BuildEase2026/mf-icf-approval-1f4119fc49/ALW/docs/struct/ES26-020-ALW-RF-00 Alwen - Wall Plate Setting-Out for the Truss Designer.pdf

Do not scale. All dimensions in mm. Check all dimensions on site.

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
ICF PACKAGE: Nudura ICF formwork and accessories are our supply. Raft and foundations AS PER THE ARCHITECTURAL DRAWINGS; joist ledgers by the engineer. Floors, stairs, partitions, roof and joinery are drawn as DESIGN ASSUMPTIONS for coordination - check by the relevant professional.

## FOR APPROVAL - NOT FOR CONSTRUCTION

### WALL PLATE SCHEDULE

### 47 X 150 C24 TREATED, TOP +5,076

Plate | Length Runs | On the core
WP1 | 5,804 x 356 - 6,159 | y 101.6 - 251.6
WP2 | 5,804 x 6,445 - 12,248 | y 101.6 - 251.6
WP3 | 5,804 x 356 - 6,159 | y 7739.9 - 7889.9
WP4 | 5,804 x 6,445 - 12,248 | y 7739.9 - 7889.9
x from the left outer ICF face, y from the front outer ICF face.

BEARING

Item | mm
Plate centre from outer face | 176.6
Span between plate centres (front-rear) | 7,638
Outer ICF face to face | 7,992
Heel at the outer face | 183.1
Overhang beyond the outer face | 307

GABLE LADDERS

Item | mm
Gable left (x 0) + right (x 12,604): 2 No. ladders each, one per slope
Section, on edge (ladder depth 122) | 47x122 TR26
Overall width, barge outer to rail inner face | 1,005
Projection beyond the outer ICF face | 326
Back span inside the outer ICF face | 679
About the wall centre (177.8 in): out / in | 504 / 501
Barge + inner rail (per gable) | 4 No. x 5,253
Outriggers (per gable) | | 20 No. x 910 @ 578 on slope
Restraint straps <= 2 m c/c into the ICF core. Gable ICF raked to the ladder underside.
WP1 | WP2
WP3 | WP4
356 | 5804 | 286 | 5804 | 356
| | 12604
356 | 5804 | 286 | 5804 | 356

102

150

7488 150

102

7992

7,638 BEARING c/c

## WALL PLATE SETTING-OUT PLAN

Scale 1:100 | dims from the OUTER ICF face; dashed = eaves line
102 | 150 | 104

47 183.1

307

Trussed rafter
(truss designer)

47x150 C24 PLATE
on the core

M12 resin anchor
@1,200 (engineer)

152.4 CONCRETE
CORE - bearing

101.6 EPS - NOT
STRUCTURAL

## EAVES SECTION AT THE PLATE

Scale 1:10 | front / rear walls (see DT-03)

NOTES
1. FOR THE TRUSS DESIGNER: the external walls are Nudura 6in XR35 insulated concrete formwork - 101.6 EPS foam / 152.4 reinforced concrete core / 101.6 EPS foam (355.6 overall), rendered outside (Dryvit ICF 500), lined inside.
2. The EPS is formwork and insulation only - it is NOT STRUCTURAL and must carry no load. The trusses bear on the 47 x 150 C24 treated WALL PLATE, which sits on the CONCRETE CORE ONLY: 101.6 to 251.6 in from the outer ICF face.
3. Core top +5,029 above GF FFL; plate top (truss bearing) +5,076. All dimensions are from the OUTER face of the ICF (the render adds 8).
4. Plate fixing: M12 resin anchors into the core @ 1,200 max, 300 from each end and each side of every joint - DESIGN ASSUMPTION, engineer to confirm. Truss clips to the plate and restraint straps by the truss designer.
5. Heel 183.1 (plate top to rafter top at the outer ICF face); eaves overhang 307 beyond the outer ICF face (tiles 382). Pitch 35 deg.
6. GABLE ROOF: plates on the front and rear eaves walls only, stopping at the gable inner faces; the gables are raked ICF under 47 x 122 TR26 gable ladders (no plate on the gables).
7. PARTY WALL (6in Standard, 285.8): the plates stop either side of it; the party wall rises to the roof line between the two roofs - no trusses bear on it.
8. Alwen 4P2B Type A (semi). Datum 0 = GF FFL. Architect: Beech Developments -BD0165-ALW rev A (JHG 28/08/26).

REVISIONS

REV | DATE | DESCRIPTION
P01 | 29.10.26 | Approval issue

CLIENT
Beech Developments (NW) Ltd

PROJECT
Maes Y Felin, Glan Conwy - Alwen

DRAWING TITLE

## ALWEN - WALL PLATE SETTING-OUT FOR THE TRUSS DESIGNER

SCALE
AS SHOWN

SIZE
A3

DATE
29.10.26

DRAWN
TS
CHECKED | APPROVED

STATUS

### FOR APPROVAL

DRAWING No.

# ES26-020-ALW-RF-00

REV

P01
