BuildEase2026/mf-icf-approval-1f4119fc49/sequence/docs/ES26-020-3B4P B07 - Load plans.pdf

# Delivery 1 - Load 1 of 2 - Artic 13.6 m

10 pallets in 5 of 5 floor positions | 163 forms | tallest column 2586 mm of 2650 mm inside height
Column heights do not fall to the tail: unload order was kept, which the crew needs, and it conflicts with loading tallest-forward on this load.

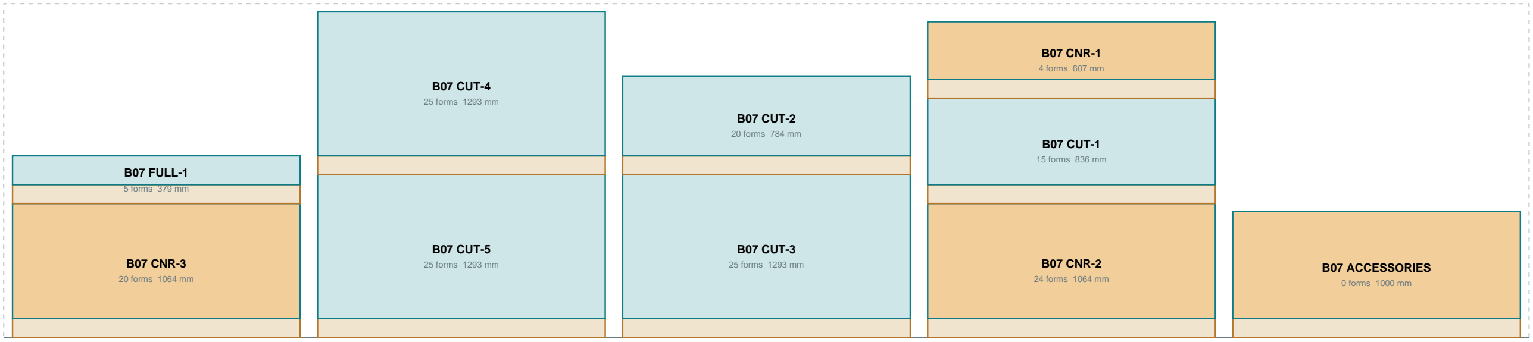
[picture p1: figure]
B07 CNR-3; 20 forms 1064 mm; B07 FULL-1; 5 forms 379 mm; B07 CUT-5; 25 forms 1293 mm; B07 CUT-4; B07 CUT-3; B07 CUT-2; 20 forms 784 mm; B07 CNR-2; 24 forms 1064 mm; B07 CUT-1; 15 forms 836 mm; B07 CNR-1; 4 forms 607 mm; B07 ACCESSORIES; 0 forms 1000 mm

HEADBOARD | TAIL

inside height 2650 mm

position 1

position 2

position 3

position 4

position 5

Unload order - 9 of 9 pallets come off out of build order, the price of stacking tallest forward
1. B07 ACCESSORIES 6in XR35 accessoriess 0 forms courses -
2. B07 CNR-1 6in XR35 corners 4 forms courses FB course 1
3. B07 CUT-1 6in XR35 straights 15 forms courses FB course 1
4. B07 CNR-2 6in XR35 corners 24 forms courses L1 courses 1-6
5. B07 CUT-2 6in Std straights 20 forms courses L1 courses 1-6
6. B07 CUT-3 6in XR35 straights 25 forms courses L1 courses 1-6
7. B07 CUT-4 6in XR35 straights 25 forms courses L1 courses 2-5
8. B07 CUT-5 6in XR35 straights 25 forms courses L1 courses 4-6
9. B07 FULL-1 6in XR35 straights 5 forms courses L1 course 6
10. B07 CNR-3 6in XR35 corners 20 forms courses L2 courses 1-5
WAGON STACKING PLAN | D1 LOAD 1

Tallest column at the headboard; last needed on the floor

PROJECT | ES26-020 Maes Y Felin - B07 plots 16, 17
VEHICLE | Artic 13.6 m
PALLETS | 10
FORMS | 163
POSITIONS | 5 of 5
TALLEST | 2586 mm

# Delivery 1 - Load 2 of 2 - 18 t rigid

5 pallets in 3 of 3 floor positions | 127 forms | tallest column 2586 mm of 2650 mm inside height
Column heights do not fall to the tail: unload order was kept, which the crew needs, and it conflicts with loading tallest-forward on this load.
HEADBOARD | TAIL

inside height 2650 mm

B07 CUT-10
21 forms 1293 mm

position 1

B07 CUT-9
25 forms 1293 mm

B07 CUT-8
25 forms 1293 mm

position 2

B07 CUT-6
31 forms 1259 mm

B07 CUT-7
25 forms 1293 mm

position 3

Unload order - 4 of 4 pallets come off out of build order, the price of stacking tallest forward
1. B07 CUT-7 6in XR35 straights 25 forms courses L2 courses 1, 2, 3, 5, 7, 9
2. B07 CUT-6 6in Std straights 31 forms courses L2 courses 1-12
3. B07 CUT-8 6in XR35 straights 25 forms courses L2 courses 3-7
4. B07 CUT-9 6in XR35 straights 25 forms courses L2 courses 5, 6, 7, 9, 10
5. B07 CUT-10 6in XR35 straights 21 forms courses L2 courses 7-11
WAGON STACKING PLAN | D1 LOAD 2

Tallest column at the headboard; last needed on the floor

PROJECT | ES26-020 Maes Y Felin - B07 plots 16, 17
VEHICLE | 18 t rigid
PALLETS | 5
FORMS | 127
POSITIONS | 3 of 3
TALLEST | 2586 mm
