BuildEase2026/mf-icf-approval-1f4119fc49/sequence/docs/ES26-020-ALW B01 - Load plans.pdf

# Delivery 1 - Load 1 of 2 - Artic 13.6 m

9 pallets in 5 of 5 floor positions | 156 forms | tallest column 2394 mm of 2650 mm inside height
Column heights do not fall to the tail: unload order was kept, which the crew needs, and it conflicts with loading tallest-forward on this load.

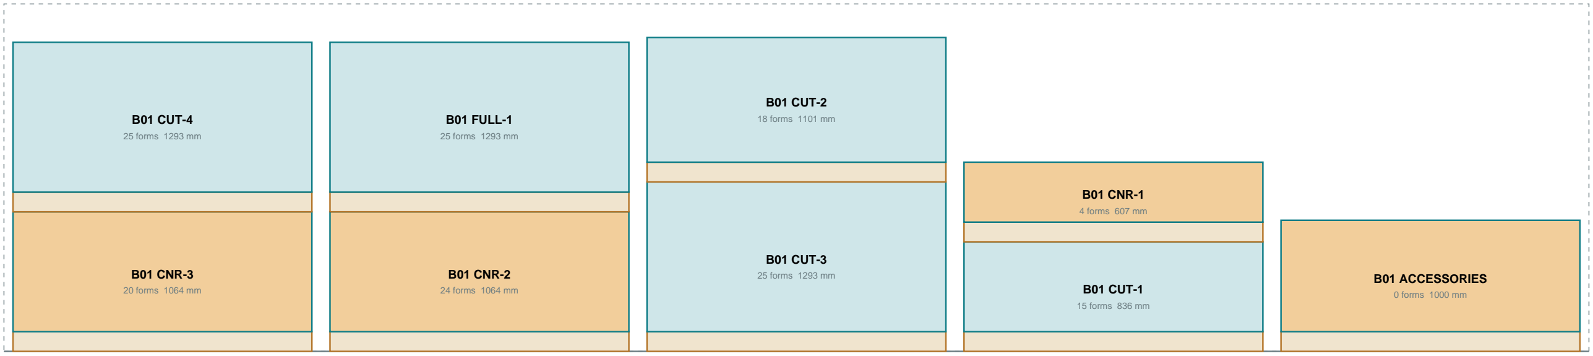
[picture p2: figure]
B01 CNR-3; 20 forms 1064 mm; B01 CUT-4; 25 forms 1293 mm; B01 CNR-2; 24 forms 1064 mm; B01 FULL-1; B01 CUT-3; B01 CUT-2; 18 forms 1101 mm; B01 CUT-1; 15 forms 836 mm; B01 CNR-1; 4 forms 607 mm; B01 ACCESSORIES; 0 forms 1000 mm

HEADBOARD | TAIL

inside height 2650 mm

position 1

position 2

position 3

position 4

position 5

Unload order - 8 of 8 pallets come off out of build order, the price of stacking tallest forward
1. B01 ACCESSORIES 6in XR35 accessoriess 0 forms courses -
2. B01 CNR-1 6in XR35 corners 4 forms courses FB course 1
3. B01 CUT-1 6in XR35 straights 15 forms courses FB course 1
4. B01 CUT-2 6in Std straights 18 forms courses L1 courses 1-6
5. B01 CUT-3 6in XR35 straights 25 forms courses L1 courses 1-6
6. B01 FULL-1 6in XR35 straights 25 forms courses L1 courses 1-5
7. B01 CNR-2 6in XR35 corners 24 forms courses L1 courses 1-6
8. B01 CUT-4 6in XR35 straights 25 forms courses L1 courses 3-6
9. B01 CNR-3 6in XR35 corners 20 forms courses L2 courses 1-5
WAGON STACKING PLAN | D1 LOAD 1

Tallest column at the headboard; last needed on the floor

PROJECT | ES26-020 Maes Y Felin - B01 plots 8, 9
VEHICLE | Artic 13.6 m
PALLETS | 9
FORMS | 156
POSITIONS | 5 of 5
TALLEST | 2394 mm

# Delivery 1 - Load 2 of 2 - 18 t rigid

5 pallets in 3 of 3 floor positions | 118 forms | tallest column 2586 mm of 2650 mm inside height
Column heights do not fall to the tail: unload order was kept, which the crew needs, and it conflicts with loading tallest-forward on this load.
HEADBOARD | TAIL

inside height 2650 mm

B01 CUT-8
16 forms 1293 mm

position 1

B01 CUT-7
24 forms 1293 mm

B01 CUT-5
28 forms 1259 mm

position 2

B01 CUT-6
25 forms 1293 mm

B01 FULL-2
25 forms 1293 mm

position 3

Unload order - 4 of 4 pallets come off out of build order, the price of stacking tallest forward
1. B01 FULL-2 6in XR35 straights 25 forms courses L2 courses 1-5
2. B01 CUT-6 6in XR35 straights 25 forms courses L2 courses 1, 2, 3, 4, 5, 6, 7, 10, 11
3. B01 CUT-5 6in Std straights 28 forms courses L2 courses 1-12
4. B01 CUT-7 6in XR35 straights 24 forms courses L2 courses 3, 4, 5, 6, 8, 10
5. B01 CUT-8 6in XR35 straights 16 forms courses L2 courses 5-10
WAGON STACKING PLAN | D1 LOAD 2

Tallest column at the headboard; last needed on the floor

PROJECT | ES26-020 Maes Y Felin - B01 plots 8, 9
VEHICLE | 18 t rigid
PALLETS | 5
FORMS | 118
POSITIONS | 3 of 3
TALLEST | 2586 mm
