BuildEase2026/mf-icf-approval-1f4119fc49/sequence/docs/ES26-020-OGW B04 - Load plans.pdf

# Delivery 1 - Load 1 of 1 - Artic 13.6 m

10 pallets in 5 of 5 floor positions | 165 forms | tallest column 2586 mm of 2650 mm inside height
Column heights do not fall to the tail: unload order was kept, which the crew needs, and it conflicts with loading tallest-forward on this load.

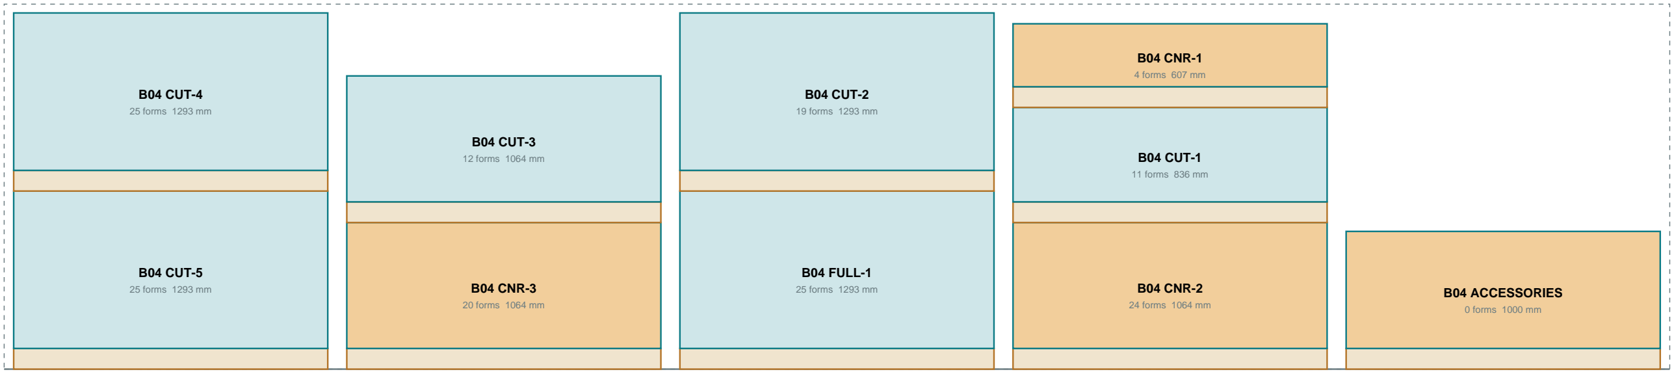
[picture p4: figure]
B04 CUT-5; 25 forms 1293 mm; B04 CUT-4; B04 CNR-3; 20 forms 1064 mm; B04 CUT-3; 12 forms 1064 mm; B04 FULL-1; B04 CUT-2; 19 forms 1293 mm; B04 CNR-2; 24 forms 1064 mm; B04 CUT-1; 11 forms 836 mm; B04 CNR-1; 4 forms 607 mm; B04 ACCESSORIES; 0 forms 1000 mm

HEADBOARD | TAIL

inside height 2650 mm

position 1

position 2

position 3

position 4

position 5

Unload order - 9 of 9 pallets come off out of build order, the price of stacking tallest forward
1. B04 ACCESSORIES 6in XR35 accessoriess 0 forms courses -
2. B04 CNR-1 6in XR35 corners 4 forms courses FB course 1
3. B04 CUT-1 6in XR35 straights 11 forms courses FB course 1
4. B04 CNR-2 6in XR35 corners 24 forms courses L1 courses 1-6
5. B04 CUT-2 6in XR35 straights 19 forms courses L1 courses 1-6
6. B04 FULL-1 6in XR35 straights 25 forms courses L1 courses 1-6
7. B04 CUT-3 6in XR35 straights 12 forms courses L1 courses 3-6
8. B04 CNR-3 6in XR35 corners 20 forms courses L2 courses 1-5
9. B04 CUT-4 6in XR35 straights 25 forms courses L2 courses 1-5
10. B04 CUT-5 6in XR35 straights 25 forms courses L2 courses 4-5
WAGON STACKING PLAN | D1 LOAD 1

Tallest column at the headboard; last needed on the floor

PROJECT | ES26-020 Maes Y Felin - B04 plots 13
VEHICLE | Artic 13.6 m
PALLETS | 10
FORMS | 165
POSITIONS | 5 of 5
TALLEST | 2586 mm
