BuildEase2026/mf-icf-approval-1f4119fc49/3B4P/docs/details/ES26-020-3B4P-DT-02 Raft Edge Detail.pdf

Do not scale. All dimensions in millimetres, levels in metres from GF FFL. Check all dimensions on site.

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
ICF PACKAGE: Nudura ICF formwork and accessories are our supply. Raft and foundations AS PER THE ARCHITECTURAL DRAWINGS; joist ledgers by the engineer. Floors, stairs, partitions, roof and joinery are drawn as DESIGN ASSUMPTIONS for coordination - check by the relevant professional.

## FOR APPROVAL - NOT FOR CONSTRUCTION

NOTES
1. AS PER THE ARCHITECTURAL DRAWINGS - Beech section A-A governs the raft.
2. Flat insulated raft: 257.2 RC slab on 200 PIR (2 x 100 staggered) inside a one-course
(457.2) edge of UNASSEMBLED 6in XR35 panel - the external face only, pre-cut. No vertical joint clips on the single-sided edge.
3. The L1 6in XR35 wall over bears its core and inner panel on the slab; starters core to slab by the engineer.
4. Slab, reinforcement and bearings by the engineer. Quantities: myf_raft.py, this house type.
5. 3B4P (semi pair), plots 16-17, building B07. Datum 0 = GF FFL. Architect: Beech Developments - BD0154-3B4P rev A (JHG 26/10/26).

REVISIONS

REV | DATE | DESCRIPTION
P01 | 03.11.26 | Approval issue

CLIENT
Beech Developments (NW) Ltd

PROJECT
Maes Y Felin, Glan Conwy - 3B4P

DRAWING TITLE

## 3B4P - RAFT EDGE DETAIL

SCALE
1:10 @ A2

SIZE
A2

DATE
03.11.26

DRAWN
TS
CHECKED | APPROVED

STATUS

### FOR APPROVAL

DRAWING No.

# ES26-020-3B4P-DT-02

REV

P01

FFL 0 (DPC)

FGL ~50 below FFL (as drawn)

457.2

1 course

257.2 200 150

800

101.6

UNASSEMBLED 6in XR35 PANEL - external face only, 1 course on the MOT, PRE-CUT, optimised on its own (2 faces per unassembled form)

RC35 slab 257.2 (FN01 note: 200) - A393 T&B, 40 cover

200 PIR = 2 layers of 100, joints staggered, under the WHOLE slab (FN01 note: 150) Type 3 MOT 150 to 800 beyond Nudura, perimeter land drain

gravel strip

starters core -> slab (engineer)

L1 6in XR35 wall over (355.6), core + inner panel bear on the slab

SECTION DETAIL - RAFT EDGE (single-sided unassembled 6in XR35 panel)

1:10 - as drawn on Beech section A-A

QUANTITIES - one 3B4P

Slab outline (inside panel) | 12.049 x 8.449 m
Concrete @ 257.2 | 26.18 m3 (order 27.5 m3 +5%)
PIR 2 x 100, joints staggered | 2 x 101.8 m2 (38 boards / layer)
Type 3 MOT 150 | 21.3 m3 / 44.7 t
Edge panel face, 1 course | 41.81 lm
