BuildEase2026/mf-icf-approval-1f4119fc49/3B4P/docs/icf/ES26-020-3B4P-EL-01 North and South Elevations.pdf

Do not scale. All dimensions in millimetres, levels in metres from GF FFL. Check all dimensions on site.

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
ICF PACKAGE: Nudura ICF formwork and accessories are our supply. Raft and foundations AS PER THE ARCHITECTURAL DRAWINGS; joist ledgers by the engineer. Floors, stairs, partitions, roof and joinery are drawn as DESIGN ASSUMPTIONS for coordination - check by the relevant professional.

-457 U/S raft-edge ICF

FFL 0 GF FFL

+2134

+2600 FF FFL

+2743 L1 / L2 form joint

+4725

+5029 Eaves (top of ICF)

+5076

621 | 1435 | 377 | 1200 34 | 1532 | 1856 | 1532 | 34 1200 | 377 | 1435 | 620
| | | | | 12253
U1-L1-W3 | U1-L1-W2

U1-L1-D2

U2-L1-W2 | U2-L1-W3

U2-L1-D2

U2-L2-W7 | U2-L2-W8 | U1-L2-W8 | U1-L2-W7

## REAR ELEVATION

Scale 1:125 @ A3 | Levels above GF FFL; sills and heads in the schedule

-457 U/S raft-edge ICF

FFL 0 GF FFL

+2134

+2600 FF FFL

+2743 L1 / L2 form joint

+4725

+5029 Eaves (top of ICF)

+5076

1078 | 1320 | 1272 | 1875 | 1162 | 1875 | 1272 | 1320 | 1079
| | | | 12253

U1-L1-D1

U1-L1-W1
U2-L1-D1

U2-L1-W1

U1-L2-W5 | U1-L2-W4 | U2-L2-W4 | U2-L2-W5

## FRONT ELEVATION

Scale 1:125 @ A3 | Levels above GF FFL; sills and heads in the schedule
0 | 1 | 2 | 3 | 4 | 5m

ICF external EPS face
Block course joint
Stack joint
Roof build-up (slab / earth / sedum)

## FOR APPROVAL - NOT FOR CONSTRUCTION

## ELEVATION SCHEDULES

### REAR ELEVATION: OPENINGS

Ref | Width | Height | Sill | Head | Lintel
U1-L1-W2 | 550 | 1092 | +1042 | +2134 | -
U1-L1-W3 | 1200 | 1092 | +1042 | +2134 | -
U1-L1-D2 | 1070 | 2134 | 0 | +2134 | -
U1-L2-W7 | 970 | 1092 | +3633 | +4724 | -
U1-L2-W8 | 1320 | 1244 | +3480 | +4724 | -
U2-L1-W2 | 550 | 1092 | +1042 | +2134 | -
U2-L1-W3 | 1200 | 1092 | +1042 | +2134 | -
U2-L1-D2 | 1070 | 2134 | 0 | +2134 | -
U2-L2-W7 | 970 | 1092 | +3633 | +4724 | -
U2-L2-W8 | 1320 | 1244 | +3480 | +4724 | -
Structural openings in the ICF; sill and head above GF FFL.

### FRONT ELEVATION: OPENINGS

Ref | Width | Height | Sill | Head | Lintel
U1-L1-D1 | 1070 | 2134 | 0 | +2134 | -
U1-L1-W1 | 1875 | 1397 | +737 | +2134 | -
U1-L2-W5 | 1320 | 1244 | +3480 | +4724 | -
U1-L2-W4 | 1320 | 1244 | +3480 | +4724 | -
U2-L1-D1 | 1070 | 2134 | 0 | +2134 | -
U2-L1-W1 | 1875 | 1397 | +737 | +2134 | -
U2-L2-W5 | 1320 | 1244 | +3480 | +4724 | -
U2-L2-W4 | 1320 | 1244 | +3480 | +4724 | -
Structural openings in the ICF; sill and head above GF FFL.

### LEVELS ON THESE ELEVATIONS

Level | | | | | FFL
U/S raft-edge ICF | | | | | -457
GF FFL | | | | | 0
top of ICF | | | | | +2134
FF FFL | | | | | +2600
L1 / L2 form joint | | | | | +2743
top of ICF | | | | | +4725
Eaves (top of ICF) | | | | | +5029
top of roof build-up | | | | | +5076

## NOTES

1. ICF: Nudura 6" XR35, 101.6 EPS + 152.4 core + 101.6 EPS = 355.6; 6" Std, 66.7 EPS + 152.4 core + 66.7 EPS = 285.8. External EPS face shown with the block course joints, vertical block joints and stack joints as populated.
2. Levels above GF FFL. Openings are structural openings in the ICF; glazing, doors, render and finishes by others, not shown.
3. Roof build-up shown as modelled.
4. See ES26-020-3B4P-GA-01 for plan setting out, lintels and steel.
5. 3B4P (semi pair), plots 16-17, building B07. Datum 0 = GF FFL. Architect: Beech Developments - BD0154-3B4P rev A (JHG 26/10/26).

## REVISIONS

REV | DATE | DESCRIPTION
P01 | 03.11.26 | Approval issue

CLIENT

### Beech Developments (NW) Ltd

PROJECT

### Maes Y Felin, Glan Conwy - 3B4P

DRAWING TITLE

## NORTH AND SOUTH ELEVATIONS

ICF elevations with openings, levels and roof build-up

SCALE
1:125

SIZE
A3

DATE
03.11.26

DRAWN
TS
CHECKED | APPROVED

STATUS

## FOR APPROVAL

DRAWING No.

# ES26-020-3B4P-EL-01

REV

P01
