BuildEase2026/mf-icf-approval-1f4119fc49/3B4P/docs/struct/ES26-020-3B4P-RF-01 3B4P - Roof Truss Layout.pdf

Do not scale. All dimensions in mm. Check all dimensions on site.

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
ICF PACKAGE: Nudura ICF formwork and accessories are our supply. Raft and foundations AS PER THE ARCHITECTURAL DRAWINGS; joist ledgers by the engineer. Floors, stairs, partitions, roof and joinery are drawn as DESIGN ASSUMPTIONS for coordination - check by the relevant professional.

## FOR APPROVAL - NOT FOR CONSTRUCTION

## ROOF STRUCTURE SCHEDULES

## TRUSS SCHEDULE

Type | Description | Bottom chord | Top chord | Qty
T1 | Fink (W) 35 deg, duo-pitch | 8,449 | 35x97 TR26 | 20
| Total trusses | | | 20
Profiles, spans, rise and member sizes on ES26-020-3B4P-RF-02.

### LOOSE ROOF TIMBER

Item | Section | Length | Qty
Barge (gable ladder outer rail) | 47x122 TR26 | 5,656 | 4
Binder / diagonal brace | 22x97 C16 | 6,295 | 4
Binder / diagonal brace | 22x97 C16 | 5,284 | 6
Gable ladder inner rail | 47x122 TR26 | 5,656 | 4
Ladder outrigger | 47x122 TR26 | 910 | 44
Wall plate on the ICF core | 47x150 C24 | 5,628 | 4

### ROOF METALWORK

Item | | | | Qty
Gable restraint strap 30 x 5 (HES) | 12
Truss clip to plate (TCP38) | 40

GABLE LADDERS

Item | | | | mm
Gable left (x 0) + right (x 12,252): 2 No. ladders each, one per slope
Section, on edge (ladder depth 122) | 47x122 TR26
Overall width, barge outer to rail inner face | 1,005
Projection beyond the outer ICF face | 326
Back span inside the outer ICF face | 679
About the wall centre (177.8 in): out / in | 504 / 501
Barge + inner rail (per gable) | 4 No. x 5,656
Outriggers (per gable) | 22 No. x 910 @ 561 on slope
Restraint straps <= 2 m c/c into the ICF core. Gable ICF raked to the ladder underside.

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
697 | 600 | 600 | 600 | 600 | 600 | 600 | 600 | 600 | 449 | 360 | 450 | 600 | 600 | 600 | 600 | 600 | 600 | 600 | 600 | 696
6126 | 6126

12252

12,904 OVERALL ROOF

307 4326 4326 307

RIDGE

GABLE LADDER 47x122 TR26: barge + inner rail, outriggers <= 600 c/c

Binders 22x97 C16: apex,
ceiling, diagonal braces

WALL PLATE 47x150 C24 on the ICF core, top +5,076

FRONT

## ROOF STRUCTURE PLAN

Scale 1:75 @ A3 | Plan on the roof structure, tiles / battens / membrane / PV omitted | 0 | 1 | 2 | 3 | 4 | 5m
Trussed rafter (type T) | Gable ladder | Binder / diagonal brace
Wall plate on the ICF core | ICF walls (outline)

## NOTES

1. Roof trusses, gable ladders, binders and metalwork as modelled (TLS roof framer) - a DESIGN ASSUMPTION for coordination. The truss manufacturer designs the trusses and the bracing to BS EN 1995-1-1 / BS 5268-3 and confirms the spacing, member sizes and metalwork.
2. 2 roof bays (one per dwelling, set out from each gable, party edge on the party wall core faces): 20 No. Fink trusses at 600 c/c (closing bay 449), 35 deg, on 47 x 150 C24 wall plates bedded on the ICF core of the eaves walls, plate top +5,076 above GF FFL (eaves walls flat at +5,029.2).
3. Gable ends: gable ladders 47x122 TR26 (Beech standard: barge + inner rail + outriggers <= 600 c/c), restraint straps <= 2 m c/c. Party wall carried up to the underside of the tiles (fire stop by others).
4. Truss clips TCP38 at every bearing. All levels above GF FFL. Dimensions in mm.
5. 3B4P (semi pair), plots 16-17, building B07. Datum 0 = GF FFL. Architect: Beech Developments - BD0154-3B4P rev A (JHG 26/10/26).

## REVISIONS

REV | DATE | DESCRIPTION
P01 | 03.11.26 | Approval issue

CLIENT

### Beech Developments (NW) Ltd

PROJECT

### Maes Y Felin, Glan Conwy - 3B4P

DRAWING TITLE

## 3B4P - ROOF TRUSS LAYOUT

Fink trusses, gable ladders, binders, wall plates

SCALE

### AS SHOWN

SIZE
A3

DATE
03.11.26

DRAWN
TS
CHECKED | APPROVED

STATUS

## FOR APPROVAL

DRAWING No.

# ES26-020-3B4P-RF-01

REV

P01
