BuildEase2026/mf-icf-approval-1f4119fc49/3B4P/docs/struct/ES26-020-3B4P-RF-02 3B4P - Truss Profiles.pdf

Do not scale. All dimensions in mm. Check all dimensions on site.

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
ICF PACKAGE: Nudura ICF formwork and accessories are our supply. Raft and foundations AS PER THE ARCHITECTURAL DRAWINGS; joist ledgers by the engineer. Floors, stairs, partitions, roof and joinery are drawn as DESIGN ASSUMPTIONS for coordination - check by the relevant professional.

## FOR APPROVAL - NOT FOR CONSTRUCTION

### TRUSS TYPES

a
c

b

d

e | f

g

409 | 2817 | 1408 | 1408 | 2817 | 409

SPAN 8,449 (plate to plate, core outer faces)

OVERALL 9,266

183 2,958

RISE 3,141

35°

T1 FINK (W) TRUSS - 20 No. (1:50)

T1 FINK - 20 NO.

| Member | Section | Length
a | top chord | 35x97 TR26 | 5,656
b | bottom chord | 35x97 TR26 | 8,449
c | top chord | 35x97 TR26 | 5,656
d | web | 35x72 TR26 | 1,706
e | web | 35x72 TR26 | 3,344
f | web | 35x72 TR26 | 3,344
g | web | 35x72 TR26 | 1,706
Span 8,449, overall 9,266, pitch 35 deg, rise 3,141, heel 183 (plate top to top of top chord over the core outer face), overhang 409 past the core face. Plate +5,076, apex +8,217.

NOTES
1. DESIGN ASSUMPTION for coordination: the trussed rafter manufacturer designs the final trusses (members, joints, nail plates, bracing) to BS EN 1995-1-1 for the stated loads and confirms all sizes before manufacture.
2. Profiles drawn to scale from the approval model member geometry: TR26 strength class, 35 wide members, nail-plated joints. Member marks a, b, c ... refer to the member tables.
3. Design brief (ASSUMED, truss supplier / engineer to confirm): concrete interlocking tiles on battens and breathable membrane + solar PV (0.73 kN/m2 over the whole roof), plasterboard ceiling, loft not habitable; Glan Conwy LL28, altitude ~25 m, snow zone 2, vb 24 m/s, exposed (estuary).
4. Trusses bear on 47 x 150 C24 wall plates on the ICF core of the eaves walls (plate top +5,076).
5. Gable ladders, binders, bracing and clips are listed on ES26-020-3B4P-RF-01.
6. 3B4P (semi pair), plots 16-17, building B07. Datum 0 = GF FFL. Architect: Beech Developments - BD0154-3B4P rev A (JHG 26/10/26).

REVISIONS

REV | DATE | DESCRIPTION
P01 | 03.11.26 | Approval issue

CLIENT
Beech Developments (NW) Ltd

PROJECT
Maes Y Felin, Glan Conwy - 3B4P

DRAWING TITLE

## 3B4P - TRUSS PROFILES

Trussed rafter profiles (design assumption)

SCALE
AS SHOWN

SIZE
A3

DATE
03.11.26

DRAWN
TS
CHECKED | APPROVED

STATUS

### FOR APPROVAL

DRAWING No.

# ES26-020-3B4P-RF-02

REV

P01
