BuildEase2026/mf-icf-approval-1f4119fc49/OGW/docs/struct/ES26-020-OGW-FL-01 Ogwen - First Floor Layout.pdf

Do not scale. All dimensions in mm. Check all dimensions on site.

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
ICF PACKAGE: Nudura ICF formwork and accessories are our supply. Raft and foundations AS PER THE ARCHITECTURAL DRAWINGS; joist ledgers by the engineer. Floors, stairs, partitions, roof and joinery are drawn as DESIGN ASSUMPTIONS for coordination - check by the relevant professional.

## FOR APPROVAL - NOT FOR CONSTRUCTION

### FIRST FLOOR SCHEDULES

JOIST SCHEDULE (253 DEEP, @600)

Type | O/A | Bottom | U1 | Total
J1 | 5,044 | 4,997 | 5 | 5
J2 | 4,987 | 4,940 | 1 | 1
J3 | 4,376 | 4,329 | 1 | 1
J4 | 4,006 | 3,959 | 7 | 7
J5 | 3,122 | 3,075 | 7 | 7
J6 | 2,084 | 2,037 | 3 | 3
J7 | 1,640 | 1,640 | 1 | 1
J8 | 1,028 | 1,028 | 1 | 1
J9 | 971 | 971 | 2 | 2
| Total | | 28 | 28
O/A = top flange overall length; Bottom = bottom flange length. Includes 0 No. in doubled trimming pairs. Profiles on ES26-020-OGW-FL-02.

LEDGERS, STRONGBACKS, TRIMMERS (C24)

Item | Length | Qty
2 No. 47x225 trimmer, bolted (stair well) | 2,528 | 1
47x150 deck-edge ledger | 7,044 | 2
47x150 strongback | 7,249 | 1
47x178 ledger cut-down ledger | 7,363 | 1
47x178 ledger cut-down ledger | 3,446 | 1
47x178 ledger cut-down ledger | 1,383 | 1

METALWORK AND DECK

Item | | | | Qty
22 Egger Protect P5 T&G board | 48
Face-fix joist hanger | | | | 4
Face-fix trimmer hanger | | | | 2
Strong-Tie ICFVL-CW + ICFLC connector | 27
Top-chord restraint clip (galv) | 24

STAIR
WELL
J1 | J6

J1 J6

J1 | J6
J1 | J9
J1 | J9
J2 | J8
J3 | J7
J4 | J5
J4 | J5
J4 | J5
J4 | J4 J5 J5
| J4 J5
| J4 J5

93 600 653 547 600 600 600 259 341 600 600 600 600 576 93

8074

7849

5049 | 2089

GF loadbearing spine (89 stud, head binder +2,325): joists bear on it

47x150 C24 strongback
through the webs

47x178 C24 cut-down
ledger on the ICF,
joists top-hung

47x150 C24 deck-edge ledger (walls parallel to the joists)

FRONT

## FIRST FLOOR JOIST LAYOUT

Scale 1:75 @ A3 | Plan on the FF joists, deck omitted

STAIR
WELL

2 No. 47x225 C24 trimmer, bolted (stair well edge) on Simpson face-fix trimmer hangers

Trimming joists each side of the well (single where short to the spine, else bolted pair)

J8 trimmed joists face-fix hung off the trimmer

547 600 600 600 259 341

WELL 2,528

WELL 1,019

## STAIR WELL FRAMING U1 - ENLARGED

Scale 1:50

Metal-web joist 253 (type J)

C24 ledger

GF loadbearing spine (below)

Strongback

Connector / hanger / clip

ICF walls (FF outline)

0 | 1 | 2 | 3 | 4 | 5m

NOTES
1. First floor (DESIGN ASSUMPTION for coordination): 253 deep metal-web joists (72 x 47 C24 flanges, Posi-Joist / Easi-Joist equivalent) at 600 c/c spanning x, from the ICF walls onto the GF loadbearing spine (GF spine G8-G12-G2-G7: 89 timber stud, head binder at +2,325).
2. TOP-HUNG at the ICF: the top flange runs over a 47 x 178 C24 ledger (47 x 225 ripped down) and stops 3 short of the ICF face; the bottom flange stops 3 short of the ledger. Galv restraint clip at every ledger bearing. At the spine the joists bear on the head binder, butted over its centre and fixed to it.
3. Ledgers fixed to the ICF with cast-in Simpson Strong-Tie ICFVL-CW + ICFLC connectors -ledgers and their fixings by the engineer. Top of ledger +2,531, top of joists +2,578, FF FFL +2,600 above GF FFL.
4. Deck: 22 Egger Protect P5 T&G, glued and screwed to every joist. 47 x 150 C24 deck-edge ledgers on the walls parallel to the joists. 47 x 150 C24 strongback through the webs where shown.
5. Stair well: trimming joists each side - SINGLE where the piece carrying the trimmer spans <= 3,200 to the GF spine, otherwise doubled (bolted pair); 2 No. 47 x 225 C24 trimmer bolted on face-fix trimmer hangers, each hanger at a joist WEB NODE / web stiffener (point load - joist designer to confirm); trimmed joists face-fix hung. Joist supplier / engineer to design and confirm joist depth, spacing, bracing and bearings (clear spans are long for 253 joists - design assumption, joist supplier to confirm).
6. Ogwen 5P4B (detached). Datum 0 = GF FFL. Architect: Beech Developments -BD0154-OGW rev A (JHG 28/10/26).

REVISIONS

REV | DATE | DESCRIPTION
P01 | 29.10.26 | Approval issue

CLIENT
Beech Developments (NW) Ltd

PROJECT
Maes Y Felin, Glan Conwy - Ogwen

DRAWING TITLE

## OGWEN - FIRST FLOOR LAYOUT

Metal-web joists, ledgers, GF spine bearing, stair well trimming

SCALE
AS SHOWN

SIZE
A3

DATE
29.10.26

DRAWN
TS
CHECKED | APPROVED

STATUS

### FOR APPROVAL

DRAWING No.

# ES26-020-OGW-FL-01

REV

P01
