BuildEase2026/mf-icf-approval-1f4119fc49/OGW/docs/struct/ES26-020-OGW-FL-02 Ogwen - Floor Joist Profiles.pdf

Do not scale. All dimensions in mm. Check all dimensions on site.

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
ICF PACKAGE: Nudura ICF formwork and accessories are our supply. Raft and foundations AS PER THE ARCHITECTURAL DRAWINGS; joist ledgers by the engineer. Floors, stairs, partitions, roof and joinery are drawn as DESIGN ASSUMPTIONS for coordination - check by the relevant professional.

## FOR APPROVAL - NOT FOR CONSTRUCTION

### JOIST TYPES

JOIST SCHEDULE

Type | O/A | Bottom | Depth | Flanges | Qty
J1 | 5,044 | 4,997 | 253 | 72x47 | 5
J2 | 4,987 | 4,940 | 253 | 72x47 | 1
J3 | 4,376 | 4,329 | 253 | 72x47 | 1
J4 | 4,006 | 3,959 | 253 | 72x47 | 7
J5 | 3,122 | 3,075 | 253 | 72x47 | 7
J6 | 2,084 | 2,037 | 253 | 72x47 | 3
J7 | 1,640 | 1,640 | 253 | 72x47 | 1
J8 | 1,028 | 1,028 | 253 | 72x47 | 1
J9 | 971 | 971 | 253 | 72x47 | 2
| | | | Total | 28
Qty = all units of the type. Metal-web joist equivalent, supplier to design.

WHERE USED (ENDS ALONG +X)

Type | Location
J1 | ICF ledger to GF spine; U1
J2 | ICF ledger to GF spine; U1
J3 | ICF ledger to GF spine; U1
J4 | ICF ledger to GF spine; U1
J5 | GF spine to ICF ledger; U1
J6 | GF spine to ICF ledger; U1
J7 | GF spine to stair trimmer; U1
J8 | GF spine to stair trimmer; U1
J9 | GF spine to stair trimmer; U1

TOP FLANGE O/A 5,044

BOTTOM 4,997

J1 5,044 O/A x 253 - 5 No.

ICF ledger -> GF spine (same ends: J2 4,987, J3 4,376, J4 4,006)

TOP FLANGE O/A 3,122

BOTTOM 3,075

J5 3,122 O/A x 253 - 7 No.

GF spine -> ICF ledger (same ends: J6 2,084)

TOP FLANGE O/A 1,640

BOTTOM 1,640

J7 1,640 O/A x 253 - 1 No.

GF spine -> stair trimmer (same ends: J8 1,028, J9 971)

Elevations 1:25 (ICF ledger / GF spine head / stair trimmer at each end shown for context)

3

3

28 178 47 22

ICF wall: 101.6 EPS + 152.4 core + 101.6 EPS

47x178 C24 ledger (47x225 ripped), top +2,531, cast-in Strong-Tie ICFVL-CW + ICFLC (engineer)

Top flange 72x47 over the ledger, 3 short of the ICF; galv clip

Bottom flange stops 3 short of the ledger face

22 P5 T&G deck, FF FFL +2,600

## TOP-HUNG BEARING ON CUT-DOWN LEDGER

Scale 1:10 | typical at the ICF walls

47 253 22

119

Spine head binder
top +2,325

89 timber stud
(GF loadbearing)

Joists butted over
the binder, skew-nailed
+ galv clip each side

## BEARING ON THE GF LOADBEARING SPINE

Scale 1:10 | GF spine G8-G12-G2-G7 (engineer to confirm)

NOTES
1. DESIGN ASSUMPTION for coordination: 253 deep metal-web joists, e.g. Posi-Joist / Easi-Joist equivalent, 72 x 47 C24 (or stress-graded) flanges with galvanised V-web plates. The joist supplier designs the joists for the stated loads and confirms depth, web layout and spacing.
2. Loads (to be confirmed by the supplier): domestic floor, imposed 1.5 kN/m2 + lightweight stud partitions over, 22 Egger Protect P5 deck, plasterboard ceiling under. 600 c/c, spans onto the GF loadbearing spine.
3. Ends: TOP-HUNG at the ICF - top flange over the 47 x 178 C24 ledger to 3 short of the ICF face, bottom flange 3 short of the ledger, galv clip to the ledger; at the GF spine bearing on the head binder, butted over its centre; trimmed joists face-fix hung off the stair trimmer.
4. Web pattern shown is indicative (from the approval model); webs at the supplier's standard pitch.
5. Ogwen 5P4B (detached). Datum 0 = GF FFL. Architect: Beech Developments -BD0154-OGW rev A (JHG 28/10/26).

REVISIONS

REV | DATE | DESCRIPTION
P01 | 29.10.26 | Approval issue

CLIENT
Beech Developments (NW) Ltd

PROJECT
Maes Y Felin, Glan Conwy - Ogwen

DRAWING TITLE

## OGWEN - FLOOR JOIST PROFILES

Metal-web joist profiles (design assumption)

SCALE
1:25 / 1:10

SIZE
A3

DATE
29.10.26

DRAWN
TS
CHECKED | APPROVED

STATUS

### FOR APPROVAL

DRAWING No.

# ES26-020-OGW-FL-02

REV

P01
