BuildEase2026/mf-icf-approval-1f4119fc49/OGW/docs/struct/ES26-020-OGW-RF-02 Ogwen - Truss Profiles.pdf

Do not scale. All dimensions in mm. Check all dimensions on site.

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
ICF PACKAGE: Nudura ICF formwork and accessories are our supply. Raft and foundations AS PER THE ARCHITECTURAL DRAWINGS; joist ledgers by the engineer. Floors, stairs, partitions, roof and joinery are drawn as DESIGN ASSUMPTIONS for coordination - check by the relevant professional.

## FOR APPROVAL - NOT FOR CONSTRUCTION

### TRUSS TYPES

a | c

b

d

e | f

g

409 | 2624 | 1311 | 1311 | 2624 | 409

SPAN 7,871 (plate to plate, core outer faces)

OVERALL 8,688

183 2,756

RISE 2,939

35°

T1 FINK (W) TRUSS - 1 No. (1:75)

T1 FINK - 1 NO.

| Member | Section | Length
a | top chord | 35x97 TR26 | 5,303
b | bottom chord | 35x72 TR26 | 7,871
c | top chord | 35x97 TR26 | 5,303
d | web | 35x72 TR26 | 1,606
e | web | 35x72 TR26 | 3,131
f | web | 35x72 TR26 | 3,131
g | web | 35x72 TR26 | 1,606
Span 7,871, overall 8,688, pitch 35 deg, rise 2,939, heel 183 (plate top to top of top chord over the core outer face), overhang 409 past the core face. Plate +5,076, apex +8,015.
a | c

b

d

e | f

g

409 | 2624 | 1311 | 1311 | 2624 | 409

SPAN 7,871 (plate to plate, core outer faces)

OVERALL 8,688

183 2,756

RISE 2,939

35°

G1 2-PLY GIRDER (FINK) - 2 No. (1:75)

G1 GIRDER - 2 NO.

Member | Section | Length
a | top chord | 2/35x97 TR26 | 5,303
b | bottom chord | 2/35x72 TR26 | 7,871
c | top chord | 2/35x97 TR26 | 5,303
d | web | 2/35x72 TR26 | 1,606
e | web | 2/35x72 TR26 | 3,131
f | web | 2/35x72 TR26 | 3,131
g | web | 2/35x72 TR26 | 1,606
Span 7,871, overall 8,688, pitch 35 deg, rise 2,939, heel 183 (plate top to top of top chord over the core outer face), overhang 409 past the core face. Plate +5,076, apex +8,015.

HIP-END FRAMING (AS MODELLED)

Item | Section | Length | Qty | Run m
Hip (one per corner) | 75x295 C24 | 6,424 | 4 | 25.7
Crown rafter (one per hip end) | 63x220 C24 | 4,798 | 2 | 9.6
Jack rafter (hip ends + front / rear slopes) | 63x220 C24 | 877-4,425 | 44 | 113.7
Ceiling joist (hip ends) | 75x245 C24 | 7,871 | 10 | 78.7
Hip ends from each end wall to the girders at x 3,369 / 4,480 (3,369 / 3,369 deep). Manufacturer to design as girder + mono jack trusses in shoes.

NOTES
1. DESIGN ASSUMPTION for coordination: the trussed rafter manufacturer designs the final trusses (members, joints, nail plates, bracing) to BS EN 1995-1-1 for the stated loads and confirms all sizes before manufacture.
2. Profiles drawn to scale from the approval model member geometry: TR26 strength class, 35 wide members, nail-plated joints. Member marks a, b, c ... refer to the member tables.
3. Design brief (ASSUMED, truss supplier / engineer to confirm): concrete interlocking tiles on battens and breathable membrane + solar PV (0.73 kN/m2 over the whole roof), plasterboard ceiling, loft not habitable; Glan Conwy LL28, altitude ~25 m, snow zone 2, vb 24 m/s, exposed (estuary).
4. G = 2-ply girder truss at each end of the hip set, carrying the hip-end framing. The model frames the hip ends loose (hips, crowns, jacks); the manufacturer replaces them with mono jack trusses in girder shoes - the table gives the hip-end extent and lengths.
5. Trusses bear on 47 x 150 C24 wall plates on the ICF core of the eaves walls (plate top +5,076).
6. Binders, bracing, clips and hangers are listed on ES26-020-OGW-RF-01.
7. Ogwen 5P4B (detached). Datum 0 = GF FFL. Architect: Beech Developments -BD0154-OGW rev A (JHG 28/10/26).

REVISIONS

REV | DATE | DESCRIPTION
P01 | 29.10.26 | Approval issue

CLIENT
Beech Developments (NW) Ltd

PROJECT
Maes Y Felin, Glan Conwy - Ogwen

DRAWING TITLE

## OGWEN - TRUSS PROFILES

Trussed rafter profiles (design assumption)

SCALE
AS SHOWN

SIZE
A3

DATE
29.10.26

DRAWN
TS
CHECKED | APPROVED

STATUS

### FOR APPROVAL

DRAWING No.

# ES26-020-OGW-RF-02

REV

P01
