BuildEase2026/mf-icf-approval-1f4119fc49/POW/docs/struct/ES26-020-POW-RF-02 Powys - Truss Profiles.pdf

Do not scale. All dimensions in mm. Check all dimensions on site.

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
ICF PACKAGE: Nudura ICF formwork and accessories are our supply. Raft and foundations AS PER THE ARCHITECTURAL DRAWINGS; joist ledgers by the engineer. Floors, stairs, partitions, roof and joinery are drawn as DESIGN ASSUMPTIONS for coordination - check by the relevant professional.

## FOR APPROVAL - NOT FOR CONSTRUCTION

### TRUSS TYPES

a | c

b

d

e | f

g

409 | 3229 | 1614 | 1614 | 3229 | 409

SPAN 9,687 (plate to plate, core outer faces)

OVERALL 10,504

183 3,391

RISE 3,574

35°

T1 FINK (W) TRUSS - 10 No. (1:50)

T1 FINK - 10 NO.

| Member | Section | Length
a | top chord | 35x120 TR26 | 6,412
b | bottom chord | 35x97 TR26 | 9,687
c | top chord | 35x120 TR26 | 6,412
d | web | 35x72 TR26 | 1,934
e | web | 35x72 TR26 | 3,812
f | web | 35x72 TR26 | 3,812
g | web | 35x72 TR26 | 1,934
Span 9,687, overall 10,504, pitch 35 deg, rise 3,574, heel 183 (plate top to top of top chord over the core outer face), overhang 409 past the core face. Plate +5,076, apex +8,650.

NOTES
1. DESIGN ASSUMPTION for coordination: the trussed rafter manufacturer designs the final trusses (members, joints, nail plates, bracing) to BS EN 1995-1-1 for the stated loads and confirms all sizes before manufacture.
2. Profiles drawn to scale from the approval model member geometry: TR26 strength class, 35 wide members, nail-plated joints. Member marks a, b, c ... refer to the member tables.
3. Design brief (ASSUMED, truss supplier / engineer to confirm): concrete interlocking tiles on battens and breathable membrane + solar PV (0.73 kN/m2 over the whole roof), plasterboard ceiling, loft not habitable; Glan Conwy LL28, altitude ~25 m, snow zone 2, vb 24 m/s, exposed (estuary).
4. Trusses bear on 47 x 150 C24 wall plates on the ICF core of the eaves walls (plate top +5,076).
5. Gable ladders, binders, bracing and clips are listed on ES26-020-POW-RF-01.
6. Powys (detached), plot 14, building B05. Datum 0 = GF FFL. Architect: Beech Developments - BD0154-POW rev A (JHG 26/10/26).

REVISIONS

REV | DATE | DESCRIPTION
P01 | 29.10.26 | Approval issue

CLIENT
Beech Developments (NW) Ltd

PROJECT
Maes Y Felin, Glan Conwy - Powys

DRAWING TITLE

## POWYS - TRUSS PROFILES

Trussed rafter profiles (design assumption)

SCALE
AS SHOWN

SIZE
A3

DATE
29.10.26

DRAWN
TS
CHECKED | APPROVED

STATUS

### FOR APPROVAL

DRAWING No.

# ES26-020-POW-RF-02

REV

P01
