BuildEase2026/mf-icf-approval-1f4119fc49/3B4P/docs/icf/ES26-020-3B4P-GA-01 3B4P - Raft Edge ICF.pdf

Do not scale. All dimensions in millimetres, levels in metres from GF FFL. Check all dimensions on site.

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
ICF PACKAGE: Nudura ICF formwork and accessories are our supply. Raft and foundations AS PER THE ARCHITECTURAL DRAWINGS; joist ledgers by the engineer. Floors, stairs, partitions, roof and joinery are drawn as DESIGN ASSUMPTIONS for coordination - check by the relevant professional.

### RAFT EDGE COURSE ICF SCHEDULES

OPENING SCHEDULE

Ref | Width | Height | Sill | Head | Lintel
none
Structural openings in the ICF; sill and head above GF FFL.

8652

12252

8652

12252

12252

12252

8652

8652

A
SE-01

A
SE-01

B
SE-02

B
SE-02

DIAG 15002
DIAG 15001

## RAFT EDGE COURSE ICF PLAN

Scale 1:75 @ A3 | Plan cut at -228

N

0 | 1 | 2 | 3 | 4m

EPS insulation (Nudura form) Concrete core
End cap at opening
Engineer's pier bars (n-H12 vertical bars in ICF pier) / WS wall starters Setting-out check diagonal (external ICF corners)
Section line (see SE sheet)

## FOR APPROVAL - NOT FOR CONSTRUCTION

NOTES
1. ICF: Nudura 6" XR35, 101.6 EPS + 152.4 core + 101.6 EPS = 355.6. Dimensions to the ICF faces.
2. Levels above GF FFL. Sill / head = structural opening in the ICF.
3. Nudura 6in XR35 external walls, 6in Standard party wall; no lintels or end caps - heads and jambs closed with 47 x 150 timber closers, the core spans the head (rebar by the engineer).
4. Lintel (L-n) and steel (B-n, C-1) marks from rev -, which takes precedence.
5. Masonry walls shown for context.
6. 3B4P (semi pair), plots 16-17, building B07. Datum 0 = GF FFL. Architect: Beech Developments - BD0154-3B4P rev A (JHG 26/10/26).

REVISIONS

REV | DATE | DESCRIPTION
P01 | 03.11.26 | Approval issue

CLIENT
Beech Developments (NW) Ltd

PROJECT
Maes Y Felin, Glan Conwy - 3B4P

DRAWING TITLE

## 3B4P - RAFT EDGE ICF

ICF walls, openings, lintels, steel over and engineer's notes

SCALE
1:75

SIZE
A3

DATE
03.11.26

DRAWN
TS
CHECKED | APPROVED

STATUS

### FOR APPROVAL

DRAWING No.

# ES26-020-3B4P-GA-01

REV

P01
