BuildEase2026/mf-icf-approval-1f4119fc49/3B4P/thumbs/ES26-020-3B4P-DT-03.png

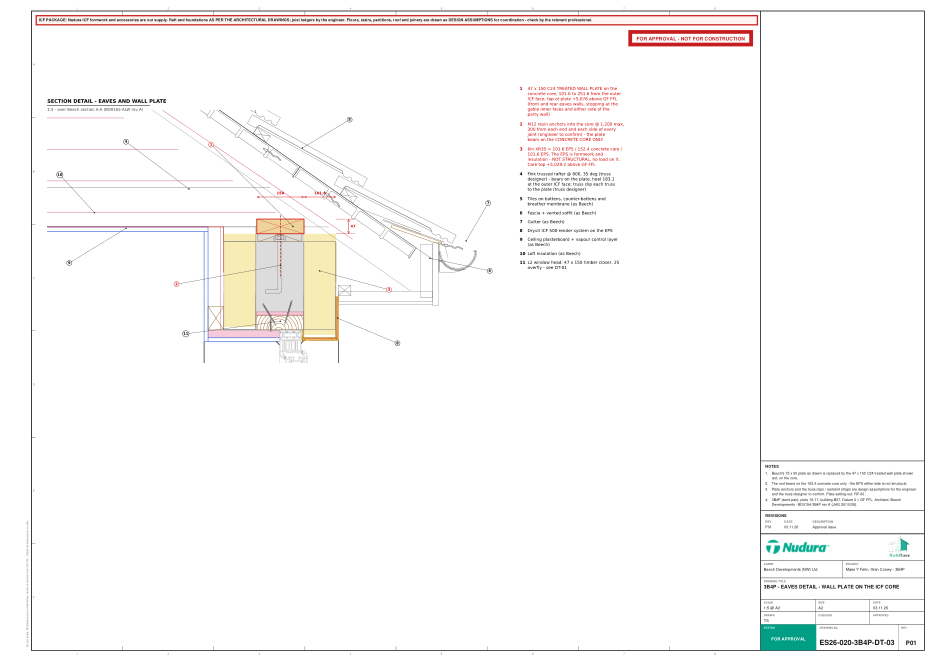
3B4P/thumbs/ES26-020-3B4P-DT-03.png
