BuildEase2026/mf-icf-approval-1f4119fc49/ALW/thumbs/ES26-020-ALW-EL-02.png

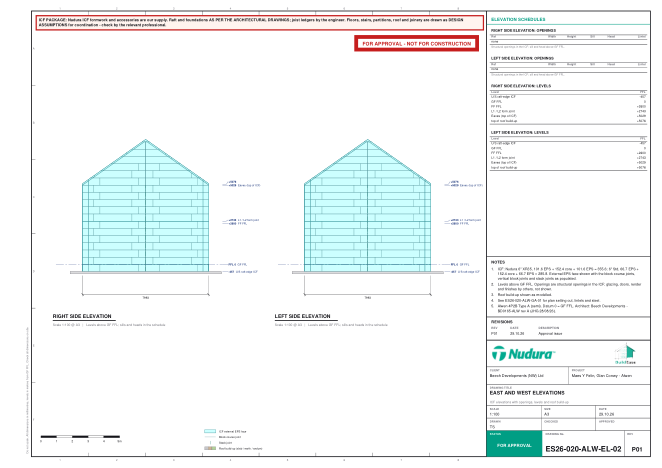
ALW/thumbs/ES26-020-ALW-EL-02.png
