BuildEase2026/mf-icf-approval-1f4119fc49/ALW/thumbs/ES26-020-ALW-FL-01.png

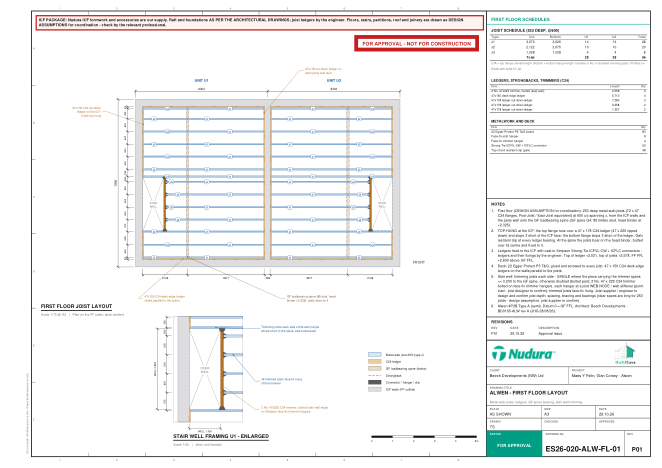
ALW/thumbs/ES26-020-ALW-FL-01.png
