BuildEase2026/mf-icf-approval-1f4119fc49/OGW/thumbs/ES26-020-OGW-RF-00.png

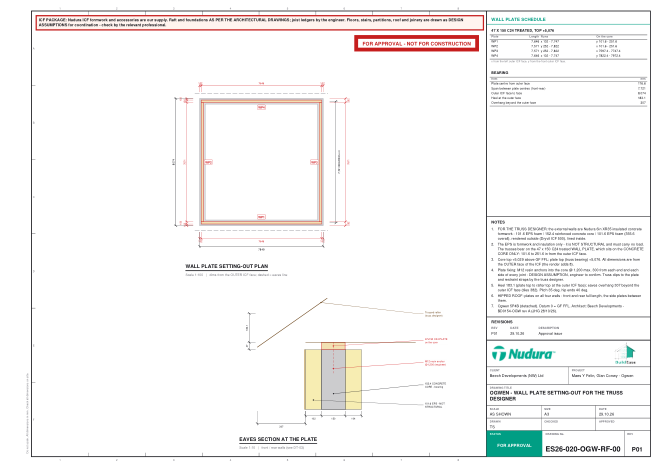
OGW/thumbs/ES26-020-OGW-RF-00.png
