BuildEase2026/mf-icf-approval-1f4119fc49/POW/thumbs/ES26-020-POW-SE-02.png

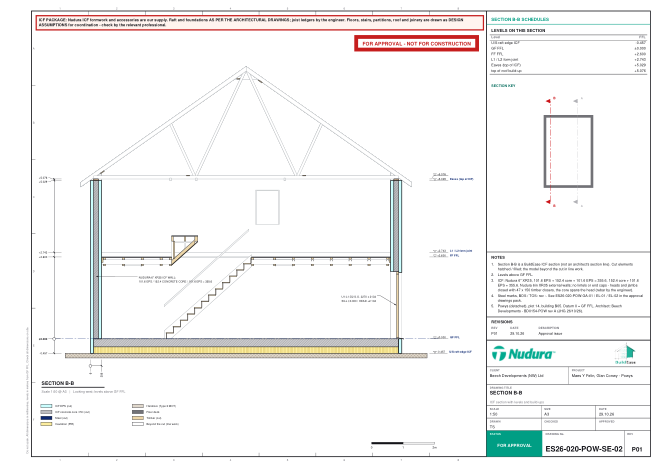
POW/thumbs/ES26-020-POW-SE-02.png
