BuildEase2026/mf-icf-approval-1f4119fc49/(list of files, cad)

Other CAD files:
3B4P/downloads/ES26-020-3B4P 3B4P - SketchUp model P01.skp
ALW/downloads/ES26-020-ALW Alwen - SketchUp model P01.skp
OGW/downloads/ES26-020-OGW Ogwen - SketchUp model P01.skp
POW/downloads/ES26-020-POW Powys - SketchUp model P01.skp
