BuildEase2026/mf-icf-approval-1f4119fc49/sequence/docs/ES26-020-ALW B01 - Pallet stack sheets.pdf

# Stack B01 CNR-1 - 6in XR35 corners

4 blanks, 4 pieces | 1 layers | FB course 1 | stack height 607 mm of 1300 mm cap FB⁻CR⁰¹⁻C¹ | FB⁻CR⁰²⁻C¹

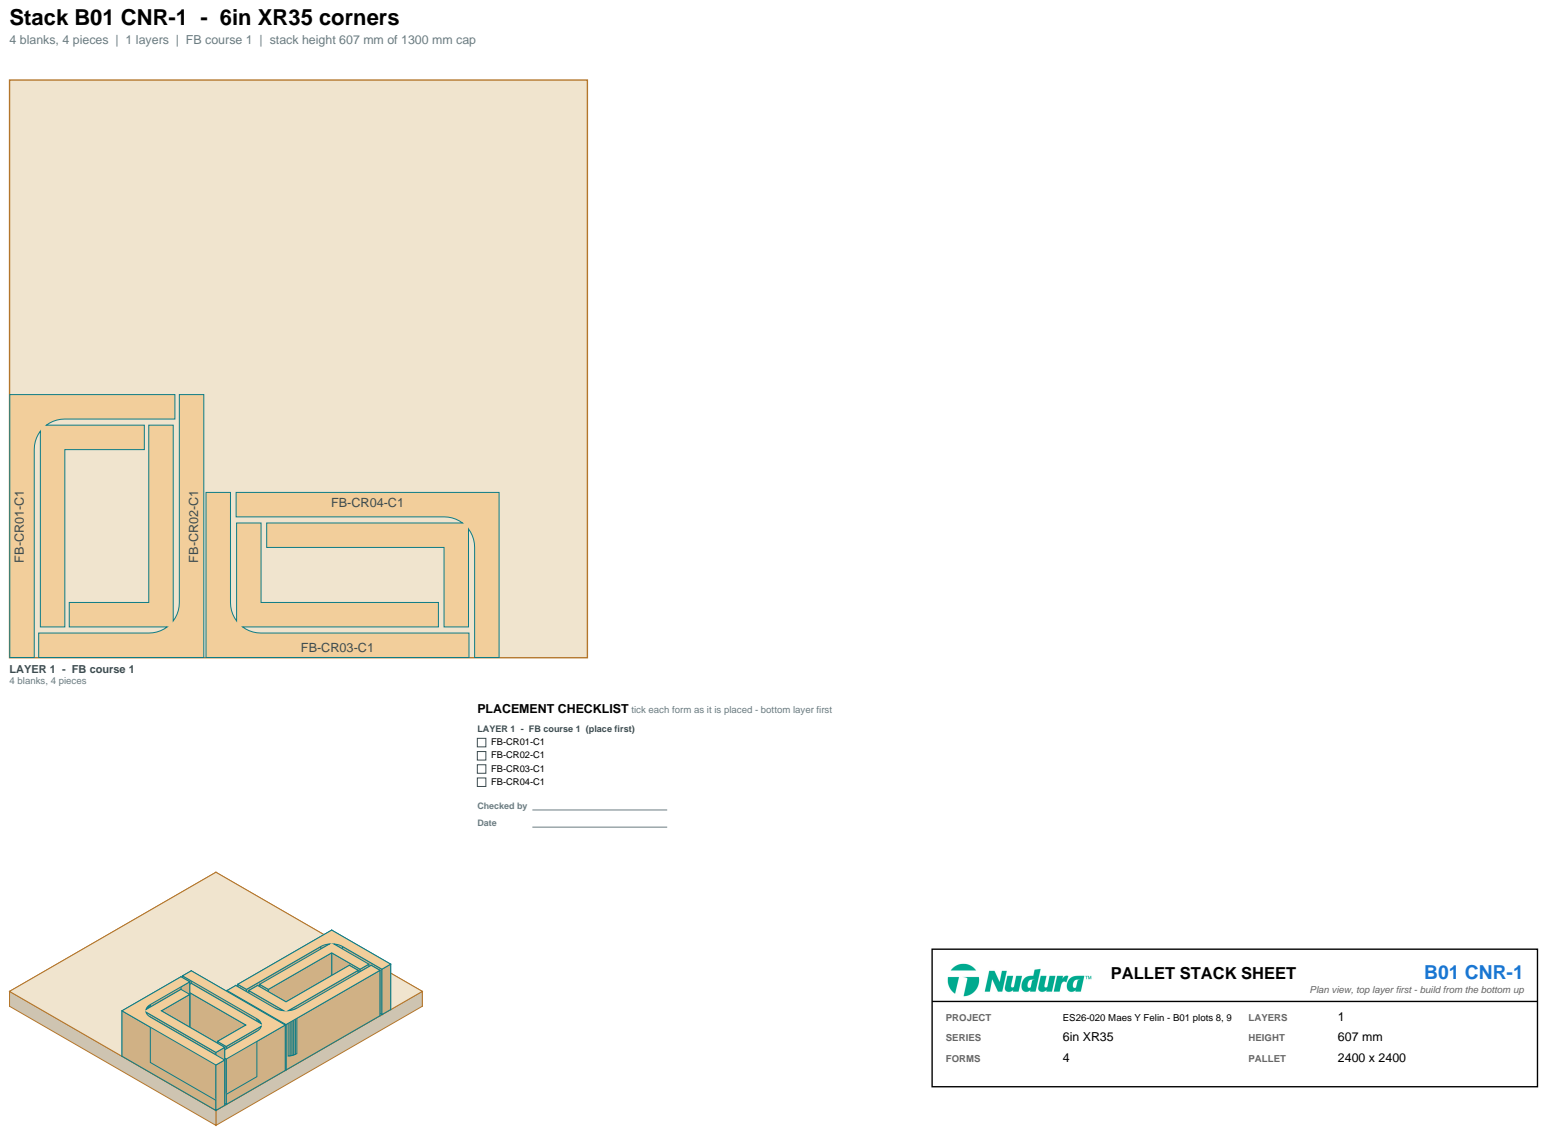
[picture p43: page 1]
Checked by; Date; PALLET STACK SHEET; B01 CNR-1; PROJECT; ES26-020 Maes Y Felin - B01 plots 8, 9; SERIES; FORMS; LAYERS; HEIGHT; PALLET

LAYER 1 - FB course 1
4 blanks, 4 pieces

PLACEMENT CHECKLIST tick each form as it is placed - bottom layer first

LAYER 1 - FB course 1 (place first)

Plan view, top layer first - build from the bottom up

# Stack B01 CUT-1 - 6in XR35 straights

## 15 blanks, 18 pieces | 3 layers | FB course 1 | stack height 836 mm of 1300 mm cap

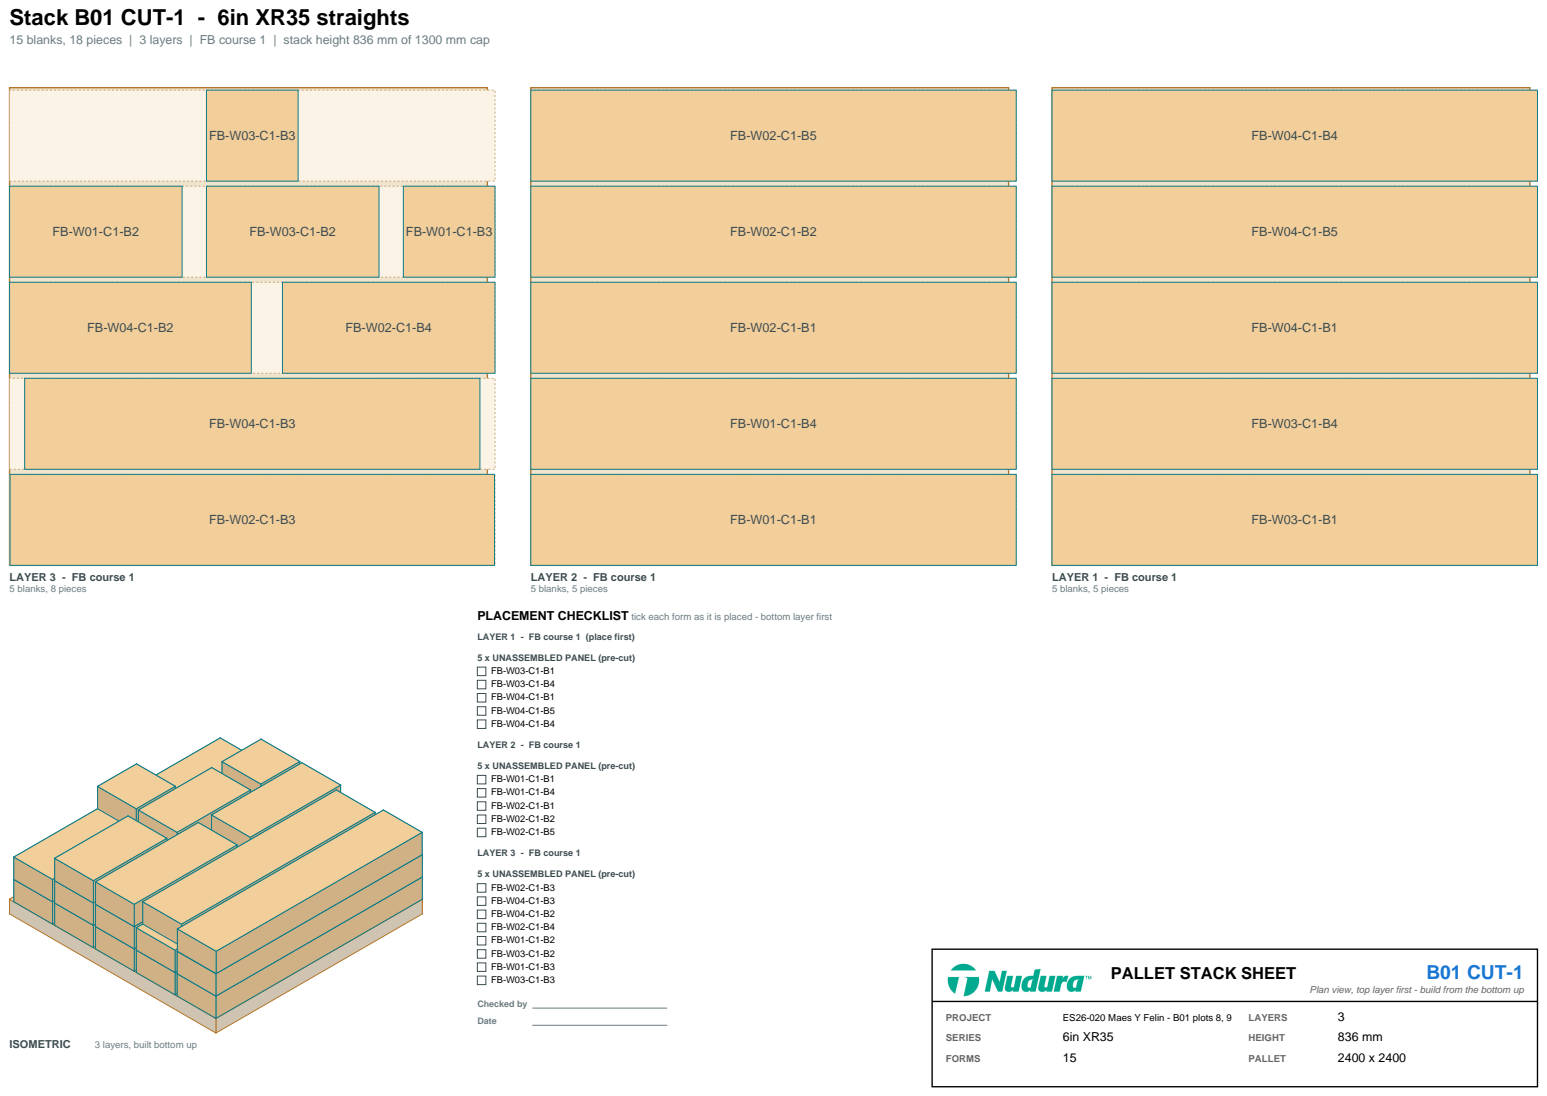
[picture p44: page 2]
ISOMETRIC; 3 layers, built bottom up; 5 x UNASSEMBLED PANEL (pre-cut) FB-W02-C1-B3 FB-W04-C1-B3 FB-W04-C1-B2 FB-W02-C1-B4 FB-W01-C1-B2 FB-W03-C1-B2 FB-W01-C1-B3 FB-W03-C1-B3; Checked by; Date; PALLET STACK SHEET; B01 CUT-1; PROJECT; ES26-020 Maes Y Felin - B01 plots 8, 9; FORMS; LAYERS; HEIGHT

LAYER 3 - FB course 1
5 blanks, 8 pieces

LAYER 2 - FB course 1
5 blanks, 5 pieces

LAYER 1 - FB course 1

PLACEMENT CHECKLIST tick each form as it is placed - bottom layer first

LAYER 1 - FB course 1 (place first)

5 x UNASSEMBLED PANEL (pre-cut)

Plan view, top layer first - build from the bottom up

# Stack B01 FULL-1 - 6in XR35 straights

## 25 blanks, 25 pieces | 5 layers | L1 courses 1-5 | stack height 1293 mm of 1300 mm cap

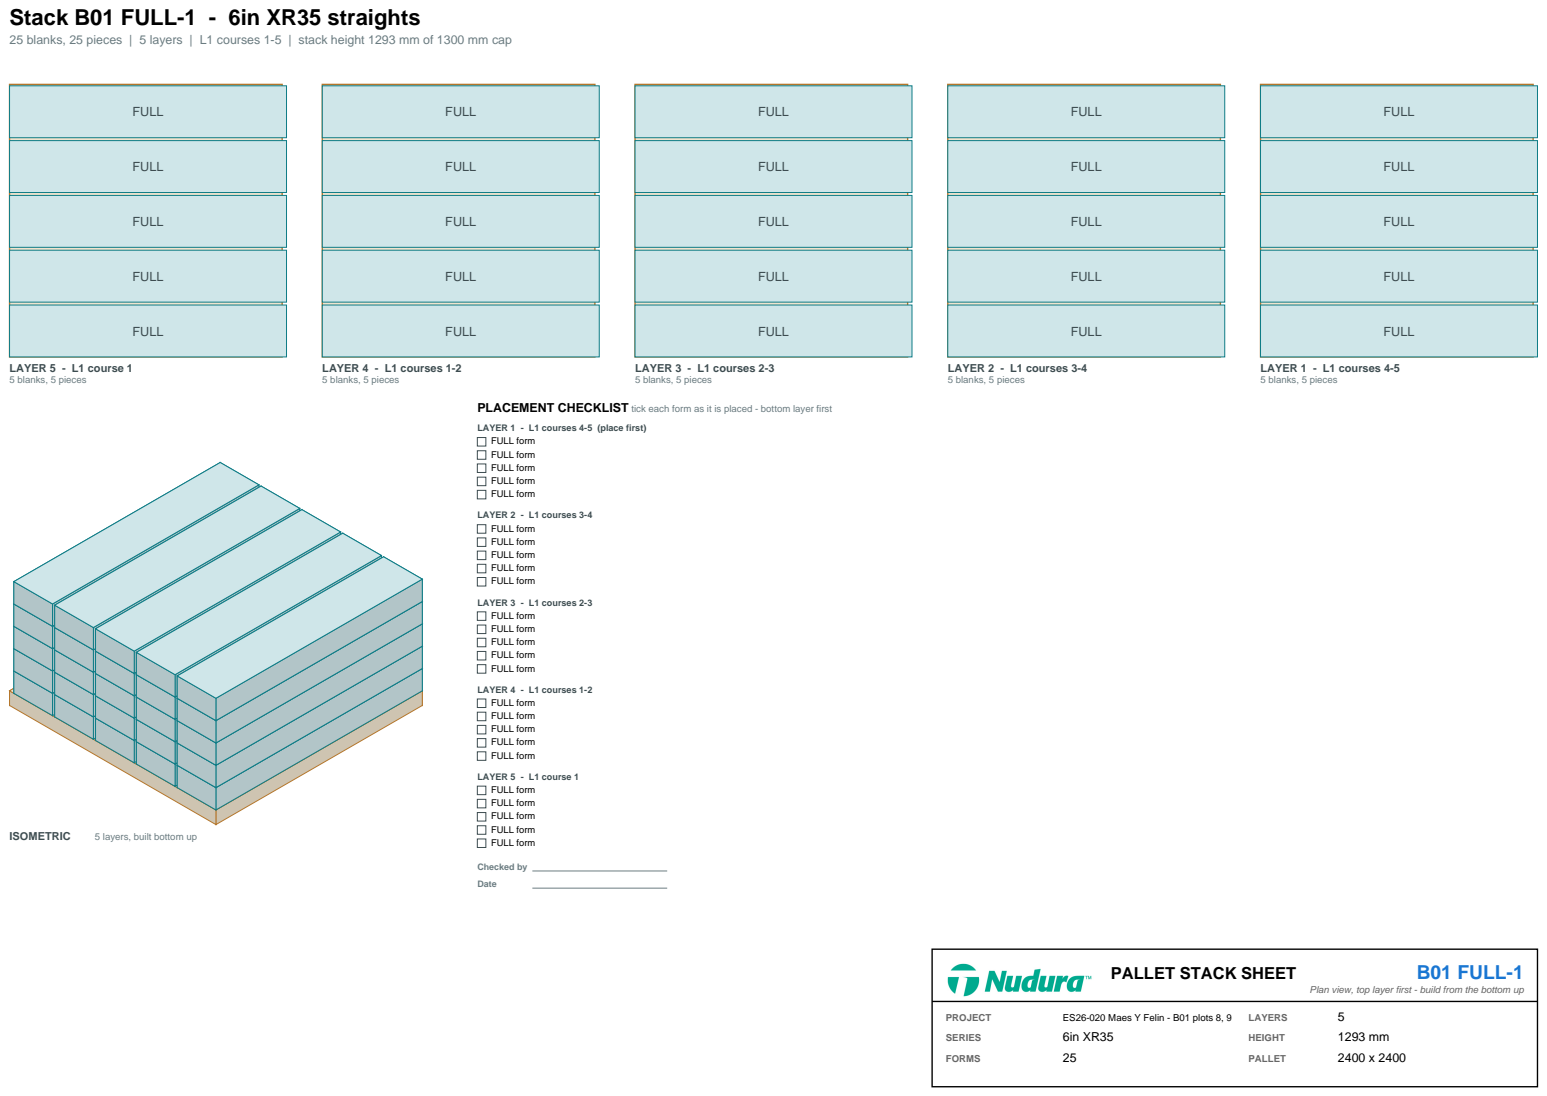
[picture p45: page 3]
FULL; LAYER 5 - L1 course 1 5 blanks, 5 pieces; LAYER 4 - L1 courses 1-2 5 blanks, 5 pieces; LAYER 3 - L1 courses 2-3 5 blanks, 5 pieces; LAYER 2 - L1 courses 3-4 5 blanks, 5 pieces; LAYER 1 - L1 courses 4-5 5 blanks, 5 pieces; ISOMETRIC; 5 layers, built bottom up; LAYER 2 - L1 courses 3-4 FULL form FULL form FULL form FULL form FULL form; LAYER 3 - L1 courses 2-3 FULL form FULL form FULL form FULL form FULL form; LAYER 4 - L1 courses 1-2 FULL form FULL form FULL form FULL form FULL form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

PLACEMENT CHECKLIST tick each form as it is placed - bottom layer first

LAYER 1 - L1 courses 4-5 (place first)
FULL form

Plan view, top layer first - build from the bottom up

# Stack B01 CNR-2 - 6in XR35 corners

24 blanks, 24 pieces | 2 layers | L1 courses 1-6 | stack height 1064 mm of 1300 mm cap FULL | FULL

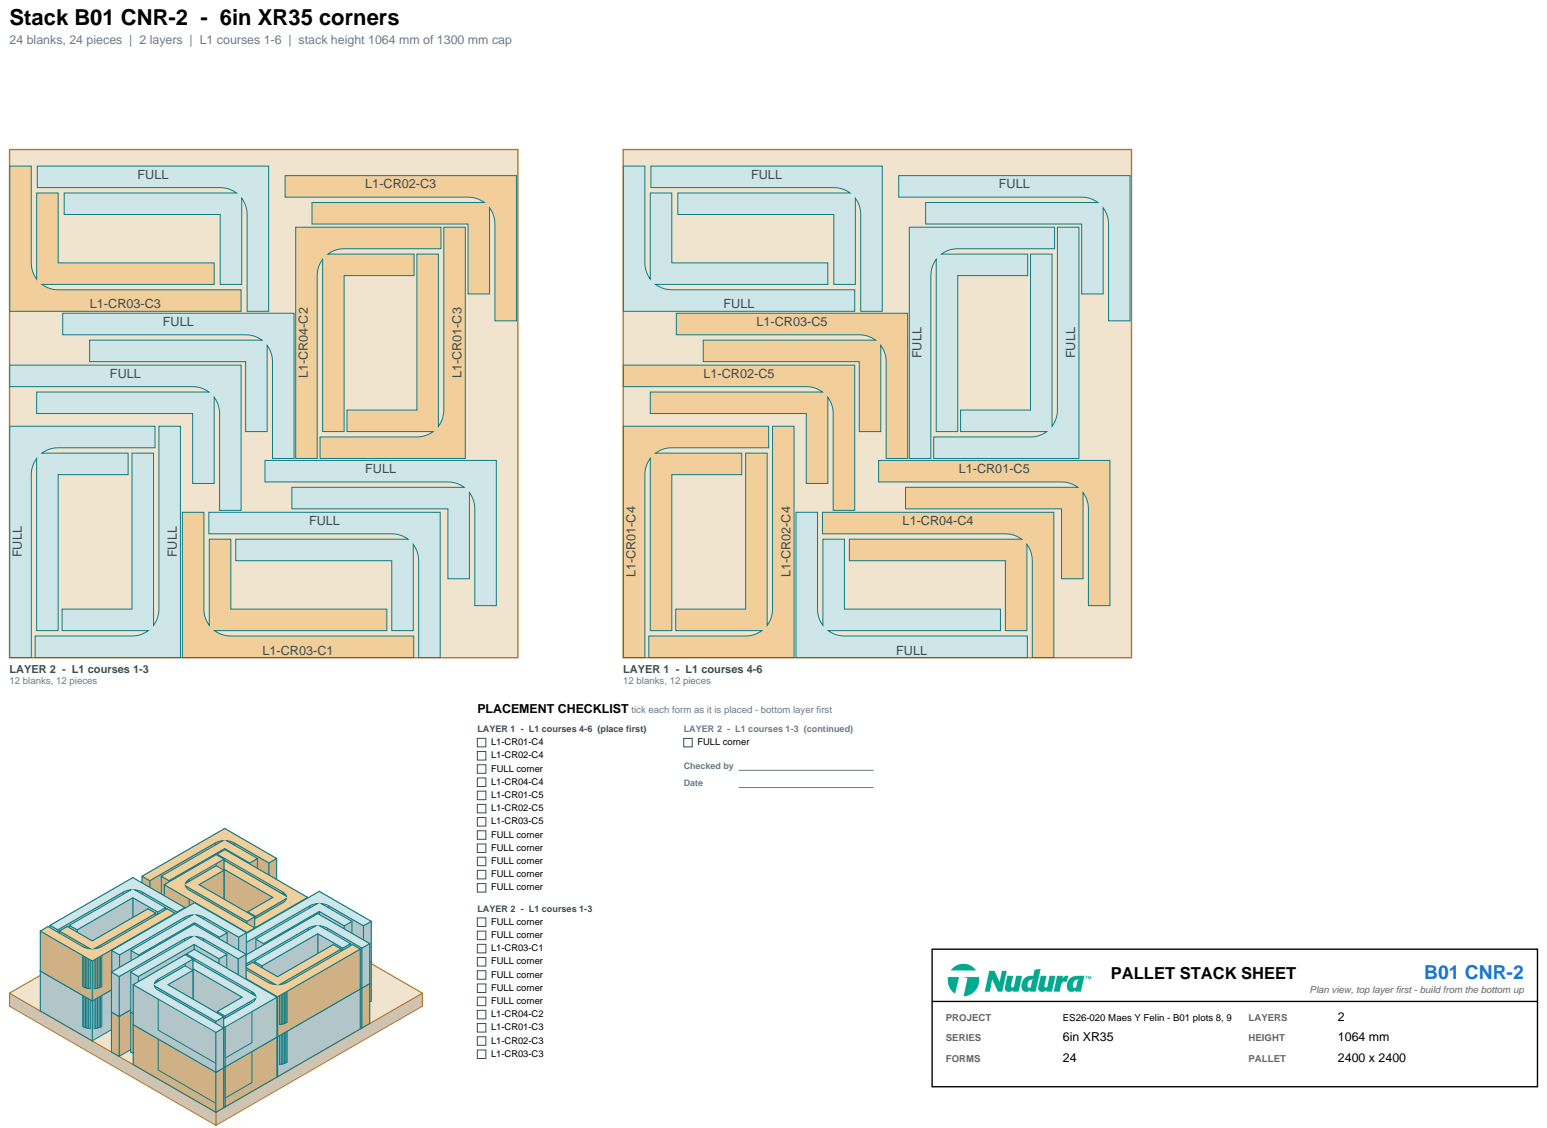
[picture p46: page 4]
FULL; LAYER 2 - L1 courses 1-3 12 blanks, 12 pieces; LAYER 1 - L1 courses 4-6 12 blanks, 12 pieces; LAYER 1 - L1 courses 4-6 (place first) L1-CR01-C4 L1-CR02-C4 FULL corner L1-CR04-C4 L1-CR01-C5 L1-CR02-C5 L1-CR03-C5 FULL corner FULL corner FULL corner FULL corner FULL corner; LAYER 2 - L1 courses 1-3 FULL corner FULL corner L1-CR03-C1 FULL corner FULL corner FULL corner FULL corner L1-CR04-C2 L1-CR01-C3 L1-CR02-C3 L1-CR03-C3; Checked by; Date; PALLET STACK SHEET; B01 CNR-2; PROJECT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

PLACEMENT CHECKLIST tick each form as it is placed - bottom layer first

LAYER 2 - L1 courses 1-3 (continued)
FULL corner

Plan view, top layer first - build from the bottom up

# Stack B01 CUT-2 - 6in Std straights

## 18 blanks, 21 pieces | 6 layers | L1 courses 1-6 | stack height 1101 mm of 1300 mm cap

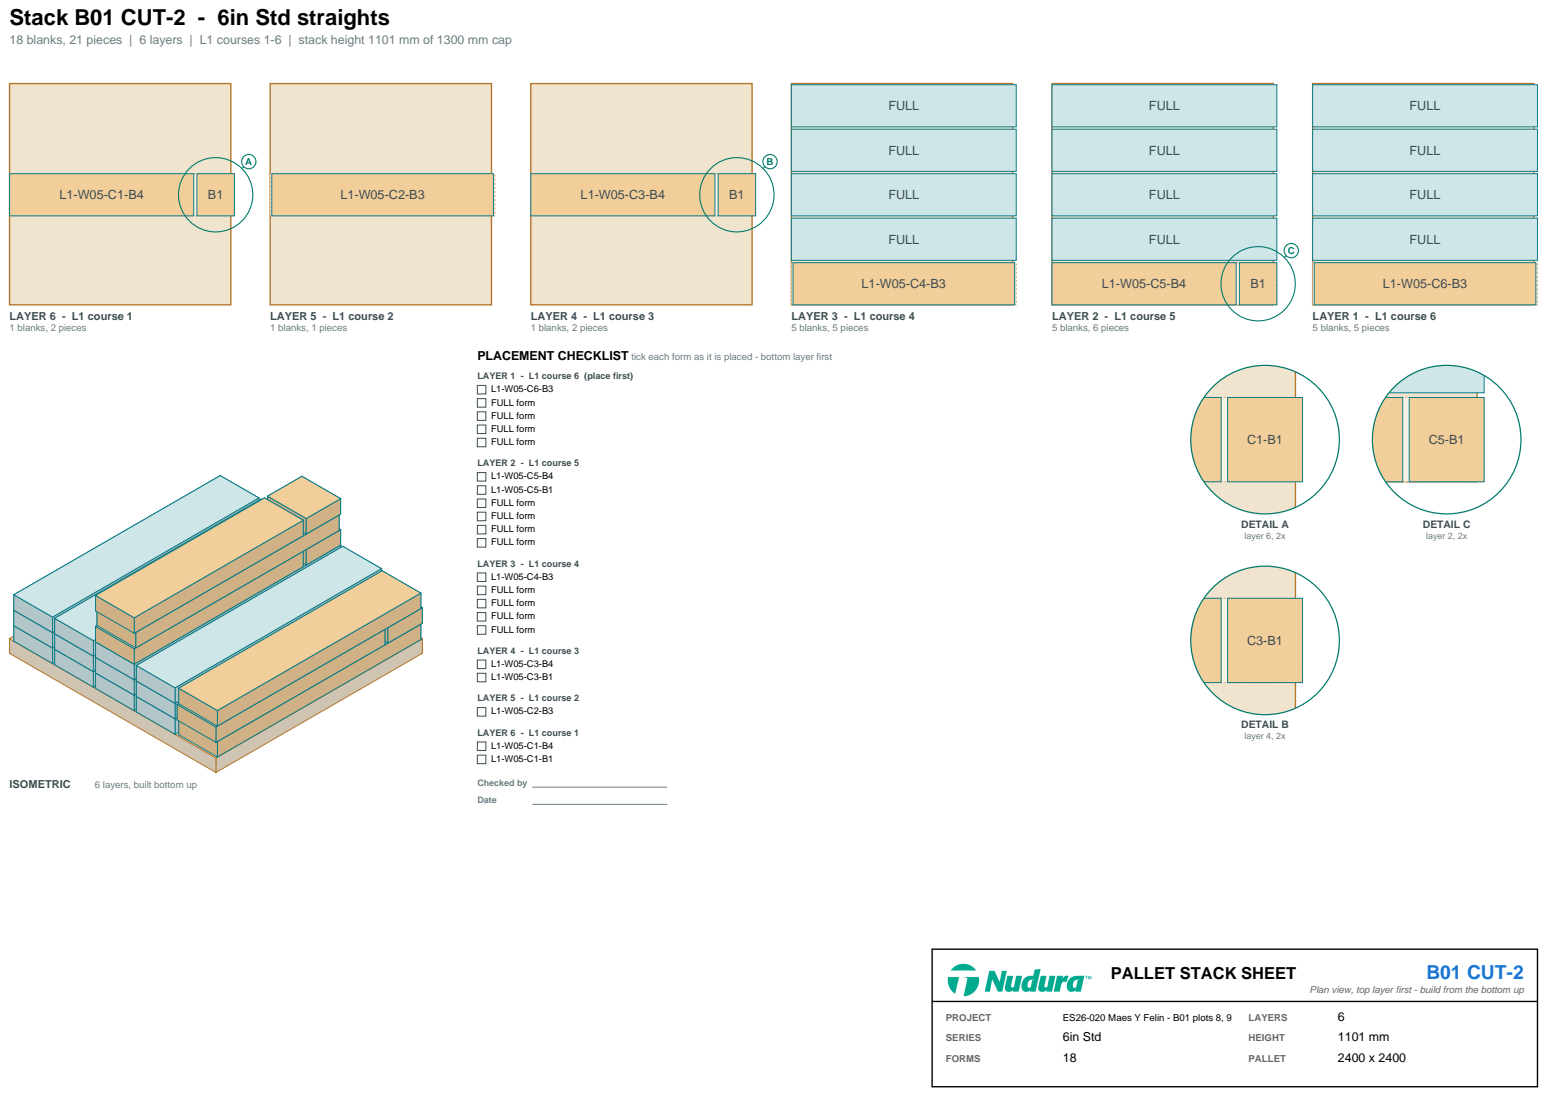
[picture p47: page 5]
LAYER 6 - L1 course 1 1 blanks, 2 pieces; LAYER 5 - L1 course 2 1 blanks, 1 pieces; LAYER 4 - L1 course 3 1 blanks, 2 pieces; FULL; LAYER 3 -; L1 course 4; 5 blanks, 5 pieces; LAYER 2 - L1 course 5 5 blanks, 6 pieces; LAYER 1 - L1 course 6 5 blanks, 5 pieces; ISOMETRIC; 6 layers, built bottom up; DETAIL A layer 6, 2x; DETAIL B layer 4, 2x; DETAIL C layer 2, 2x; LAYER 2 - L1 course 5 L1-W05-C5-B4 L1-W05-C5-B1 FULL form FULL form FULL form FULL form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

PLACEMENT CHECKLIST tick each form as it is placed - bottom layer first

LAYER 1 - L1 course 6 (place first)
FULL form

Plan view, top layer first - build from the bottom up

# Stack B01 CUT-3 - 6in XR35 straights

## 25 blanks, 48 pieces | 5 layers | L1 courses 1-6 | stack height 1293 mm of 1300 mm cap

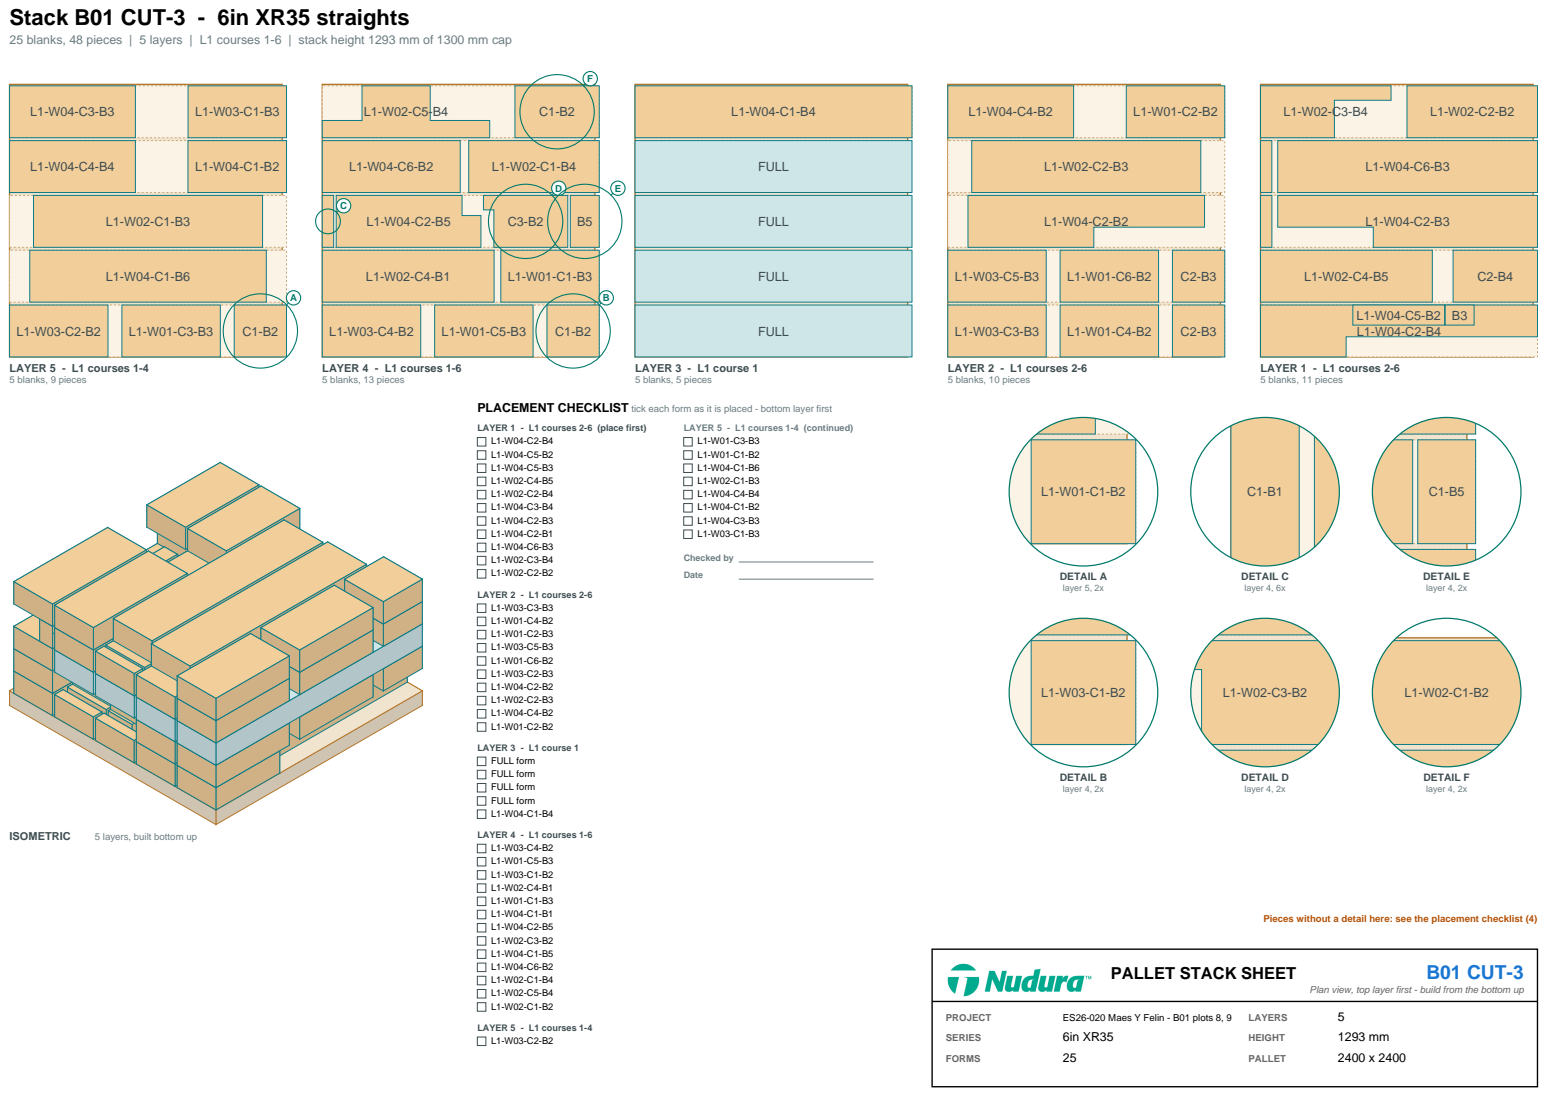
[picture p48: page 6]
LAYER 5 - L1 courses 1-4 5 blanks, 9 pieces; LAYER 4 - L1 courses 1-6 5 blanks, 13 pieces; FULL; LAYER 3 - L1 course 1 5 blanks, 5 pieces; LAYER 2 - L1 courses 2-6 5 blanks, 10 pieces; LAYER 1; - L1 courses 2-6; 5 blanks, 11 pieces; ISOMETRIC; 5 layers, built bottom up; DETAIL A layer 5, 2x; DETAIL B layer 4, 2x; DETAIL C layer 4, 6x; DETAIL D layer 4, 2x; DETAIL E layer 4, 2x; DETAIL F layer 4, 2x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

PLACEMENT CHECKLIST tick each form as it is placed - bottom layer first

Pieces without a detail here: see the placement checklist (4)

Plan view, top layer first - build from the bottom up

# Stack B01 CUT-4 - 6in XR35 straights

## 25 blanks, 35 pieces | 5 layers | L1 courses 3-6 | stack height 1293 mm of 1300 mm cap

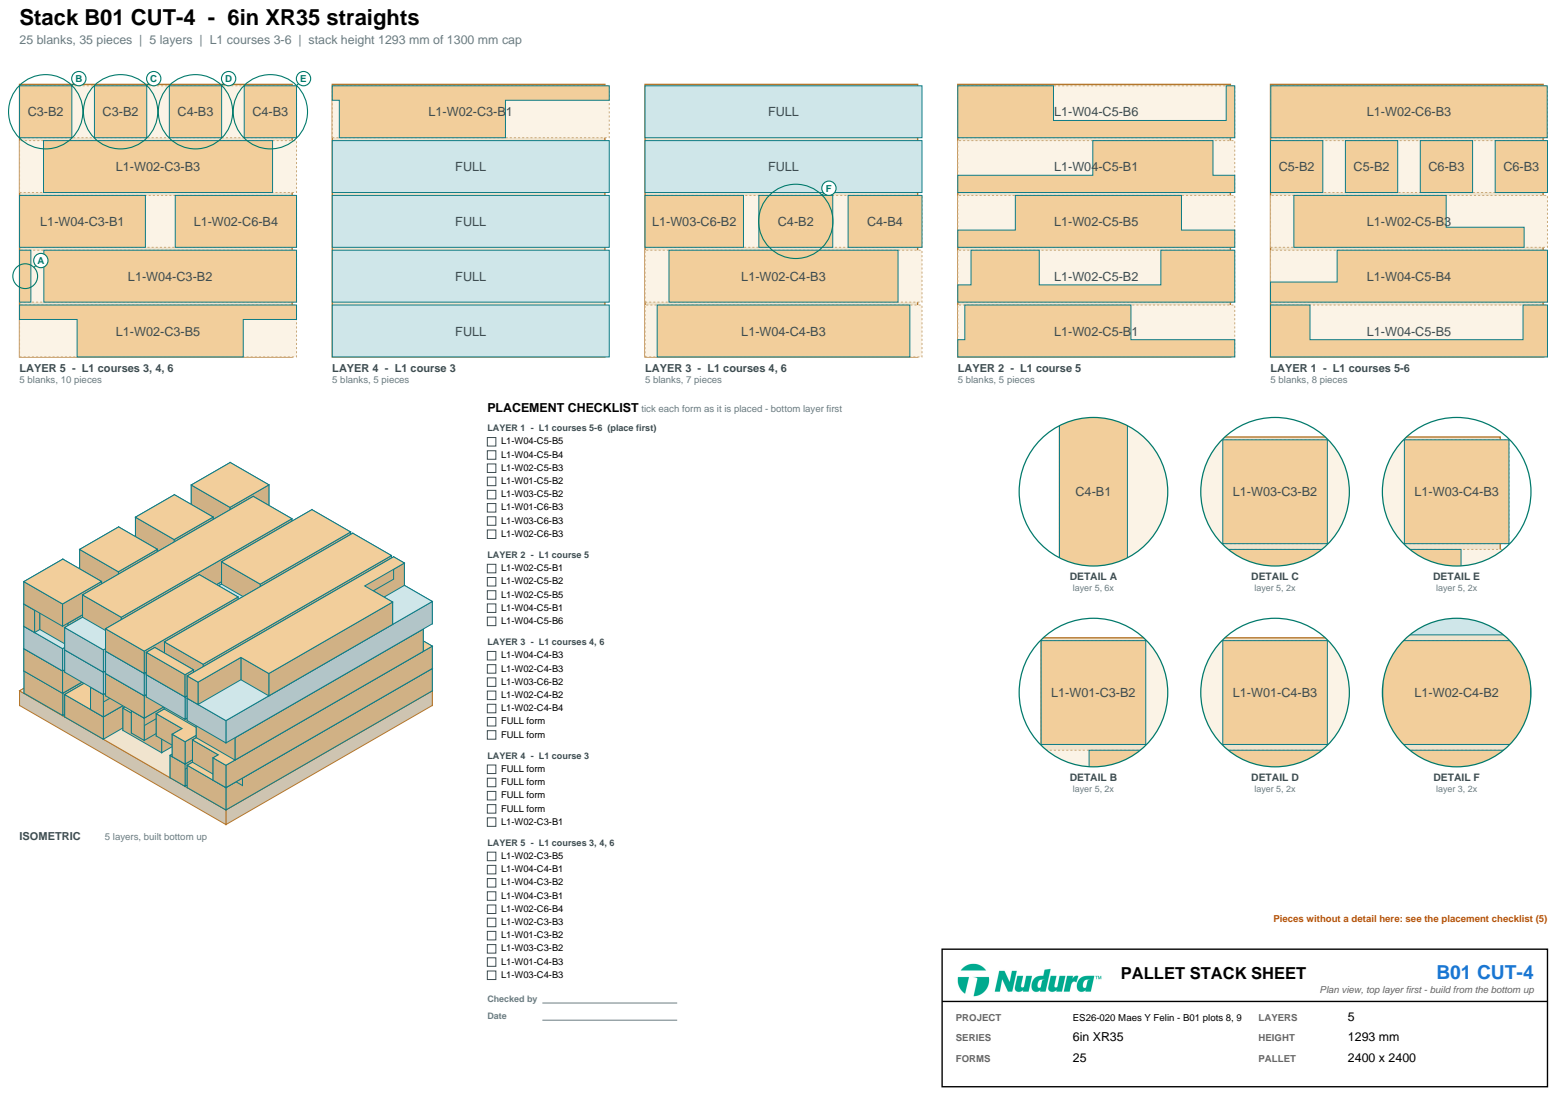
[picture p49: page 7]
LAYER 5 - L1 courses 3, 4, 6 5 blanks, 10 pieces; FULL; LAYER 4 - L1 course 3 5 blanks, 5 pieces; LAYER 3 - L1 courses 4, 6 5 blanks, 7 pieces; LAYER 2 - L1 course 5 5 blanks, 5 pieces; LAYER 1 - L1 courses 5-6 5 blanks, 8 pieces; ISOMETRIC; 5 layers, built bottom up; DETAIL A layer 5, 6x; DETAIL B layer 5, 2x; DETAIL C layer 5, 2x; DETAIL D layer 5, 2x; DETAIL E layer 5, 2x; DETAIL F layer 3, 2x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

PLACEMENT CHECKLIST tick each form as it is placed - bottom layer first

Pieces without a detail here: see the placement checklist (5)

Plan view, top layer first - build from the bottom up

# Stack B01 CNR-3 - 6in XR35 corners

20 blanks, 20 pieces | 2 layers | L2 courses 1-5 | stack height 1064 mm of 1300 mm cap FULL | FULL

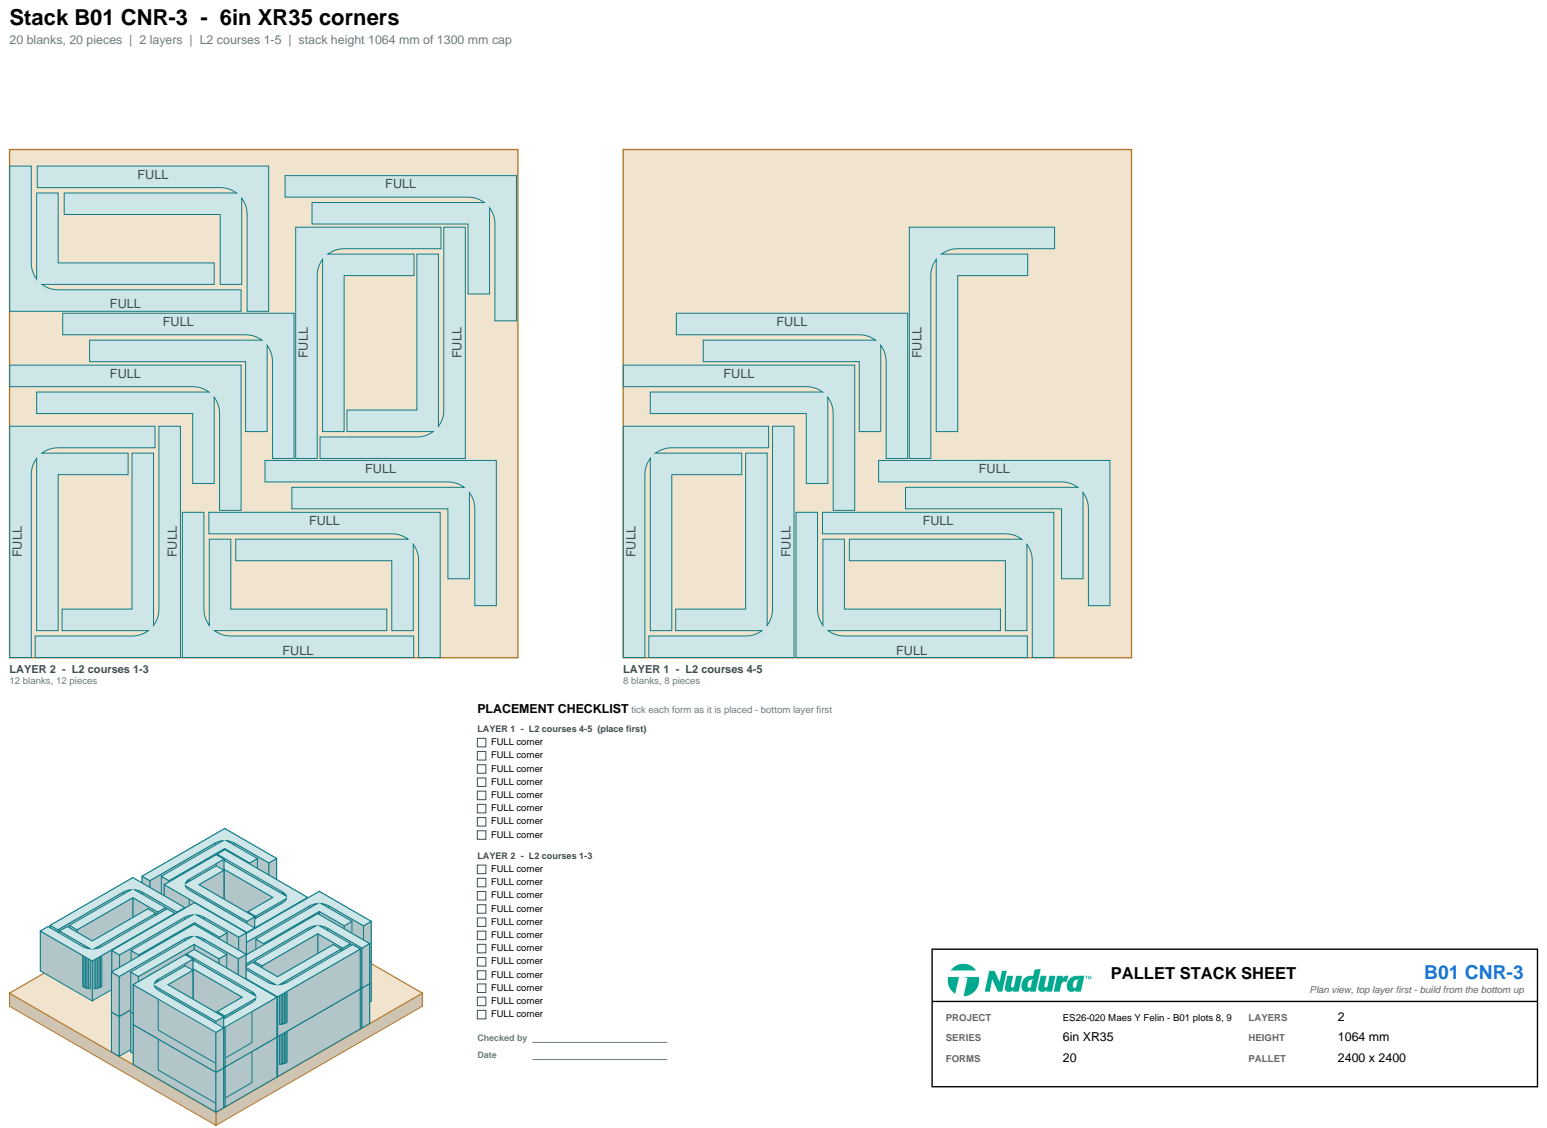
[picture p50: page 8]
FULL; LAYER 2 - L2 courses 1-3 12 blanks, 12 pieces; LAYER 1 - L2 courses 4-5 8 blanks, 8 pieces; LAYER 2 - L2 courses 1-3 FULL corner FULL corner FULL corner FULL corner FULL corner FULL corner FULL corner FULL corner FULL corner FULL corner FULL corner FULL corner; Checked by; Date; PALLET STACK SHEET; B01 CNR-3; PROJECT; ES26-020 Maes Y Felin - B01 plots 8, 9; FORMS; LAYERS; HEIGHT

PLACEMENT CHECKLIST tick each form as it is placed - bottom layer first

LAYER 1 - L2 courses 4-5 (place first)
FULL corner

Plan view, top layer first - build from the bottom up

# Stack B01 FULL-2 - 6in XR35 straights

## 25 blanks, 25 pieces | 5 layers | L2 courses 1-5 | stack height 1293 mm of 1300 mm cap

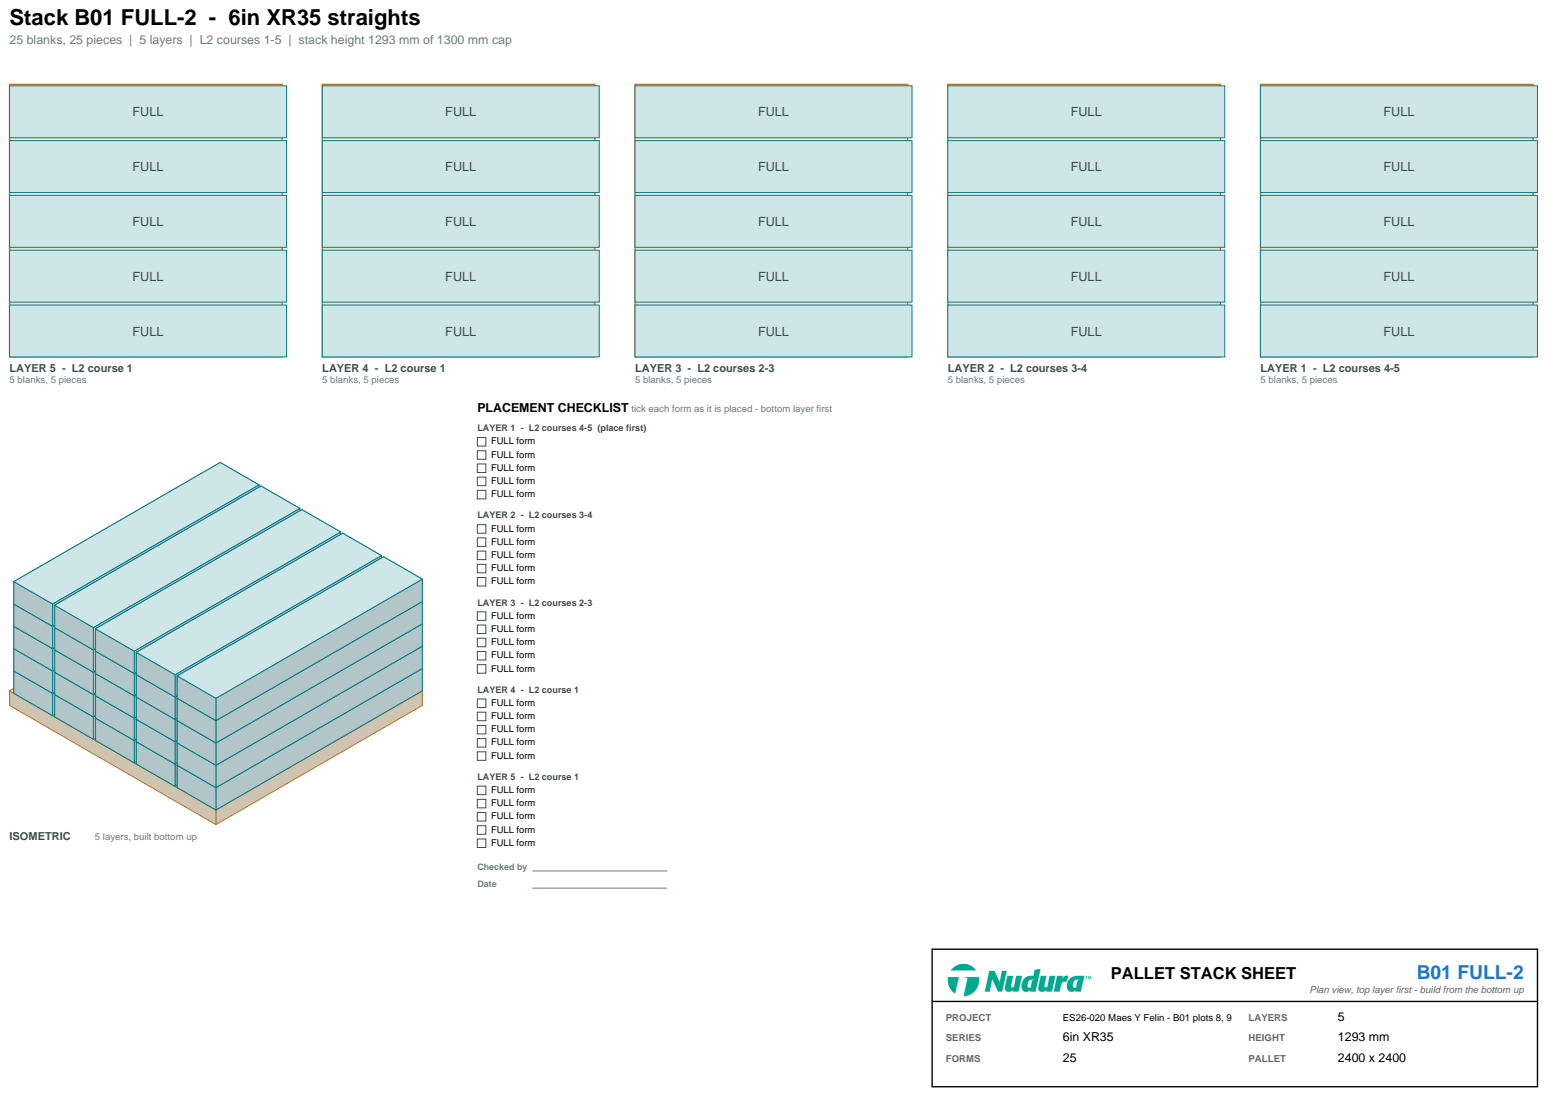
[picture p51: page 9]
FULL; LAYER 5 - L2 course 1 5 blanks, 5 pieces; LAYER 4 - L2 course 1 5 blanks, 5 pieces; LAYER 3 - L2 courses 2-3 5 blanks, 5 pieces; LAYER 2 - L2 courses 3-4 5 blanks, 5 pieces; LAYER 1 - L2 courses 4-5 5 blanks, 5 pieces; ISOMETRIC; 5 layers, built bottom up; LAYER 2 - L2 courses 3-4 FULL form FULL form FULL form FULL form FULL form; LAYER 3 - L2 courses 2-3 FULL form FULL form FULL form FULL form FULL form; LAYER 4 - L2 course 1 FULL form FULL form FULL form FULL form FULL form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

PLACEMENT CHECKLIST tick each form as it is placed - bottom layer first

LAYER 1 - L2 courses 4-5 (place first)
FULL form

Plan view, top layer first - build from the bottom up

# Stack B01 CUT-6 - 6in XR35 straights

25 blanks, 44 pieces | 5 layers | L2 courses 1, 2, 3, 4, 5, 6, 7, 10, 11 | stack height 1293 mm of 1300 mm cap

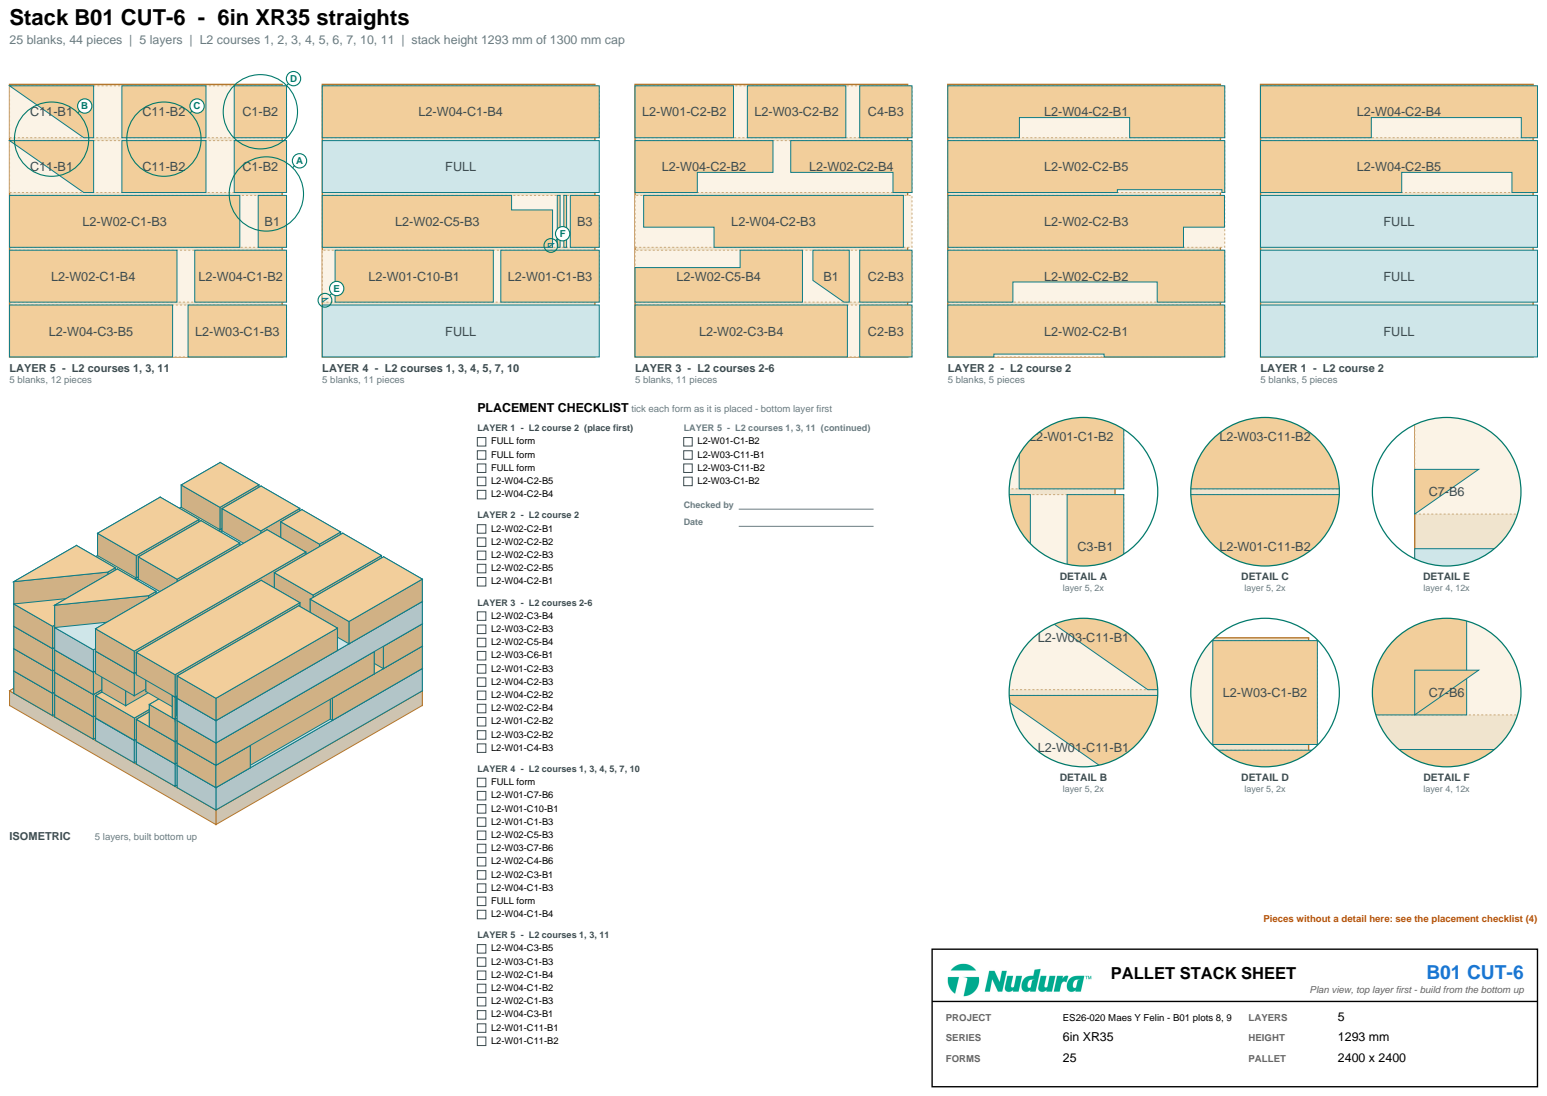
[picture p52: page 10]
LAYER 5 - L2 courses 1, 3, 11 5 blanks, 12 pieces; FULL; LAYER 4 - L2 courses 1, 3, 4, 5, 7, 10 5 blanks, 11 pieces; LAYER 3 - L2 courses 2-6 5 blanks, 11 pieces; LAYER 2 - L2 course 2 5 blanks, 5 pieces; LAYER 1 - L2 course 2 5 blanks, 5 pieces; ISOMETRIC; 5 layers, built bottom up; DETAIL A layer 5, 2x; DETAIL B layer 5, 2x; DETAIL C layer 5, 2x; DETAIL D layer 5, 2x; DETAIL E layer 4, 12x; DETAIL F layer 4, 12x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

PLACEMENT CHECKLIST tick each form as it is placed - bottom layer first

LAYER 1 - L2 course 2 (place first)
FULL form

Pieces without a detail here: see the placement checklist (4)

Plan view, top layer first - build from the bottom up

# Stack B01 CUT-5 - 6in Std straights

## 28 blanks, 38 pieces | 7 layers | L2 courses 1-12 | stack height 1259 mm of 1300 mm cap

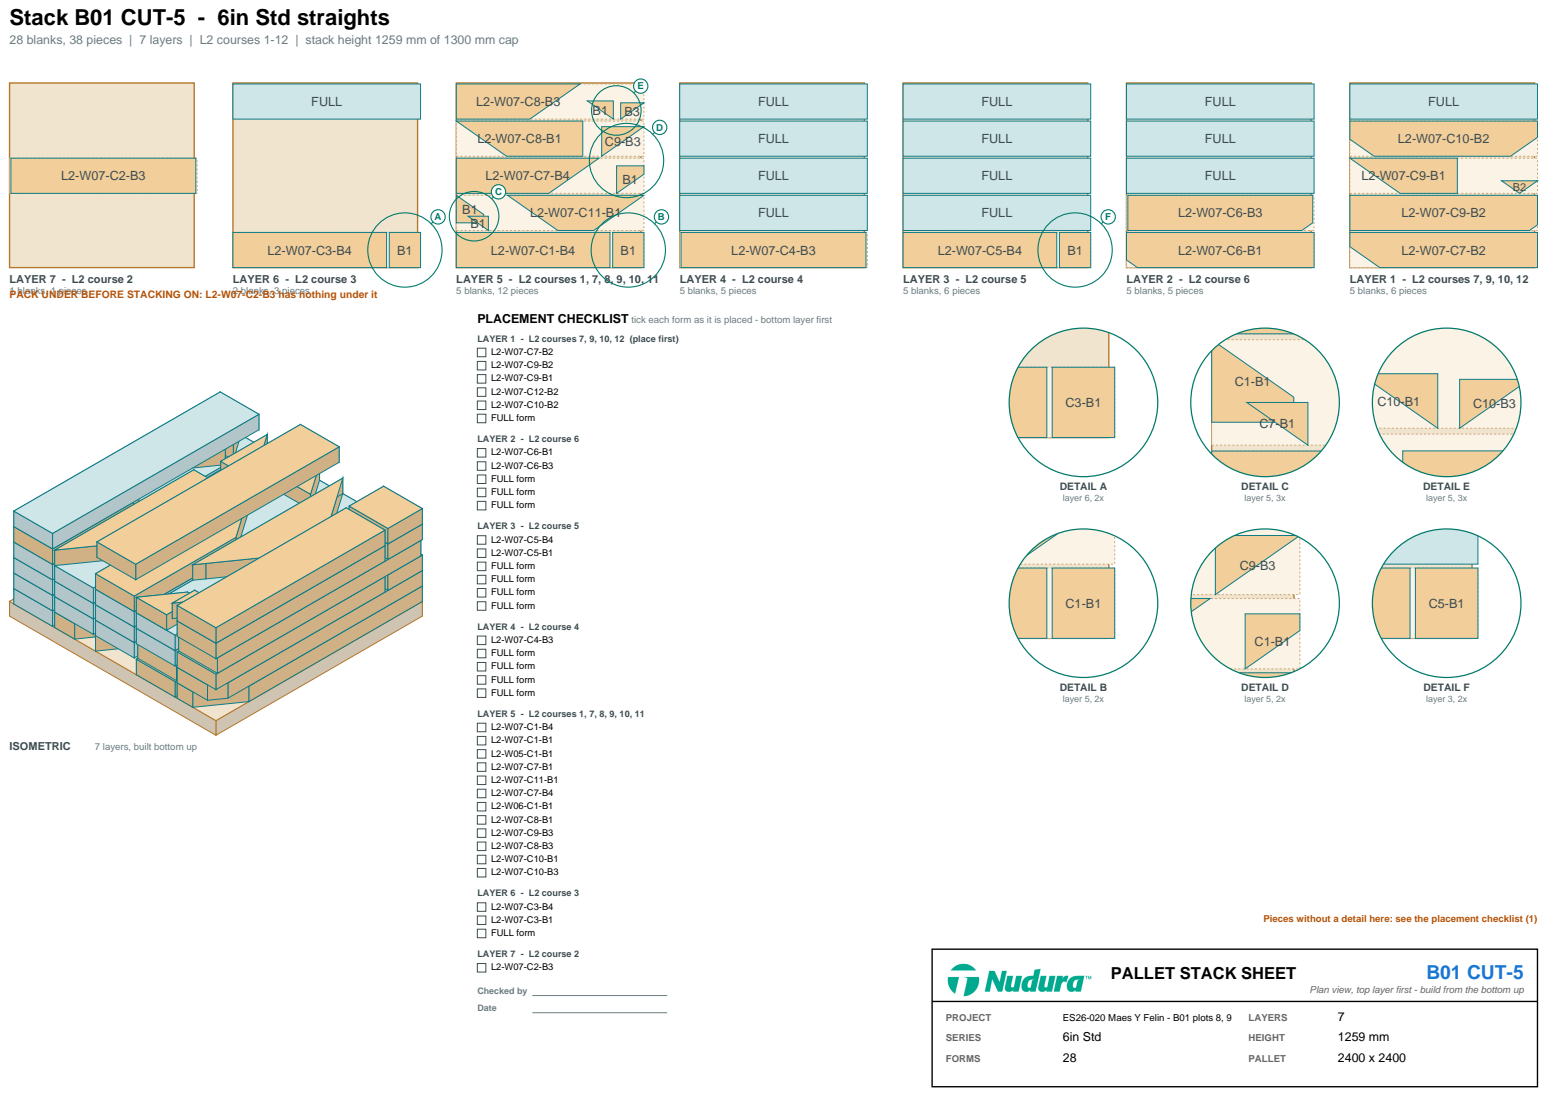
[picture p53: page 11]
FULL; LAYER 6 - L2 course 3 2 blanks, 3 pieces; LAYER 5 - L2 courses 1, 7, 8, 9, 10, 11 5 blanks, 12 pieces; LAYER 4 -; L2 course 4; 5 blanks, 5 pieces; ISOMETRIC; 7 layers, built bottom up; DETAIL B layer 5, 2x; DETAIL D layer 5, 2x; layer 5, 3x; DETAIL F layer 3, 2x; LAYER 1 - L2 courses 7, 9, 10, 12 (place first) L2-W07-C7-B2 L2-W07-C9-B2 L2-W07-C9-B1 L2-W07-C12-B2 L2-W07-C10-B2 FULL form; LAYER 2 - L2 course 6 L2-W07-C6-B1 L2-W07-C6-B3 FULL form FULL form FULL form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

LAYER 7 - L2 course 2
1 blanks, 1 pieces
PACK UNDER BEFORE STACKING ON: L2-W07-C2-B3 has nothing under it

LAYER 3 - L2 course 5 5 blanks, 6 pieces | LAYER 2 - L2 course 6 5 blanks, 5 pieces | LAYER 1 - L2 courses 7, 9, 10, 12 5 blanks, 6 pieces

PLACEMENT CHECKLIST tick each form as it is placed - bottom layer first

DETAIL A | | DETAIL C | DETAIL E
layer 6, 2x | | layer 5, 3x

Pieces without a detail here: see the placement checklist (1)

Plan view, top layer first - build from the bottom up

# Stack B01 CUT-7 - 6in XR35 straights

24 blanks, 44 pieces | 5 layers | L2 courses 3, 4, 5, 6, 8, 10 | stack height 1293 mm of 1300 mm cap

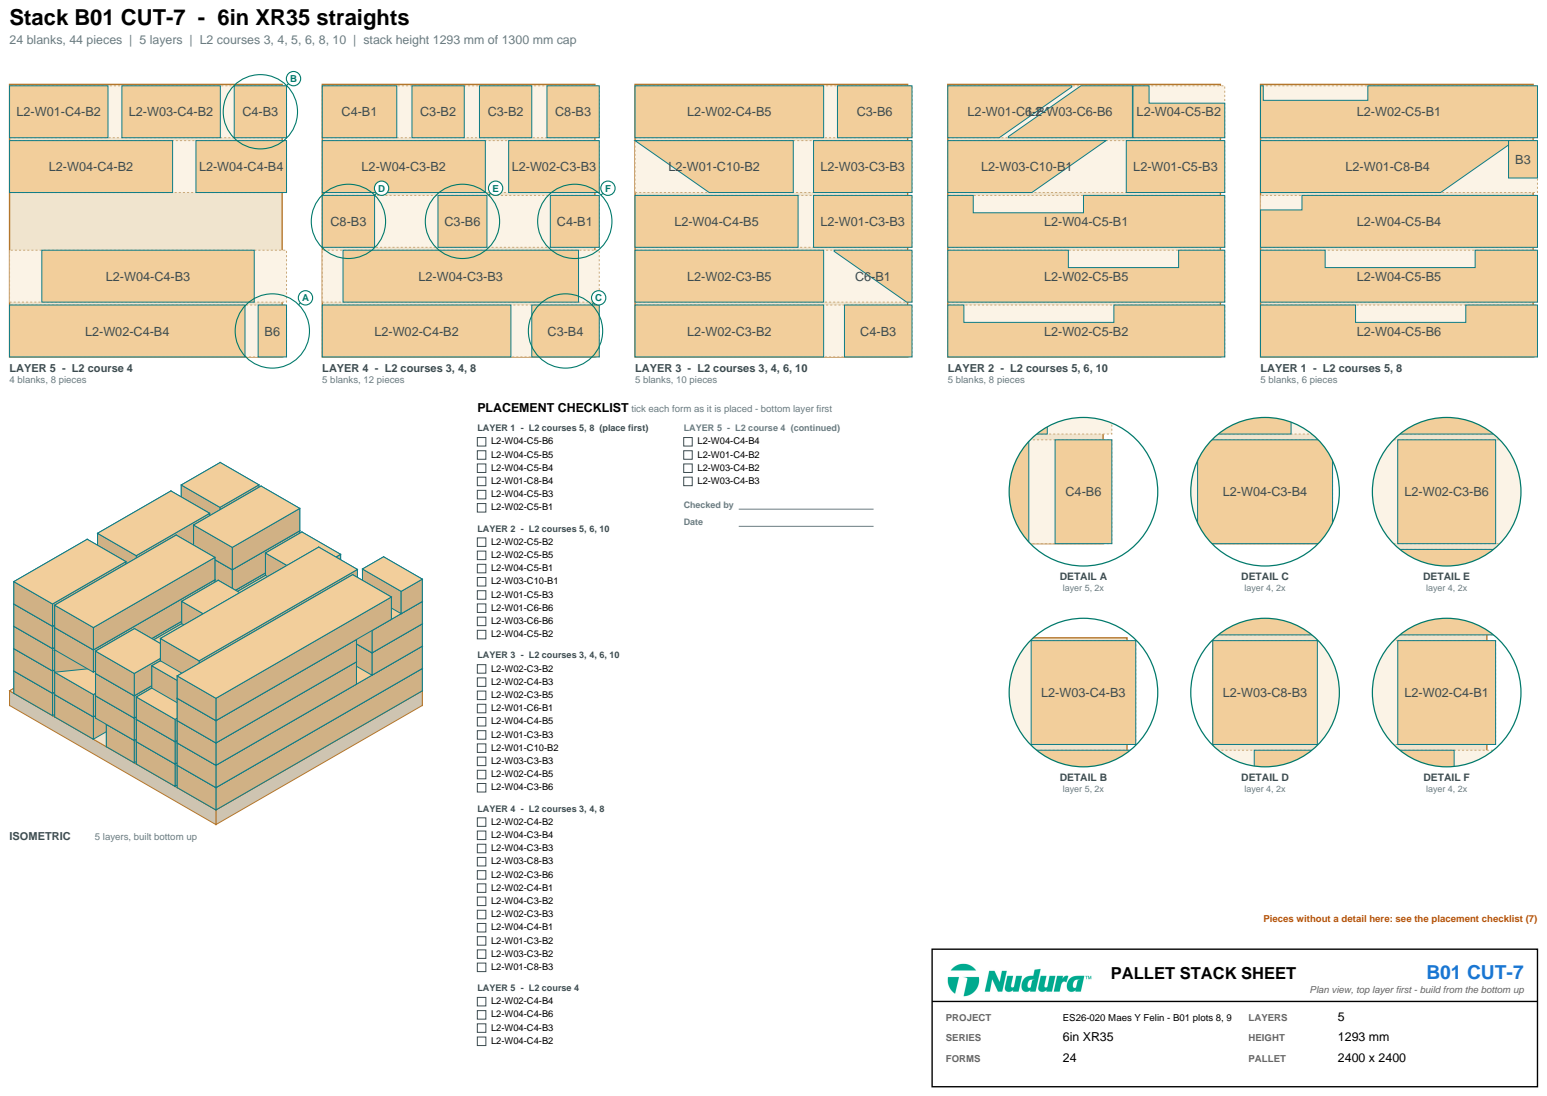
[picture p54: page 12]
LAYER 5 - L2 course 4 4 blanks, 8 pieces; LAYER 4 - L2 courses 3, 4, 8 5 blanks, 12 pieces; LAYER 3 - L2 courses 3, 4, 6, 10 5 blanks, 10 pieces; LAYER 2 - L2 courses 5, 6, 10 5 blanks, 8 pieces; LAYER 1 - L2 courses 5, 8 5 blanks, 6 pieces; ISOMETRIC; 5 layers, built bottom up; DETAIL A layer 5, 2x; DETAIL B layer 5, 2x; DETAIL C layer 4, 2x; DETAIL D layer 4, 2x; DETAIL E layer 4, 2x; DETAIL F layer 4, 2x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

PLACEMENT CHECKLIST tick each form as it is placed - bottom layer first

Pieces without a detail here: see the placement checklist (7)

Plan view, top layer first - build from the bottom up

# Stack B01 CUT-8 - 6in XR35 straights

## 16 blanks, 27 pieces | 5 layers | L2 courses 5-10 | stack height 1293 mm of 1300 mm cap

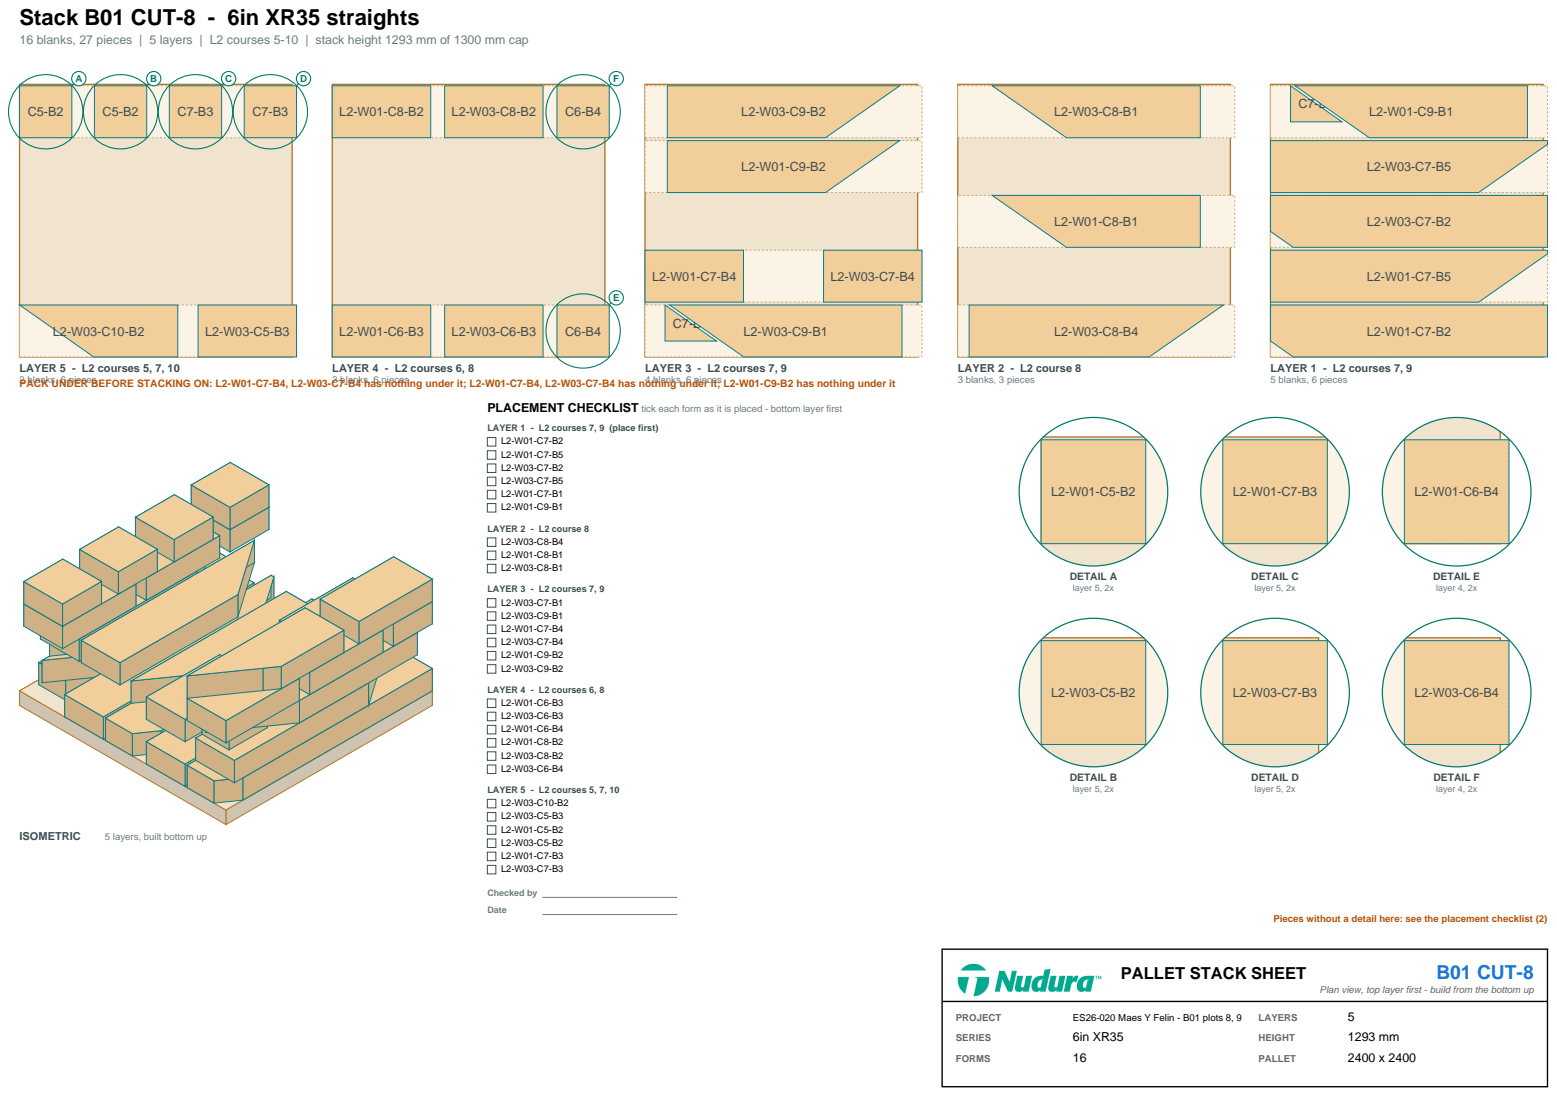
[picture p55: page 13]
LAYER 4 - L2 courses 6, 8 2 blanks, 6 pieces; LAYER 3 - L2 courses 7, 9 4 blanks, 6 pieces; LAYER 2 - L2 course 8 3 blanks, 3 pieces; LAYER 1 - L2 courses 7, 9 5 blanks, 6 pieces; ISOMETRIC; 5 layers, built bottom up; LAYER 1 - L2 courses 7, 9 (place first) L2-W01-C7-B2 L2-W01-C7-B5 L2-W03-C7-B2 L2-W03-C7-B5 L2-W01-C7-B1 L2-W01-C9-B1; LAYER 2 - L2 course 8 L2-W03-C8-B4 L2-W01-C8-B1 L2-W03-C8-B1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

LAYER 5 - L2 courses 5, 7, 10
2 blanks, 6 pieces
PACK UNDER BEFORE STACKING ON: L2-W01-C7-B4, L2-W03-C7-B4 has nothing under it; L2-W01-C7-B4, L2-W03-C7-B4 has nothing under it; L2-W01-C9-B2 has nothing under it

PLACEMENT CHECKLIST tick each form as it is placed - bottom layer first

DETAIL A DETAIL C DETAIL E layer 5, 2x layer 5, 2x layer 4, 2x

DETAIL B DETAIL D layer 5, 2x layer 5, 2x | | | | DETAIL F | | layer 4, 2x

Pieces without a detail here: see the placement checklist (2)

PALLET STACK SHEET | | | B01 CUT-8

Plan view, top layer first - build from the bottom up

PROJECT ES26-020 Maes Y Felin - B01 plots 8, 9 LAYERS FORMS 16 | | | 5

# Stack B01 ACCESSORIES - accessory spot

B01 plots 8, 9 | ONE floor spot reserved on the wagon for the whole block's accessories | 1 artic + 1 rigid

# ACCESSORIES

## B01 - plots 8, 9

### 2400 x 2400 floor spot

### Load at the TAIL of vehicle 1 - first off

## Contents (from the take-off, all levels of the block)

Item | SKU | Qty | Bundles | Levels
Form-Lock (6in XR35) | NUS-ABLOK-06 | 54 | 7 | FB, L1, L2
Spray Foam Cans | NUS-SF-BOX | 21 | 3 | FB, L1, L2
Form-Lock (6in Standard) | NUS-ABLOK-06 | 8 | 2 | L1, L2
T-Form Support Straps | NUS-ATSTP-00 | 38 | 2 | L1, L2
Vertical Joint Clips | NUS-A0VJC-00 | 886 | 5 | L1, L2

Accessories cannot be sized accurately yet, so the block's accessories take one floor spot.
Openings close with 47 x 150 timber closers (Beech) - supply TBC, not in this spot (RFI-23).
PALLET STACK SHEET | B01 ACC

Accessory spot - one per block

PROJECT | ES26-020 Maes Y Felin - B01 plots 8, 9
BLOCK | B01 plots 8, 9
ITEMS | 5
SPOT | 1 floor spot
VEHICLE | 1 artic + 1 rigid
