BuildEase2026/mf-icf-approval-1f4119fc49/sequence/docs/ES26-020-OGW B03 - Pallet stack sheets.pdf

# Stack B03 CNR-1 - 6in XR35 corners

4 blanks, 4 pieces | 1 layers | FB course 1 | stack height 607 mm of 1300 mm cap FB⁻CR⁰¹⁻C¹ | FB⁻CR⁰²⁻C¹

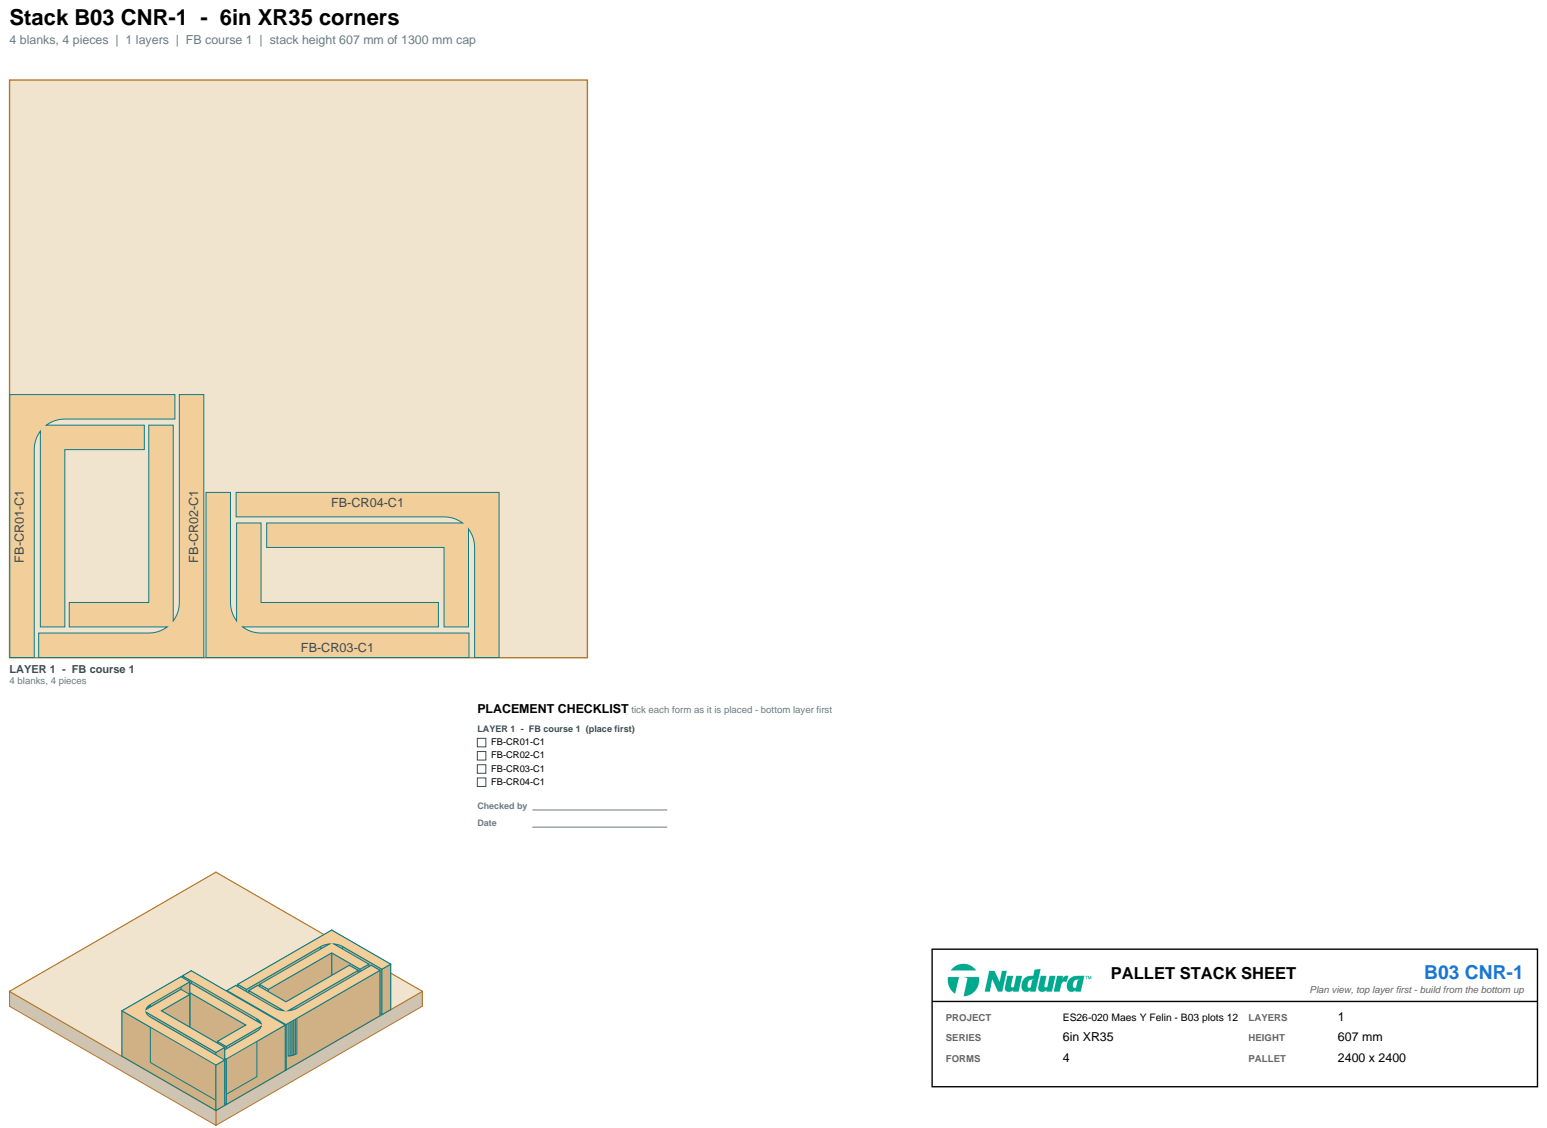
[picture p69: page 1]
Checked by; Date; PALLET STACK SHEET; B03 CNR-1; PROJECT; ES26-020 Maes Y Felin - B03 plots 12; SERIES; FORMS; LAYERS; HEIGHT; PALLET

LAYER 1 - FB course 1
4 blanks, 4 pieces

PLACEMENT CHECKLIST tick each form as it is placed - bottom layer first

LAYER 1 - FB course 1 (place first)

Plan view, top layer first - build from the bottom up

# Stack B03 CUT-1 - 6in XR35 straights

## 11 blanks, 13 pieces | 3 layers | FB course 1 | stack height 836 mm of 1300 mm cap

## FB-W04-C1-B3

### LAYER 3 - FB course 1

1 blanks, 1 pieces

## FB-W02-C1-B2

## FB-W03-C1-B1

## FB-W04-C1-B2

FB-W01-C1-B3 | FB-W02-C1-B3
FB-W03-C1-B3 | C1-B4

### LAYER 2 - FB course 1

5 blanks, 7 pieces

## FB-W03-C1-B2

## FB-W04-C1-B1

## FB-W01-C1-B1

## FB-W01-C1-B2

## FB-W02-C1-B1

### LAYER 1 - FB course 1

5 blanks, 5 pieces

A

## FB-W02-C1-B4

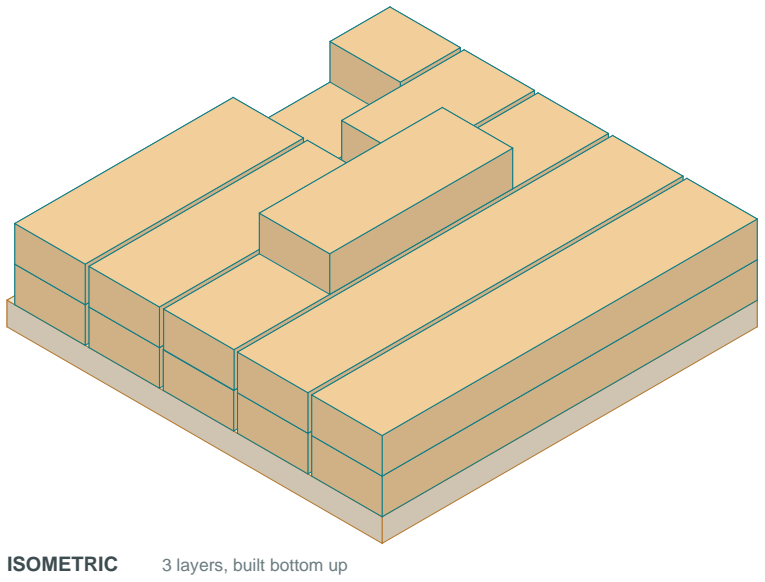
[picture p70: figure]
ISOMETRIC; 3 layers, built bottom up

DETAIL A
layer 2, 2x

PLACEMENT CHECKLIST tick each form as it is placed - bottom layer first

LAYER 1 - FB course 1 (place first)

### 5 x UNASSEMBLED PANEL (pre-cut)

FB-W03-C1-B2
FB-W04-C1-B1
FB-W01-C1-B1
FB-W01-C1-B2
FB-W02-C1-B1

LAYER 2 - FB course 1

### 5 x UNASSEMBLED PANEL (pre-cut)

FB-W02-C1-B2
FB-W03-C1-B1
FB-W04-C1-B2
FB-W01-C1-B3
FB-W02-C1-B3
FB-W03-C1-B3
FB-W02-C1-B4

LAYER 3 - FB course 1

### 1 x UNASSEMBLED PANEL (pre-cut)

FB-W04-C1-B3

Checked by
Date
PALLET STACK SHEET | | B03 CUT-1
| Plan view, top layer first - build from the bottom up
PROJECT | ES26-020 Maes Y Felin - B03 plots 12
FORMS | 11
LAYERS | 3
HEIGHT | 836 mm

# Stack B03 CNR-2 - 6in XR35 corners

24 blanks, 24 pieces | 2 layers | L1 courses 1-6 | stack height 1064 mm of 1300 mm cap FULL | FULL

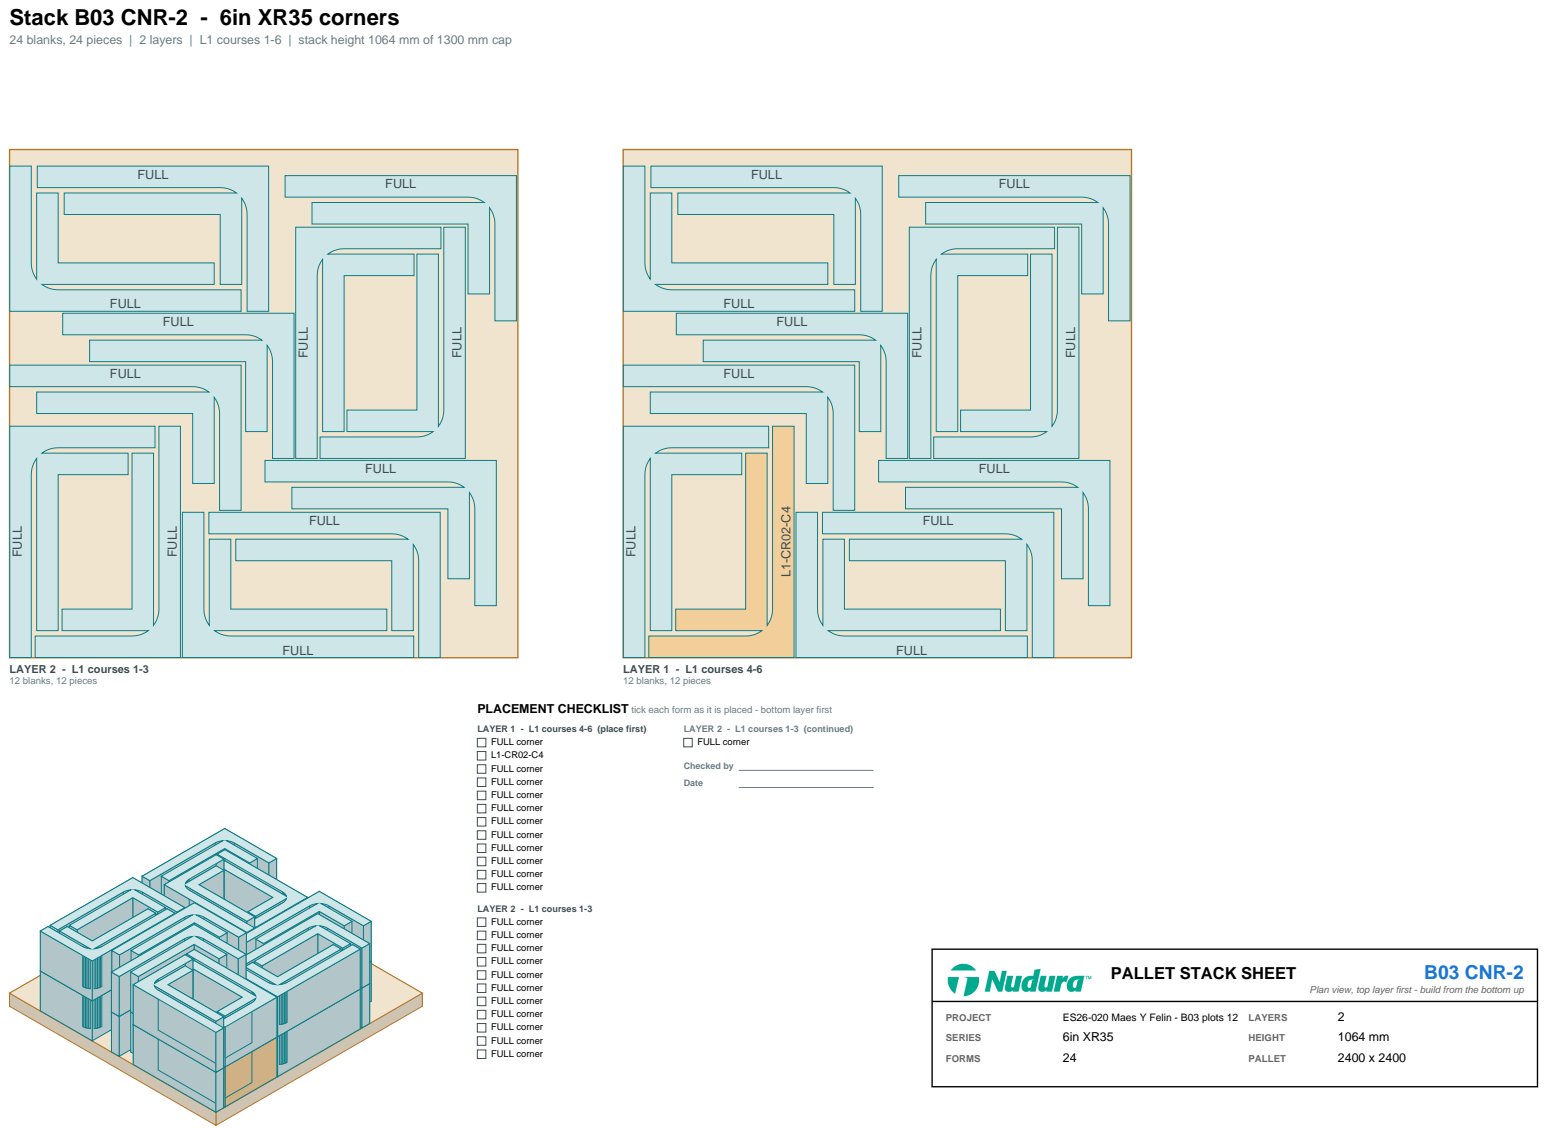
[picture p71: page 3]
FULL; LAYER 2 - L1 courses 1-3 12 blanks, 12 pieces; LAYER 1 - L1 courses 4-6 12 blanks, 12 pieces; LAYER 2 - L1 courses 1-3 FULL corner FULL corner FULL corner FULL corner FULL corner FULL corner FULL corner FULL corner FULL corner FULL corner FULL corner; Checked by; Date; PALLET STACK SHEET; B03 CNR-2; PROJECT; ES26-020 Maes Y Felin - B03 plots 12; FORMS; LAYERS; HEIGHT

PLACEMENT CHECKLIST tick each form as it is placed - bottom layer first

LAYER 1 - L1 courses 4-6 (place first)
FULL corner

LAYER 2 - L1 courses 1-3 (continued)

Plan view, top layer first - build from the bottom up

# Stack B03 CUT-2 - 6in XR35 straights

## 19 blanks, 37 pieces | 5 layers | L1 courses 1-6 | stack height 1293 mm of 1300 mm cap

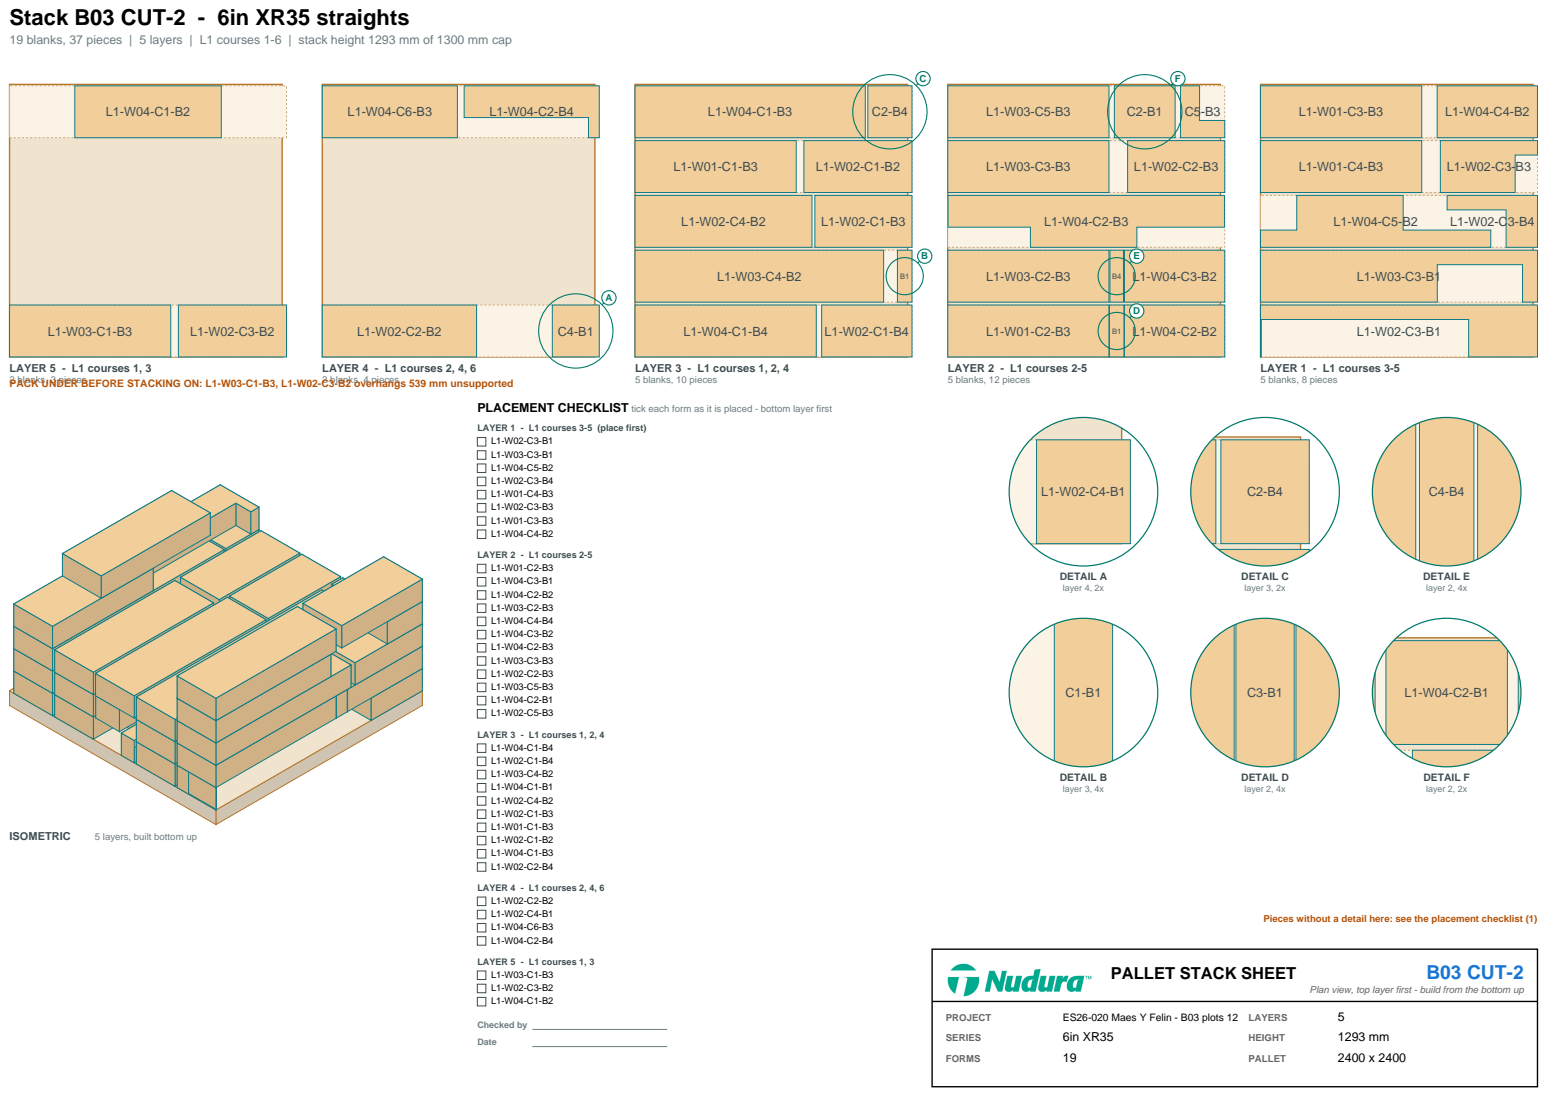
[picture p72: page 4]
LAYER 4 - L1 courses 2, 4, 6 2 blanks, 4 pieces; LAYER 3 - L1 courses 1, 2, 4 5 blanks, 10 pieces; LAYER 2 - L1 courses 2-5 5 blanks, 12 pieces; LAYER 1 - L1 courses 3-5 5 blanks, 8 pieces; ISOMETRIC; 5 layers, built bottom up; DETAIL A layer 4, 2x; DETAIL B layer 3, 4x; DETAIL C layer 3, 2x; DETAIL D layer 2, 4x; DETAIL E layer 2, 4x; DETAIL F layer 2, 2x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

LAYER 5 - L1 courses 1, 3
2 blanks, 3 pieces
PACK UNDER BEFORE STACKING ON: L1-W03-C1-B3, L1-W02-C3-B2 overhangs 539 mm unsupported

PLACEMENT CHECKLIST tick each form as it is placed - bottom layer first

Pieces without a detail here: see the placement checklist (1)

Plan view, top layer first - build from the bottom up

# Stack B03 FULL-1 - 6in XR35 straights

## 25 blanks, 25 pieces | 5 layers | L1 courses 1-6 | stack height 1293 mm of 1300 mm cap

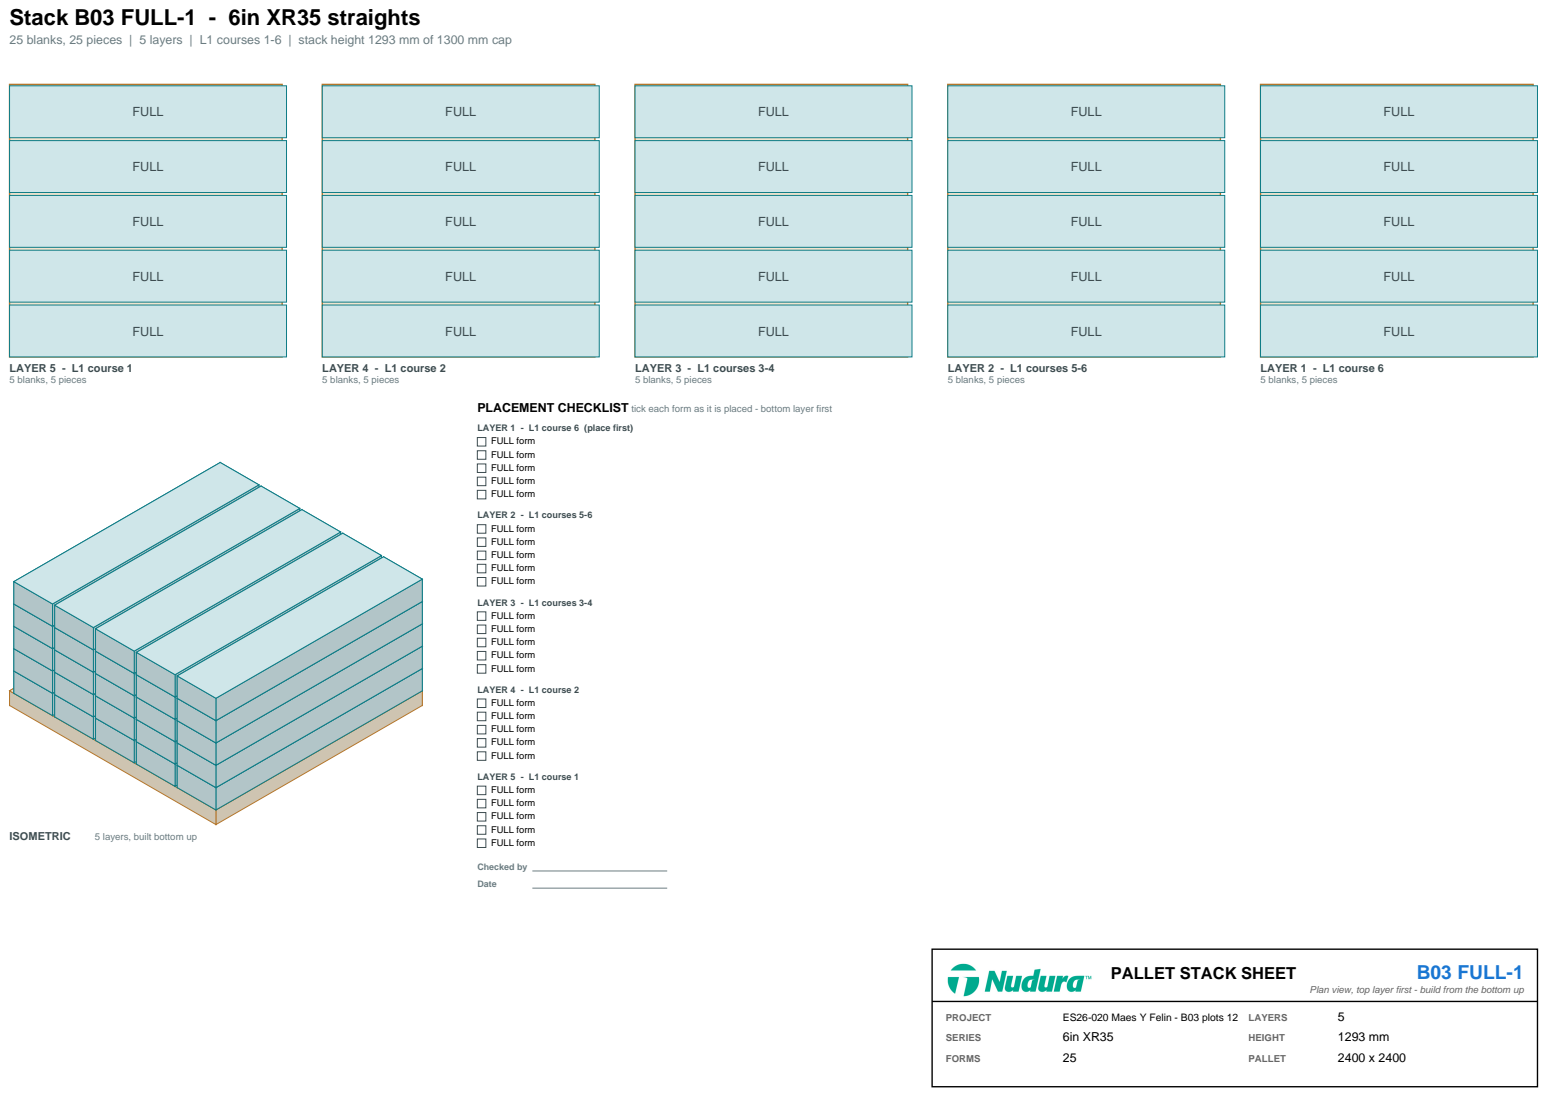
[picture p73: page 5]
FULL; LAYER 5 - L1 course 1 5 blanks, 5 pieces; LAYER 4 - L1 course 2 5 blanks, 5 pieces; LAYER 3 - L1 courses 3-4 5 blanks, 5 pieces; LAYER 2 - L1 courses 5-6 5 blanks, 5 pieces; LAYER 1 - L1 course 6 5 blanks, 5 pieces; ISOMETRIC; 5 layers, built bottom up; LAYER 2 - L1 courses 5-6 FULL form FULL form FULL form FULL form FULL form; LAYER 3 - L1 courses 3-4 FULL form FULL form FULL form FULL form FULL form; LAYER 4 - L1 course 2 FULL form FULL form FULL form FULL form FULL form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

PLACEMENT CHECKLIST tick each form as it is placed - bottom layer first

LAYER 1 - L1 course 6 (place first)
FULL form

Plan view, top layer first - build from the bottom up

# Stack B03 CUT-3 - 6in XR35 straights

## 12 blanks, 19 pieces | 4 layers | L1 courses 3-6 | stack height 1064 mm of 1300 mm cap

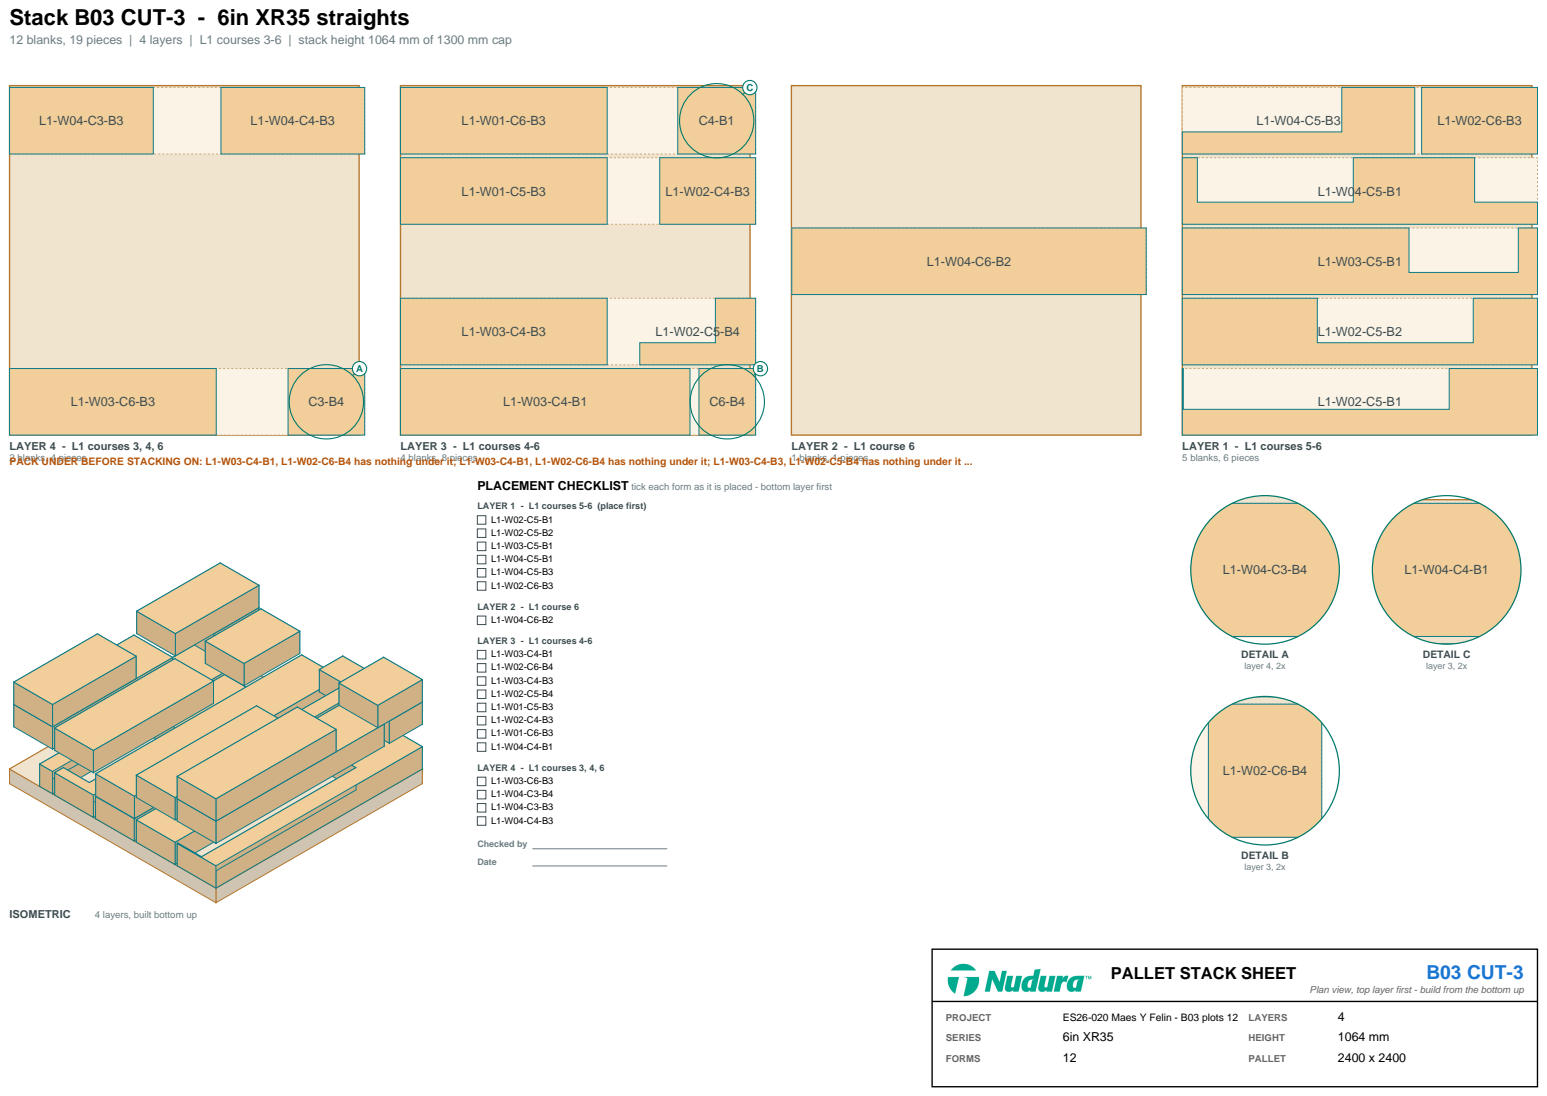
[picture p74: page 6]
LAYER 3 - L1 courses 4-6 4 blanks, 8 pieces; LAYER 2 - L1 course 6 1 blanks, 1 pieces; LAYER 1 - L1 courses 5-6 5 blanks, 6 pieces; ISOMETRIC; 4 layers, built bottom up; DETAIL A layer 4, 2x; DETAIL B layer 3, 2x; DETAIL C layer 3, 2x; LAYER 1 - L1 courses 5-6 (place first) L1-W02-C5-B1 L1-W02-C5-B2 L1-W03-C5-B1 L1-W04-C5-B1 L1-W04-C5-B3 L1-W02-C6-B3; LAYER 2 - L1 course 6 L1-W04-C6-B2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

LAYER 4 - L1 courses 3, 4, 6
2 blanks, 4 pieces
PACK UNDER BEFORE STACKING ON: L1-W03-C4-B1, L1-W02-C6-B4 has nothing under it; L1-W03-C4-B1, L1-W02-C6-B4 has nothing under it; L1-W03-C4-B3, L1-W02-C5-B4 has nothing under it ...

PLACEMENT CHECKLIST tick each form as it is placed - bottom layer first

Plan view, top layer first - build from the bottom up

# Stack B03 CNR-3 - 6in XR35 corners

20 blanks, 20 pieces | 2 layers | L2 courses 1-5 | stack height 1064 mm of 1300 mm cap FULL | FULL

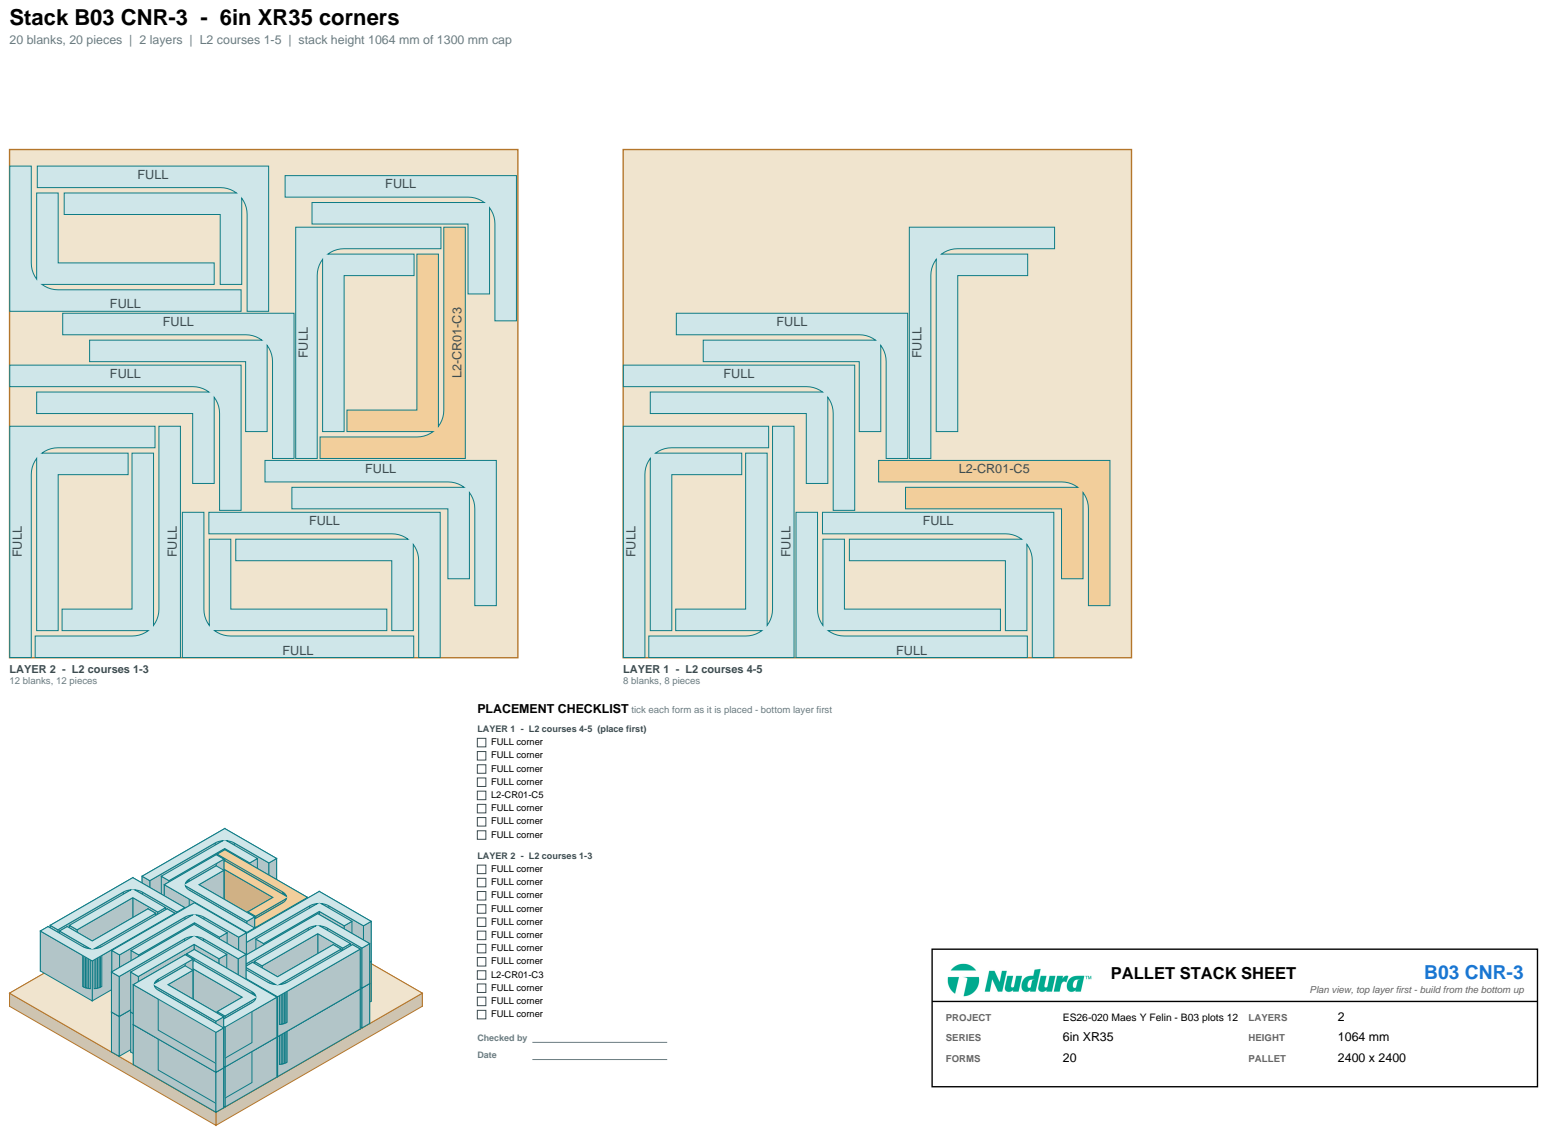
[picture p75: page 7]
FULL; LAYER 2 - L2 courses 1-3 12 blanks, 12 pieces; LAYER 1 - L2 courses 4-5 8 blanks, 8 pieces; LAYER 2 - L2 courses 1-3 FULL corner FULL corner FULL corner FULL corner FULL corner FULL corner FULL corner FULL corner L2-CR01-C3 FULL corner FULL corner FULL corner; Checked by; Date; PALLET STACK SHEET; B03 CNR-3; PROJECT; ES26-020 Maes Y Felin - B03 plots 12; FORMS; LAYERS; HEIGHT

PLACEMENT CHECKLIST tick each form as it is placed - bottom layer first

LAYER 1 - L2 courses 4-5 (place first)
FULL corner

Plan view, top layer first - build from the bottom up

# Stack B03 CUT-4 - 6in XR35 straights

## 25 blanks, 43 pieces | 5 layers | L2 courses 1-5 | stack height 1293 mm of 1300 mm cap

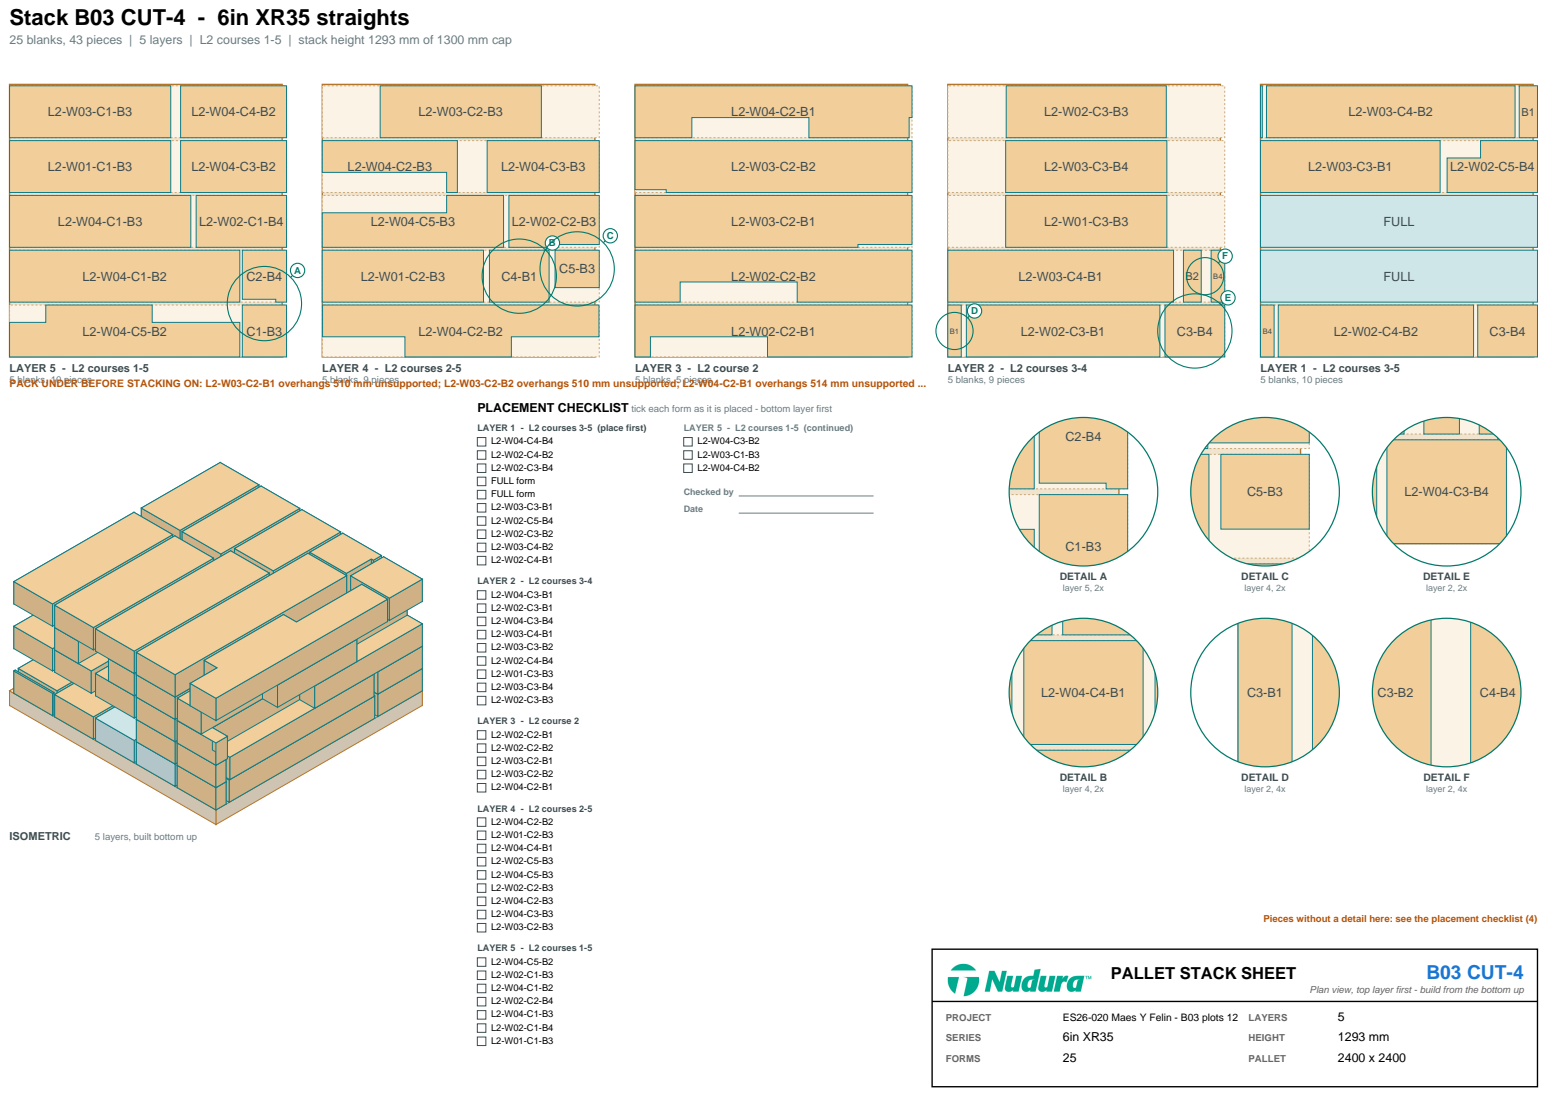
[picture p76: page 8]
LAYER 4 - L2 courses 2-5 5 blanks, 9 pieces; LAYER 3 - L2 course 2 5 blanks, 5 pieces; LAYER 2 -; L2 courses 3-4; 5 blanks, 9 pieces; FULL; LAYER 1; - L2 courses 3-5; 5 blanks, 10 pieces; ISOMETRIC; 5 layers, built bottom up; DETAIL A layer 5, 2x; DETAIL B layer 4, 2x; DETAIL C layer 4, 2x; DETAIL D layer 2, 4x; DETAIL E layer 2, 2x; DETAIL F layer 2, 4x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

LAYER 5 - L2 courses 1-5
5 blanks, 10 pieces
PACK UNDER BEFORE STACKING ON: L2-W03-C2-B1 overhangs 510 mm unsupported; L2-W03-C2-B2 overhangs 510 mm unsupported; L2-W04-C2-B1 overhangs 514 mm unsupported ...

PLACEMENT CHECKLIST tick each form as it is placed - bottom layer first

Pieces without a detail here: see the placement checklist (4)

Plan view, top layer first - build from the bottom up

# Stack B03 CUT-5 - 6in XR35 straights

## 25 blanks, 25 pieces | 5 layers | L2 courses 4-5 | stack height 1293 mm of 1300 mm cap

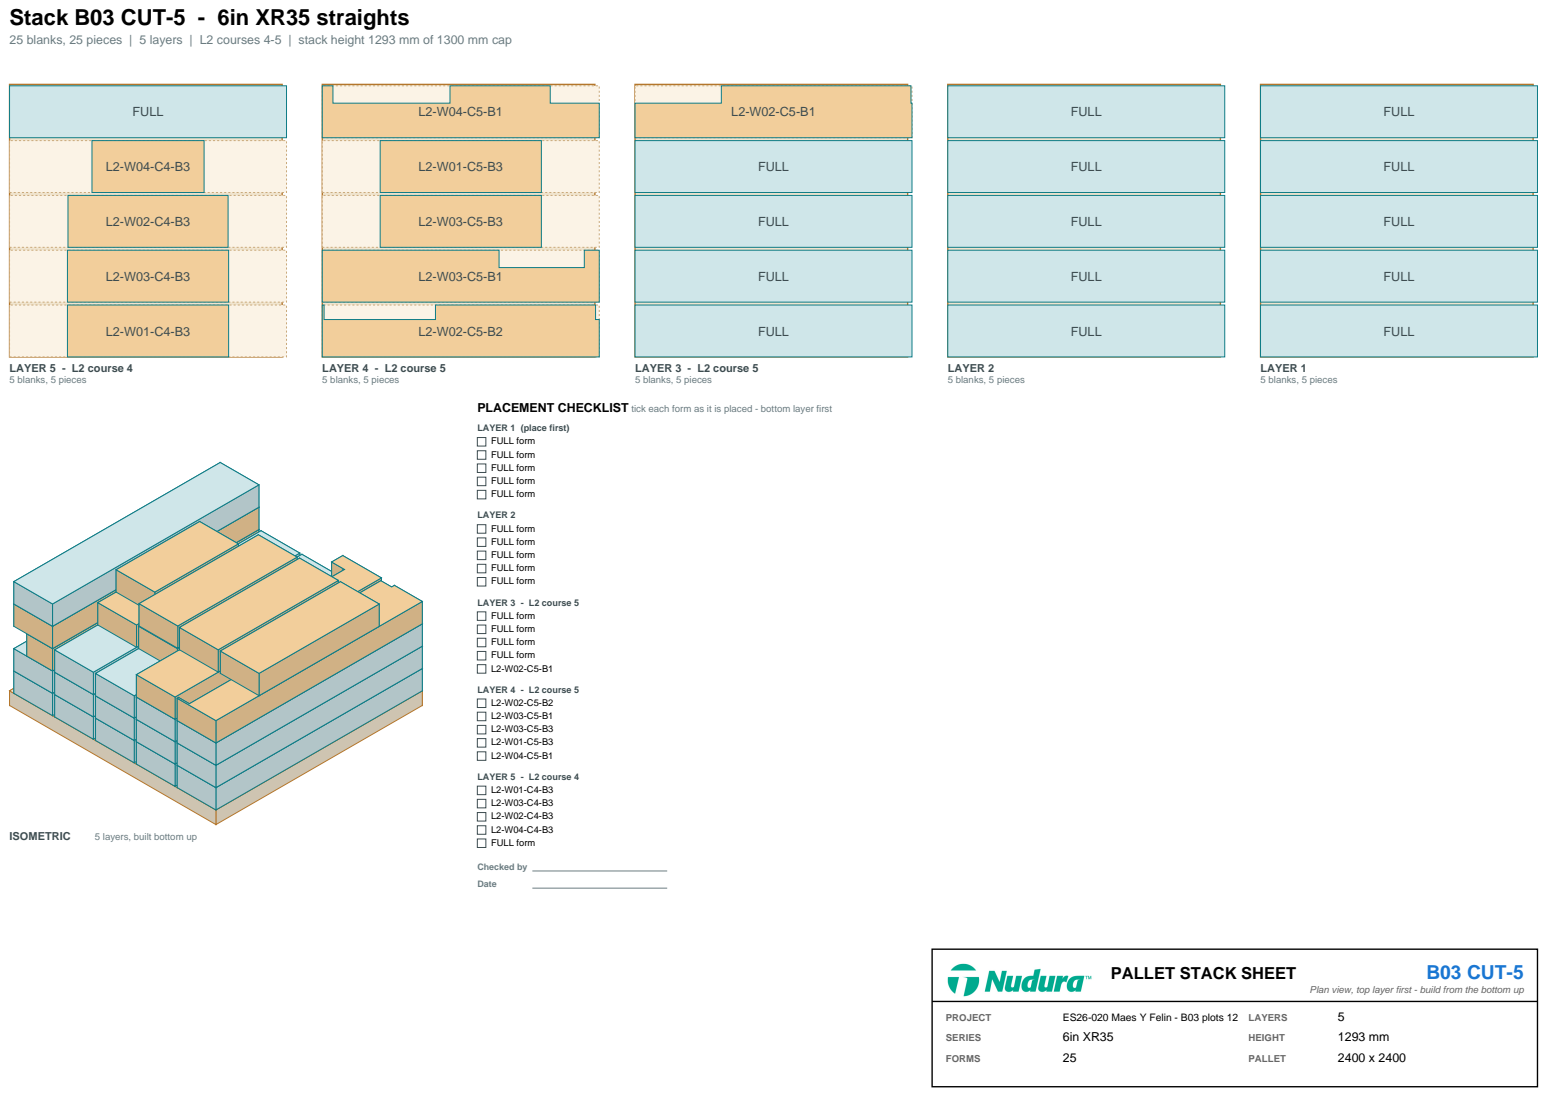
[picture p77: page 9]
FULL; LAYER 5 - L2 course 4 5 blanks, 5 pieces; LAYER 4 - L2 course 5 5 blanks, 5 pieces; LAYER 3 - L2 course 5 5 blanks, 5 pieces; LAYER 2 5 blanks, 5 pieces; LAYER 1 5 blanks, 5 pieces; ISOMETRIC; 5 layers, built bottom up; LAYER 2 FULL form FULL form FULL form FULL form FULL form; LAYER 3 - L2 course 5 FULL form FULL form FULL form FULL form L2-W02-C5-B1; LAYER 4 - L2 course 5 L2-W02-C5-B2 L2-W03-C5-B1 L2-W03-C5-B3 L2-W01-C5-B3 L2-W04-C5-B1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

PLACEMENT CHECKLIST tick each form as it is placed - bottom layer first

LAYER 1 (place first)
FULL form

Plan view, top layer first - build from the bottom up

# Stack B03 ACCESSORIES - accessory spot

B03 plots 12 | ONE floor spot reserved on the wagon for the whole block's accessories | 1 artic

# ACCESSORIES

## B03 - plots 12

### 2400 x 2400 floor spot

### Load at the TAIL of vehicle 1 - first off

## Contents (from the take-off, all levels of the block)

Item | SKU | Qty | Bundles | Levels
Form-Lock (6in XR35) | NUS-ABLOK-06 | 53 | 8 | FB, L1, L2
Spray Foam Cans | NUS-SF-BOX | 16 | 3 | FB, L1, L2
Vertical Joint Clips | NUS-A0VJC-00 | 528 | 4 | L1, L2

Accessories cannot be sized accurately yet, so the block's accessories take one floor spot.
Openings close with 47 x 150 timber closers (Beech) - supply TBC, not in this spot (RFI-23).
PALLET STACK SHEET | B03 ACC

Accessory spot - one per block

PROJECT | ES26-020 Maes Y Felin - B03 plots 12
BLOCK | B03 plots 12
ITEMS | 3
SPOT | 1 floor spot
VEHICLE | 1 artic
