BuildEase2026/mf-icf-approval-1f4119fc49/sequence/docs/ES26-020-POW B05 - Pallet stack sheets.pdf

# Stack B05 CNR-1 - 6in XR35 corners

4 blanks, 4 pieces | 1 layers | FB course 1 | stack height 607 mm of 1300 mm cap FB⁻CR⁰¹⁻C¹ | FB⁻CR⁰²⁻C¹

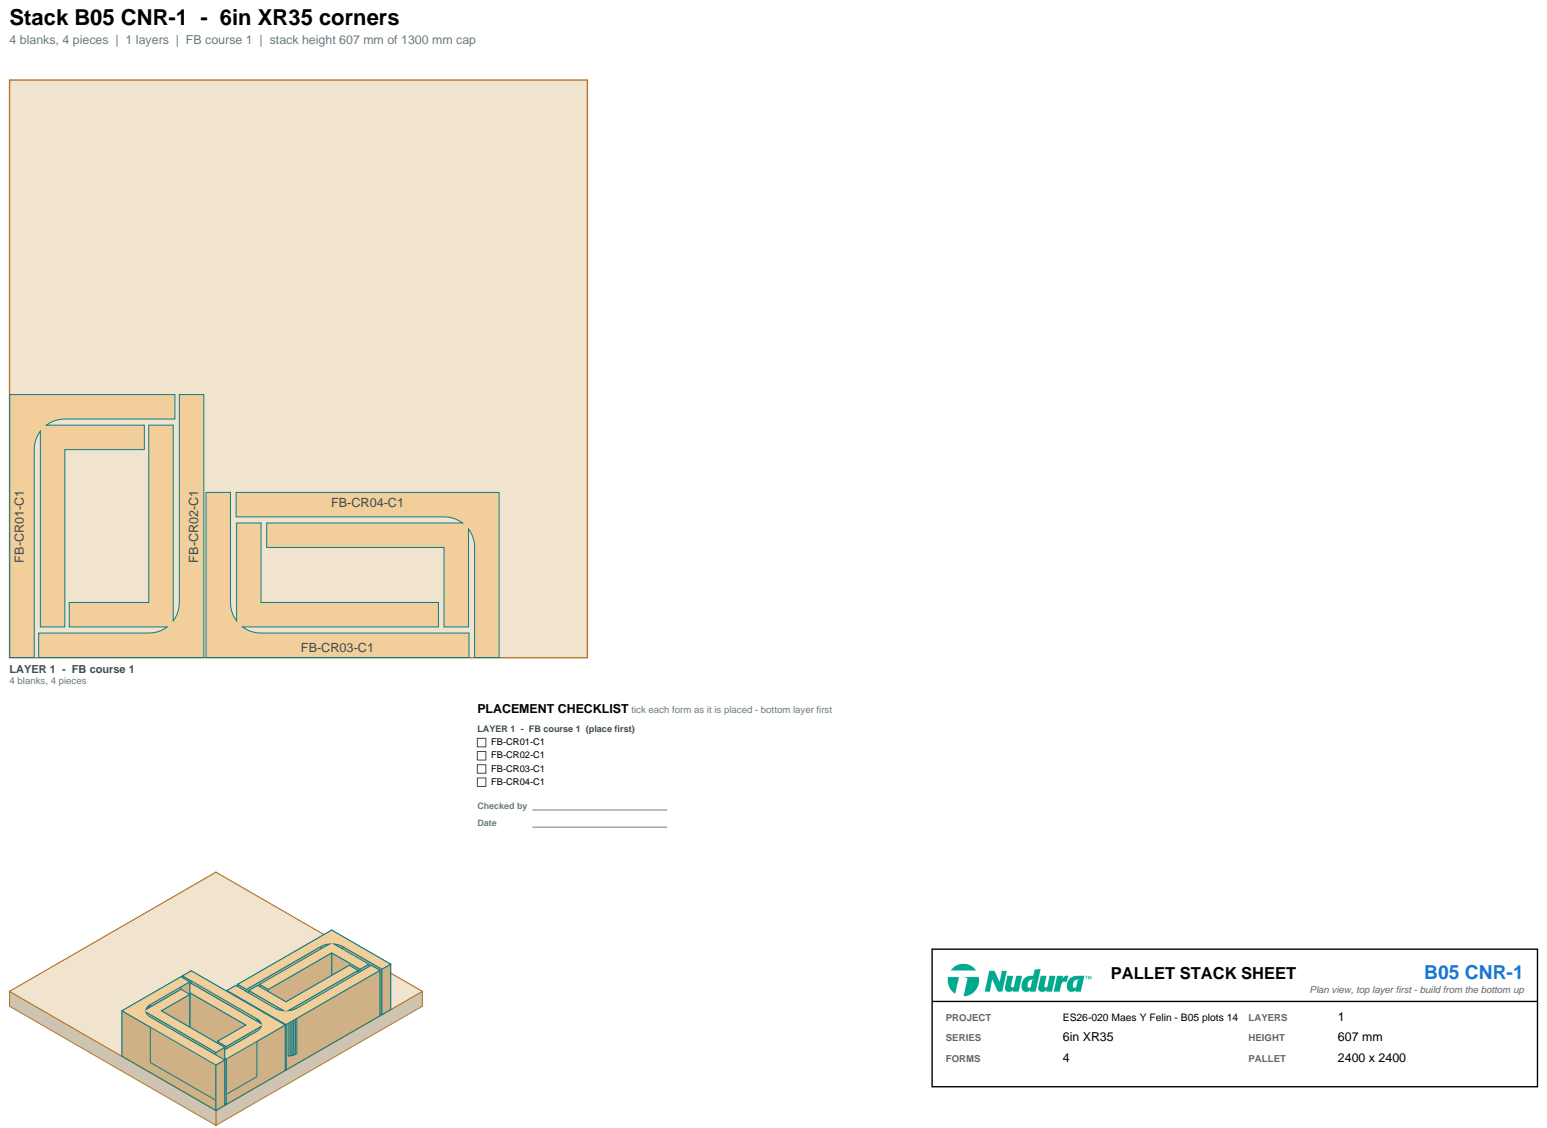
[picture p86: page 1]
Checked by; Date; PALLET STACK SHEET; B05 CNR-1; PROJECT; ES26-020 Maes Y Felin - B05 plots 14; SERIES; FORMS; LAYERS; HEIGHT; PALLET

LAYER 1 - FB course 1
4 blanks, 4 pieces

PLACEMENT CHECKLIST tick each form as it is placed - bottom layer first

LAYER 1 - FB course 1 (place first)

Plan view, top layer first - build from the bottom up

# Stack B05 CUT-1 - 6in XR35 straights

## 11 blanks, 14 pieces | 3 layers | FB course 1 | stack height 836 mm of 1300 mm cap

FB-W02-C1-B1 | FB-W03-C1-B2

### LAYER 3 - FB course 1

1 blanks, 2 pieces

## FB-W01-C1-B2

FB-W02-C1-B2 | FB-W04-C1-B2

## FB-W03-C1-B4

FB-W04-C1-B1 | FB-W01-C1-B3

## FB-W03-C1-B3

### LAYER 2 - FB course 1

5 blanks, 7 pieces

## FB-W04-C1-B3

## FB-W01-C1-B1

## FB-W01-C1-B4

## FB-W02-C1-B3

## FB-W03-C1-B1

### LAYER 1 - FB course 1

5 blanks, 5 pieces

PLACEMENT CHECKLIST tick each form as it is placed - bottom layer first

LAYER 1 - FB course 1 (place first)

### 5 x UNASSEMBLED PANEL (pre-cut)

FB-W04-C1-B3
FB-W01-C1-B1
FB-W01-C1-B4
FB-W02-C1-B3
FB-W03-C1-B1

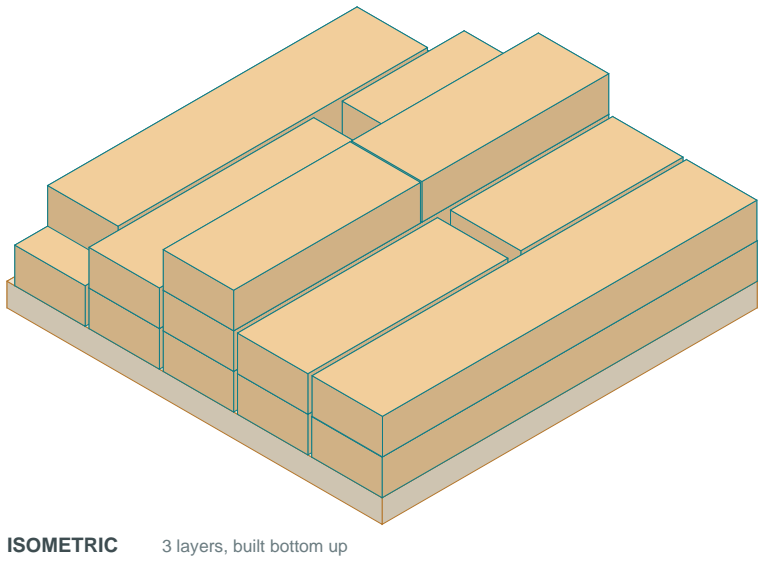
[picture p87: figure]
ISOMETRIC; 3 layers, built bottom up

LAYER 2 - FB course 1

### 5 x UNASSEMBLED PANEL (pre-cut)

FB-W01-C1-B2
FB-W02-C1-B2
FB-W04-C1-B2
FB-W03-C1-B4
FB-W04-C1-B1
FB-W01-C1-B3
FB-W03-C1-B3

LAYER 3 - FB course 1

### 1 x UNASSEMBLED PANEL (pre-cut)

FB-W02-C1-B1
FB-W03-C1-B2

Checked by
Date | PALLET STACK SHEET | B05 CUT-1
| | Plan view, top layer first - build from the bottom up
PROJECT | ES26-020 Maes Y Felin - B05 plots 14
FORMS | 11
LAYERS | 3
HEIGHT | 836 mm

# Stack B05 CNR-2 - 6in XR35 corners

24 blanks, 24 pieces | 2 layers | L1 courses 1-6 | stack height 1064 mm of 1300 mm cap L1⁻CR⁰¹⁻C¹ | FULL

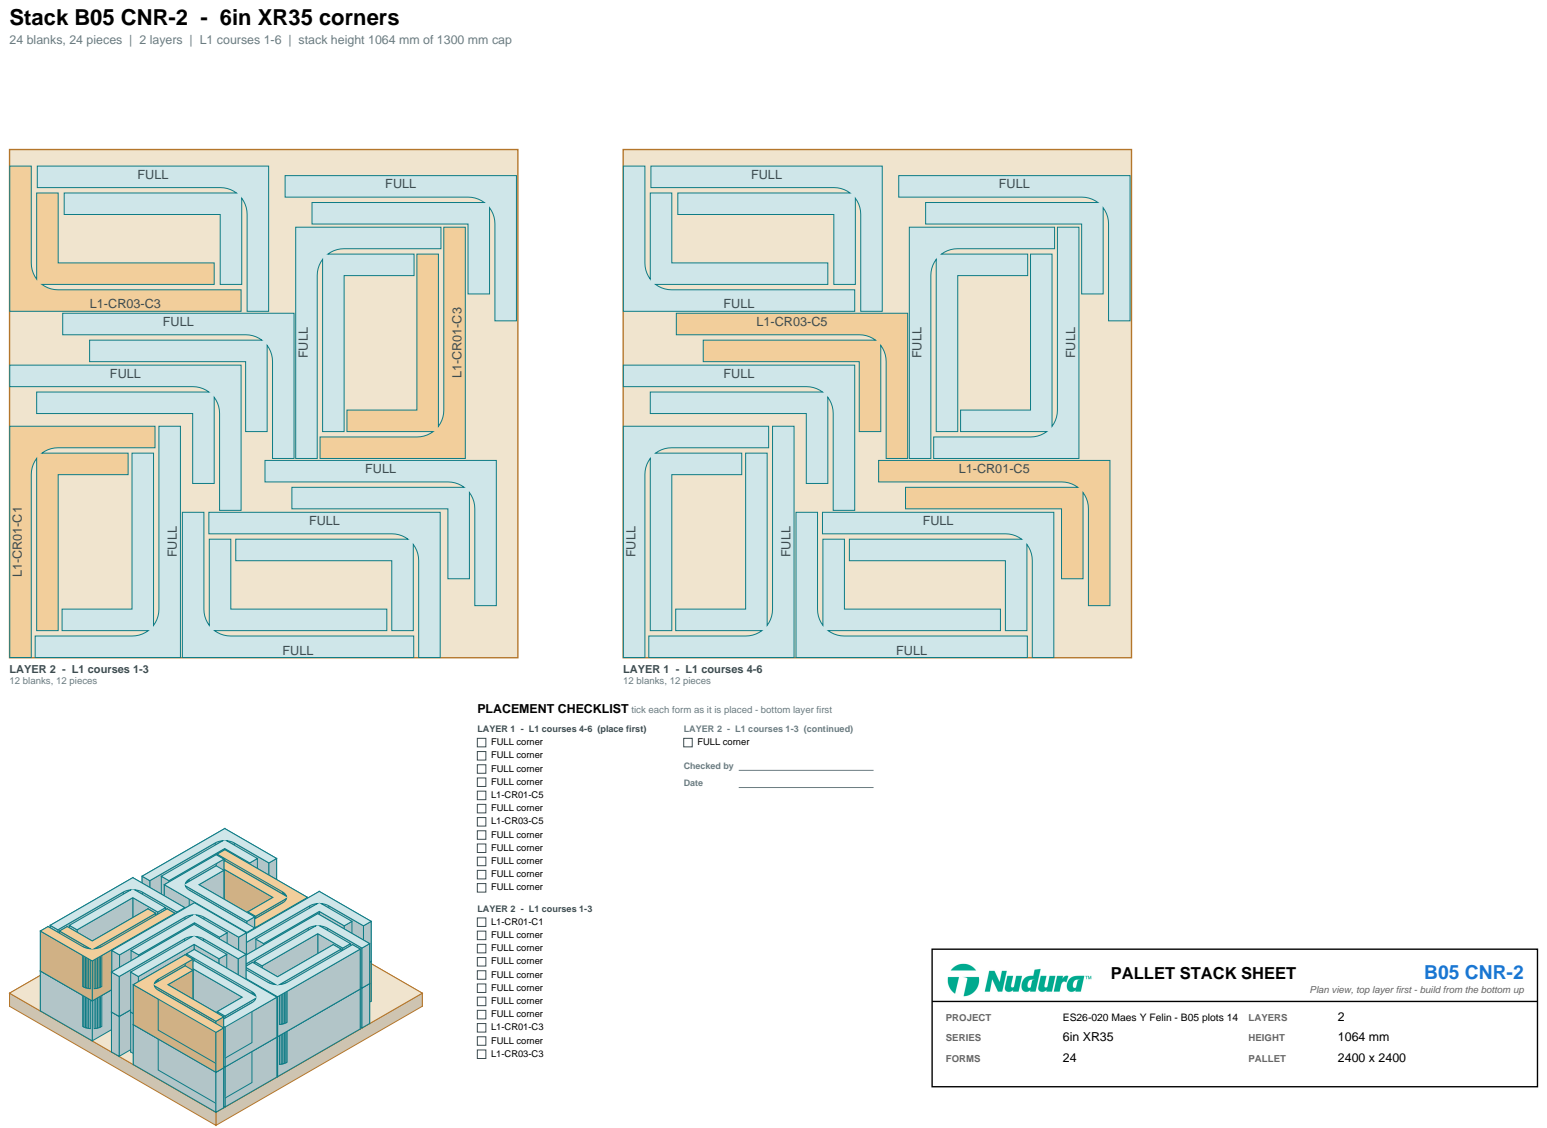
[picture p88: page 3]
FULL; LAYER 2 - L1 courses 1-3 12 blanks, 12 pieces; LAYER 1 - L1 courses 4-6 12 blanks, 12 pieces; LAYER 2 - L1 courses 1-3 L1-CR01-C1 FULL corner FULL corner FULL corner FULL corner FULL corner FULL corner FULL corner L1-CR01-C3 FULL corner L1-CR03-C3; Checked by; Date; PALLET STACK SHEET; B05 CNR-2; PROJECT; ES26-020 Maes Y Felin - B05 plots 14; FORMS; LAYERS; HEIGHT

PLACEMENT CHECKLIST tick each form as it is placed - bottom layer first

LAYER 1 - L1 courses 4-6 (place first)
FULL corner

LAYER 2 - L1 courses 1-3 (continued)

Plan view, top layer first - build from the bottom up

# Stack B05 CUT-2 - 6in XR35 straights

## 22 blanks, 41 pieces | 5 layers | L1 courses 1-6 | stack height 1293 mm of 1300 mm cap

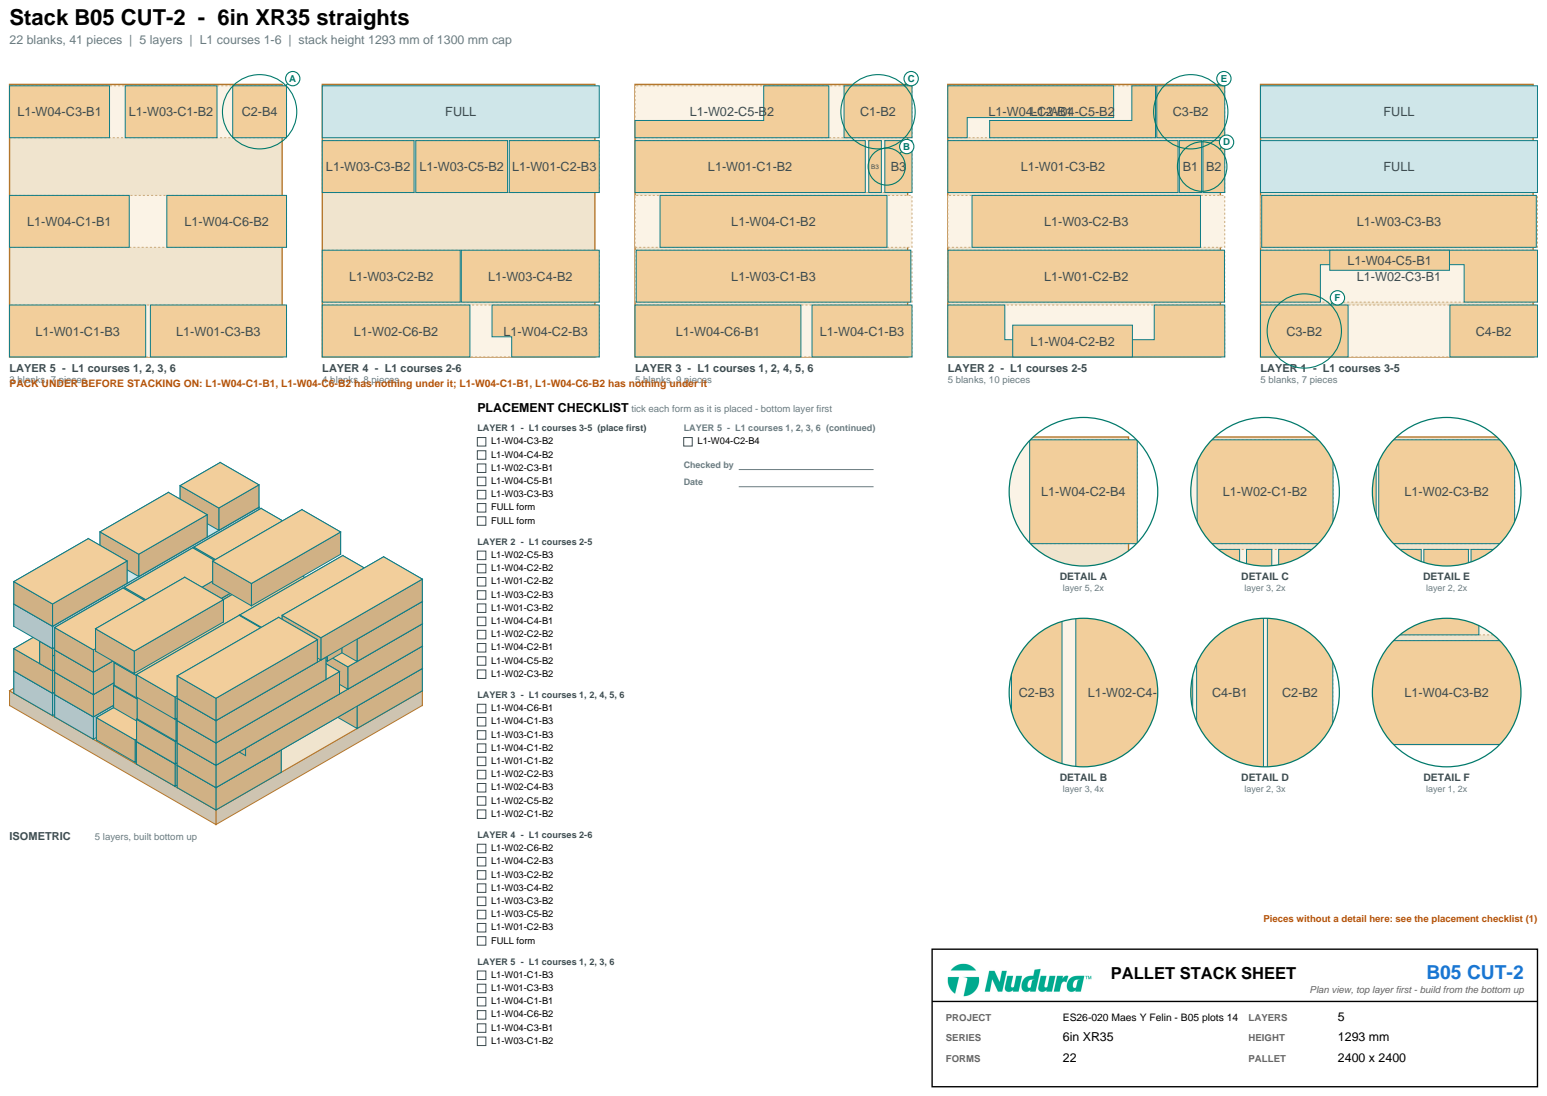
[picture p89: page 4]
FULL; LAYER 4 - L1 courses 2-6 4 blanks, 8 pieces; LAYER 3 - L1 courses 1, 2, 4, 5, 6 5 blanks, 9 pieces; LAYER 2 - L1 courses 2-5 5 blanks, 10 pieces; LAYER 1 - L1 courses 3-5 5 blanks, 7 pieces; ISOMETRIC; 5 layers, built bottom up; DETAIL A layer 5, 2x; DETAIL B layer 3, 4x; DETAIL C layer 3, 2x; DETAIL D layer 2, 3x; DETAIL E layer 2, 2x; DETAIL F layer 1, 2x; LAYER 1 - L1 courses 3-5; (place first); L1-W04-C3-B2 L1-W04-C4-B2 L1-W02-C3-B1 L1-W04-C5-B1 L1-W03-C3-B3 FULL form FULL form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

LAYER 5 - L1 courses 1, 2, 3, 6
3 blanks, 7 pieces
PACK UNDER BEFORE STACKING ON: L1-W04-C1-B1, L1-W04-C6-B2 has nothing under it; L1-W04-C1-B1, L1-W04-C6-B2 has nothing under it

PLACEMENT CHECKLIST tick each form as it is placed - bottom layer first

LAYER 5 - L1 courses 1, 2, 3, 6 (continued)

Pieces without a detail here: see the placement checklist (1)

Plan view, top layer first - build from the bottom up

# Stack B05 FULL-1 - 6in XR35 straights

## 25 blanks, 25 pieces | 5 layers | L1 courses 1-6 | stack height 1293 mm of 1300 mm cap

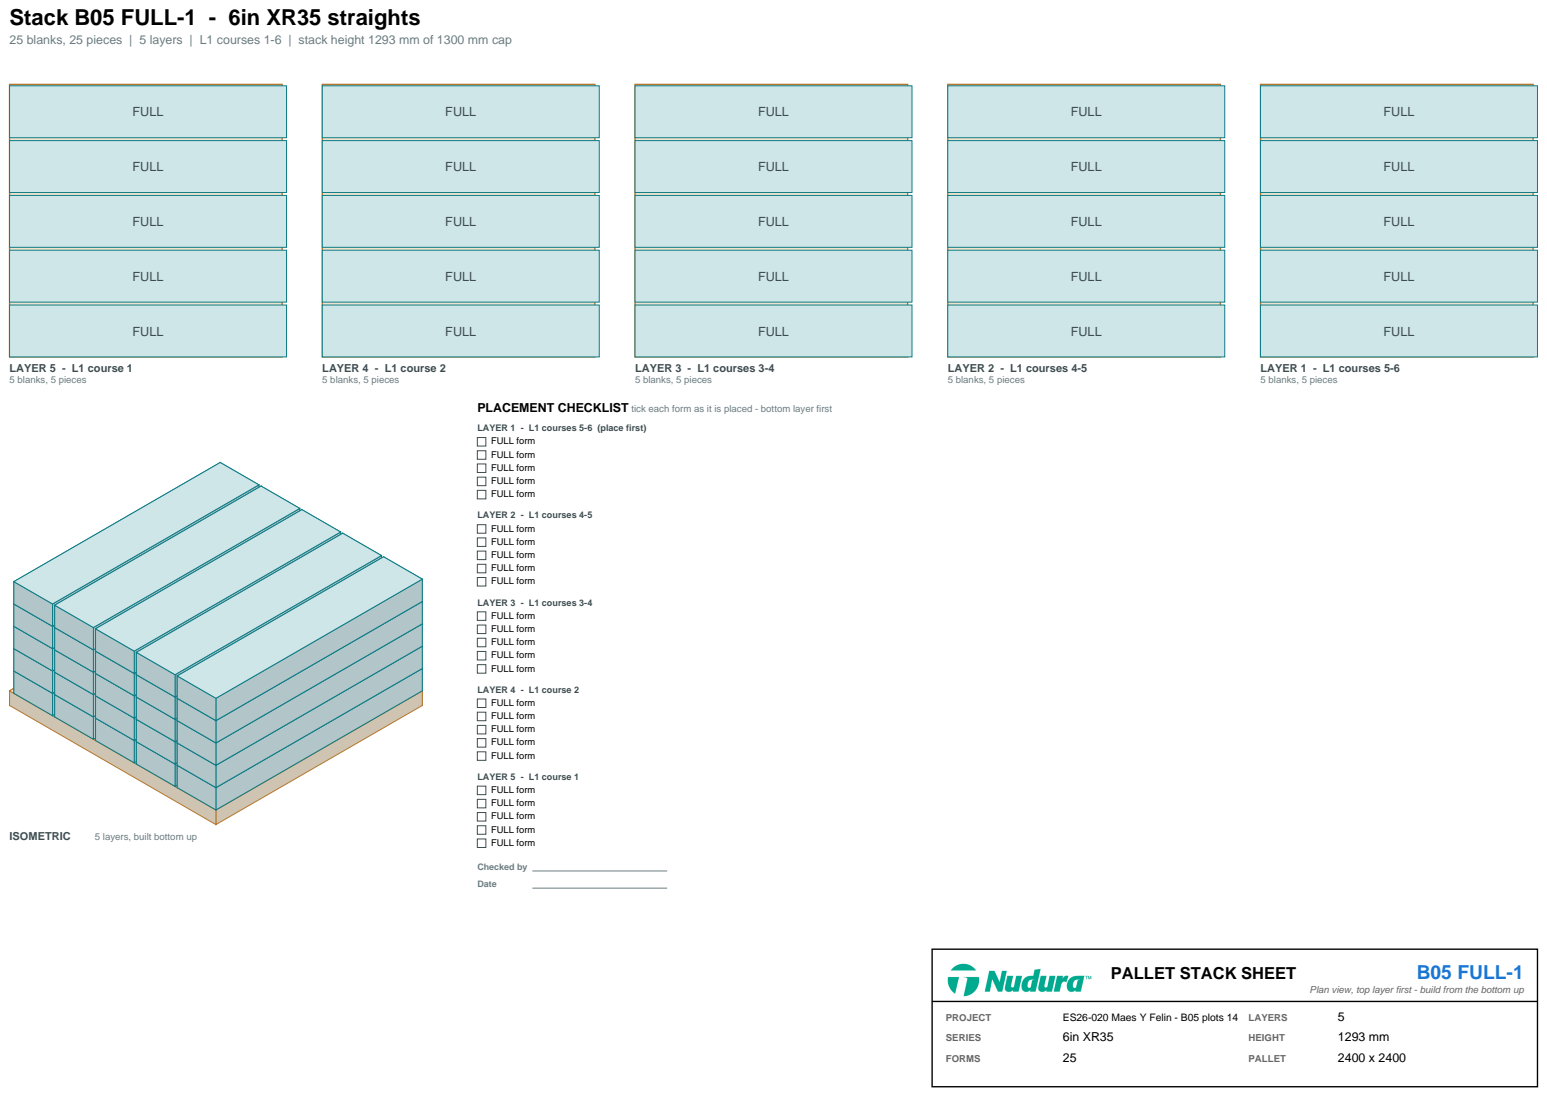
[picture p90: page 5]
FULL; LAYER 5 - L1 course 1 5 blanks, 5 pieces; LAYER 4 - L1 course 2 5 blanks, 5 pieces; LAYER 3 - L1 courses 3-4 5 blanks, 5 pieces; LAYER 2 - L1 courses 4-5 5 blanks, 5 pieces; LAYER 1 - L1 courses 5-6 5 blanks, 5 pieces; ISOMETRIC; 5 layers, built bottom up; LAYER 2 - L1 courses 4-5 FULL form FULL form FULL form FULL form FULL form; LAYER 3 - L1 courses 3-4 FULL form FULL form FULL form FULL form FULL form; LAYER 4 - L1 course 2 FULL form FULL form FULL form FULL form FULL form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

PLACEMENT CHECKLIST tick each form as it is placed - bottom layer first

LAYER 1 - L1 courses 5-6 (place first)
FULL form

Plan view, top layer first - build from the bottom up

# Stack B05 CUT-3 - 6in XR35 straights

## 10 blanks, 16 pieces | 3 layers | L1 courses 4-6 | stack height 836 mm of 1300 mm cap

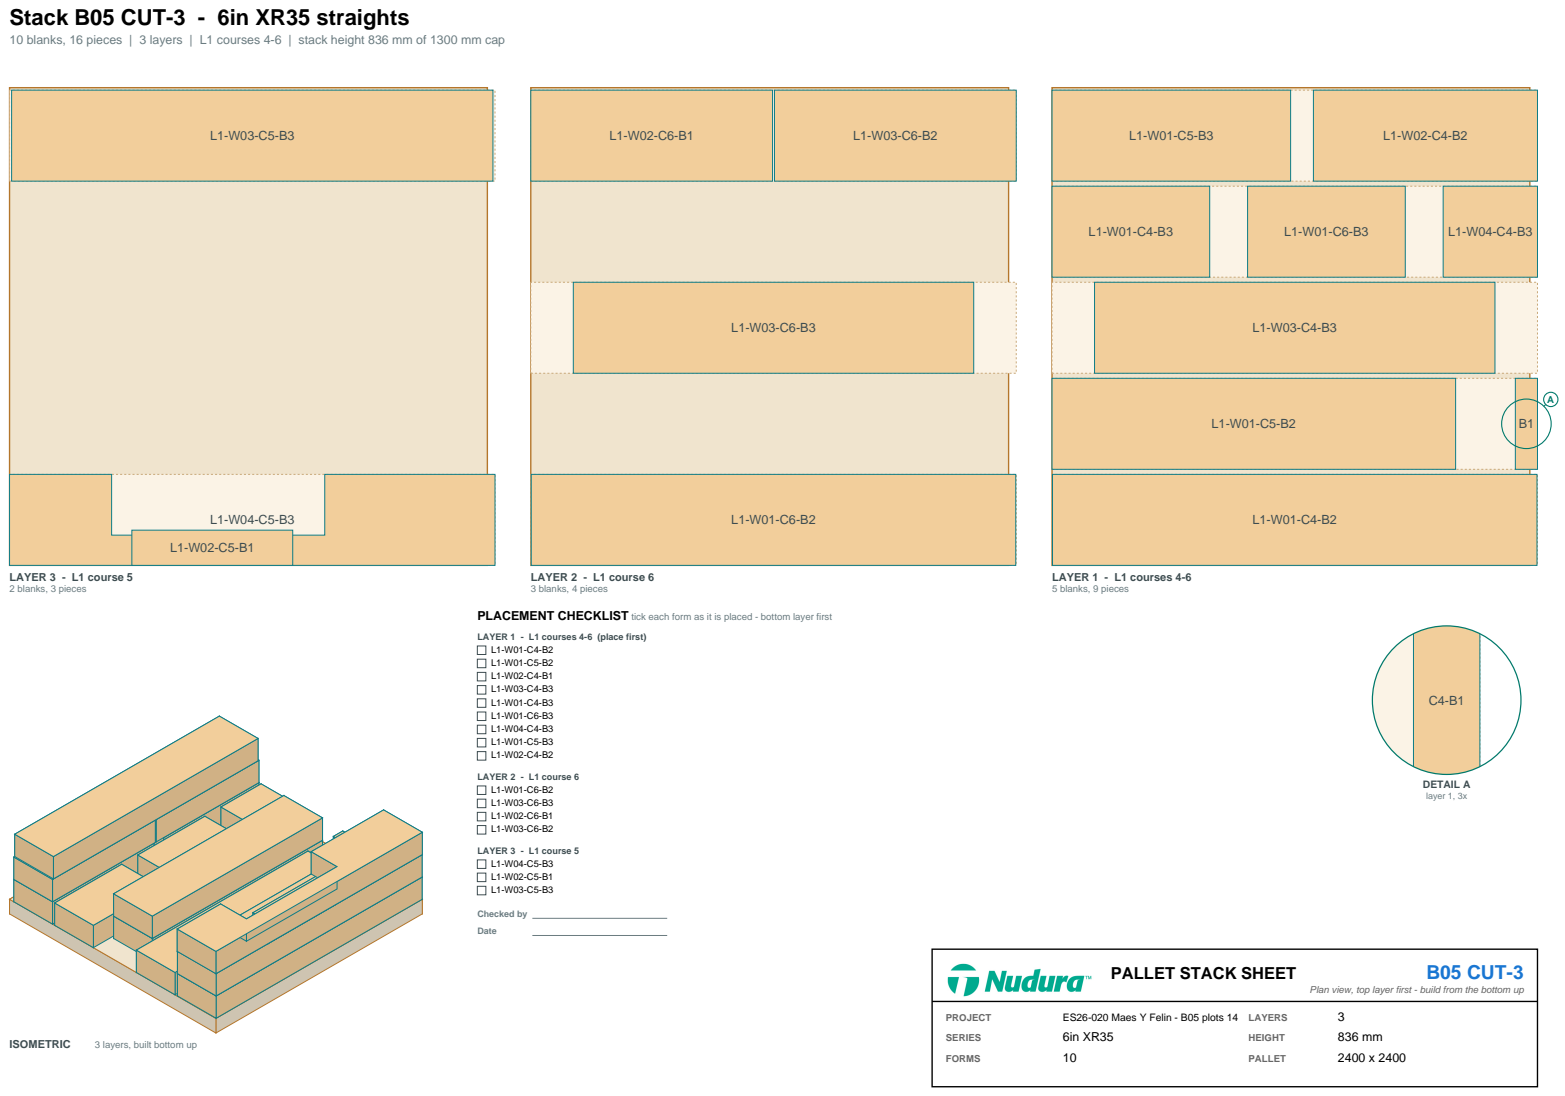
[picture p91: page 6]
LAYER 3 - L1 course 5 2 blanks, 3 pieces; LAYER 2 - L1 course 6 3 blanks, 4 pieces; LAYER 1 - L1 courses 4-6 5 blanks, 9 pieces; ISOMETRIC; 3 layers, built bottom up; DETAIL A layer 1, 3x; LAYER 1 - L1 courses 4-6 (place first) L1-W01-C4-B2 L1-W01-C5-B2 L1-W02-C4-B1 L1-W03-C4-B3 L1-W01-C4-B3 L1-W01-C6-B3 L1-W04-C4-B3 L1-W01-C5-B3 L1-W02-C4-B2; LAYER 2 - L1 course 6 L1-W01-C6-B2 L1-W03-C6-B3 L1-W02-C6-B1 L1-W03-C6-B2; LAYER 3 - L1 course 5 L1-W04-C5-B3 L1-W02-C5-B1 L1-W03-C5-B3; Checked by; Date

PLACEMENT CHECKLIST tick each form as it is placed - bottom layer first

PALLET STACK SHEET B05 CUT-3 Plan view, top layer first - build from the bottom up

PROJECT ES26-020 Maes Y Felin - B05 plots 14 LAYERS 3 HEIGHT 836 mm FORMS 10

# Stack B05 CNR-3 - 6in XR35 corners

20 blanks, 20 pieces | 2 layers | L2 courses 1-5 | stack height 1064 mm of 1300 mm cap FULL | FULL

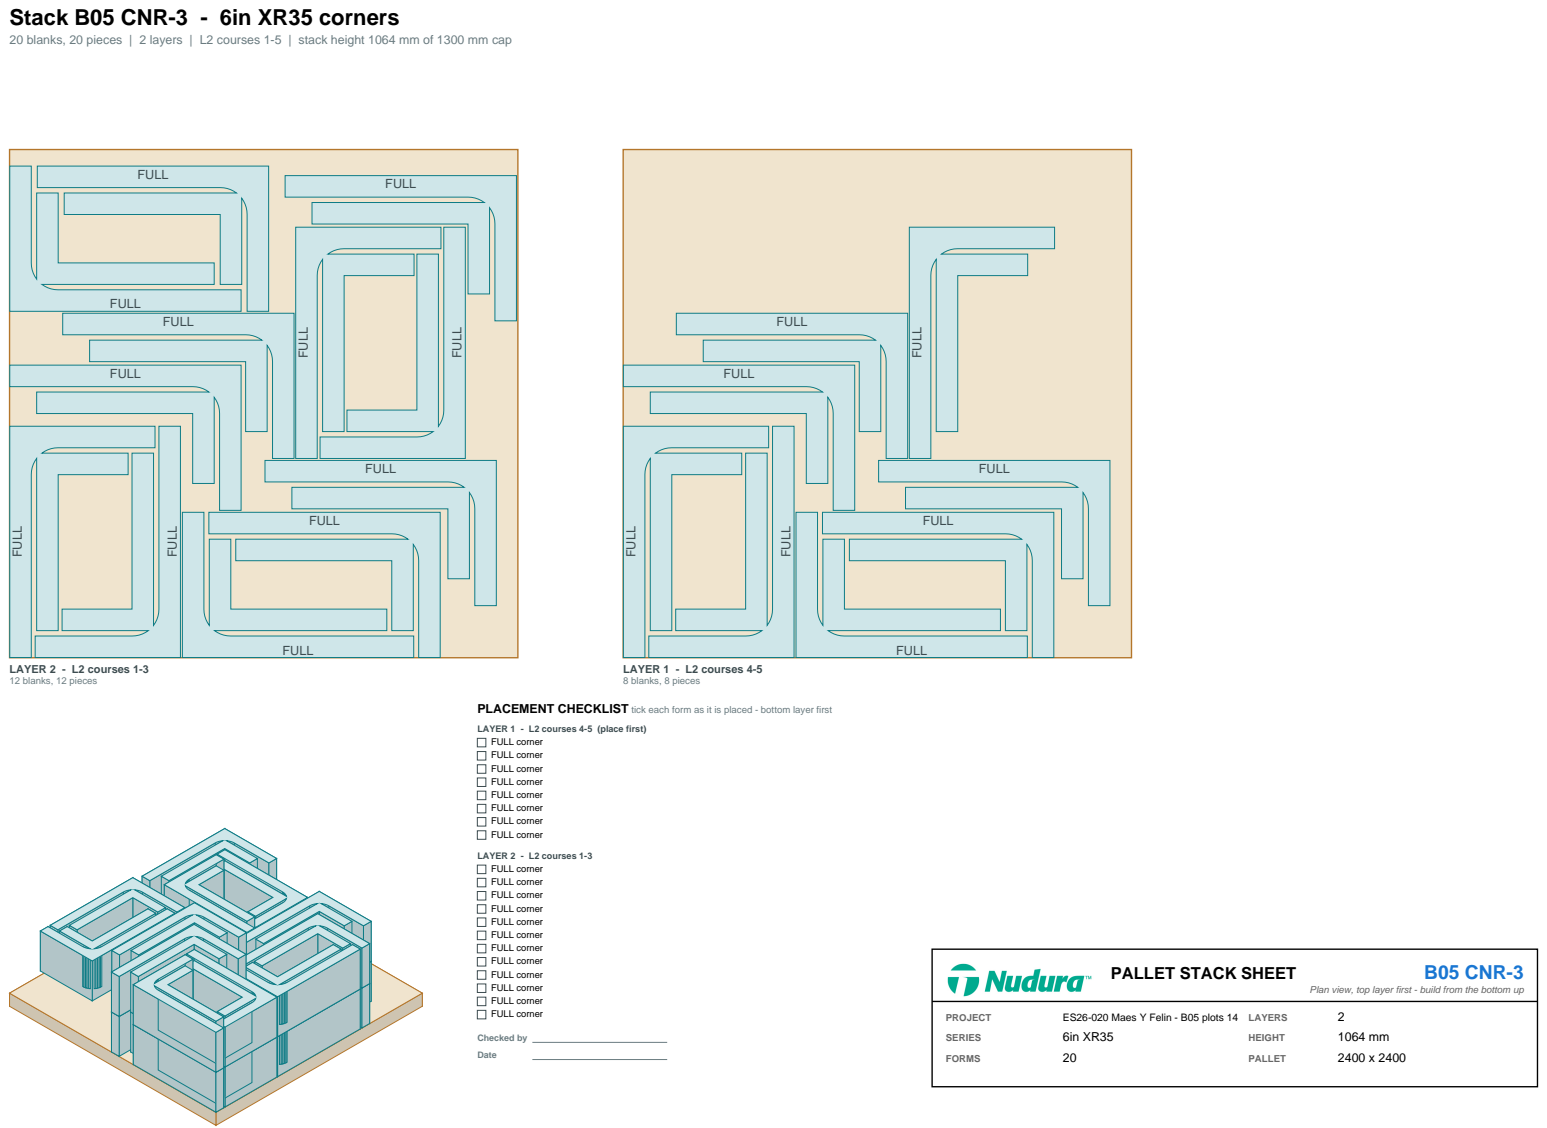
[picture p92: page 7]
FULL; LAYER 2 - L2 courses 1-3 12 blanks, 12 pieces; LAYER 1 - L2 courses 4-5 8 blanks, 8 pieces; LAYER 2 - L2 courses 1-3 FULL corner FULL corner FULL corner FULL corner FULL corner FULL corner FULL corner FULL corner FULL corner FULL corner FULL corner FULL corner; Checked by; Date; PALLET STACK SHEET; B05 CNR-3; PROJECT; ES26-020 Maes Y Felin - B05 plots 14; FORMS; LAYERS; HEIGHT

PLACEMENT CHECKLIST tick each form as it is placed - bottom layer first

LAYER 1 - L2 courses 4-5 (place first)
FULL corner

Plan view, top layer first - build from the bottom up

# Stack B05 FULL-2 - 6in XR35 straights

## 25 blanks, 25 pieces | 5 layers | L2 courses 1-6 | stack height 1293 mm of 1300 mm cap

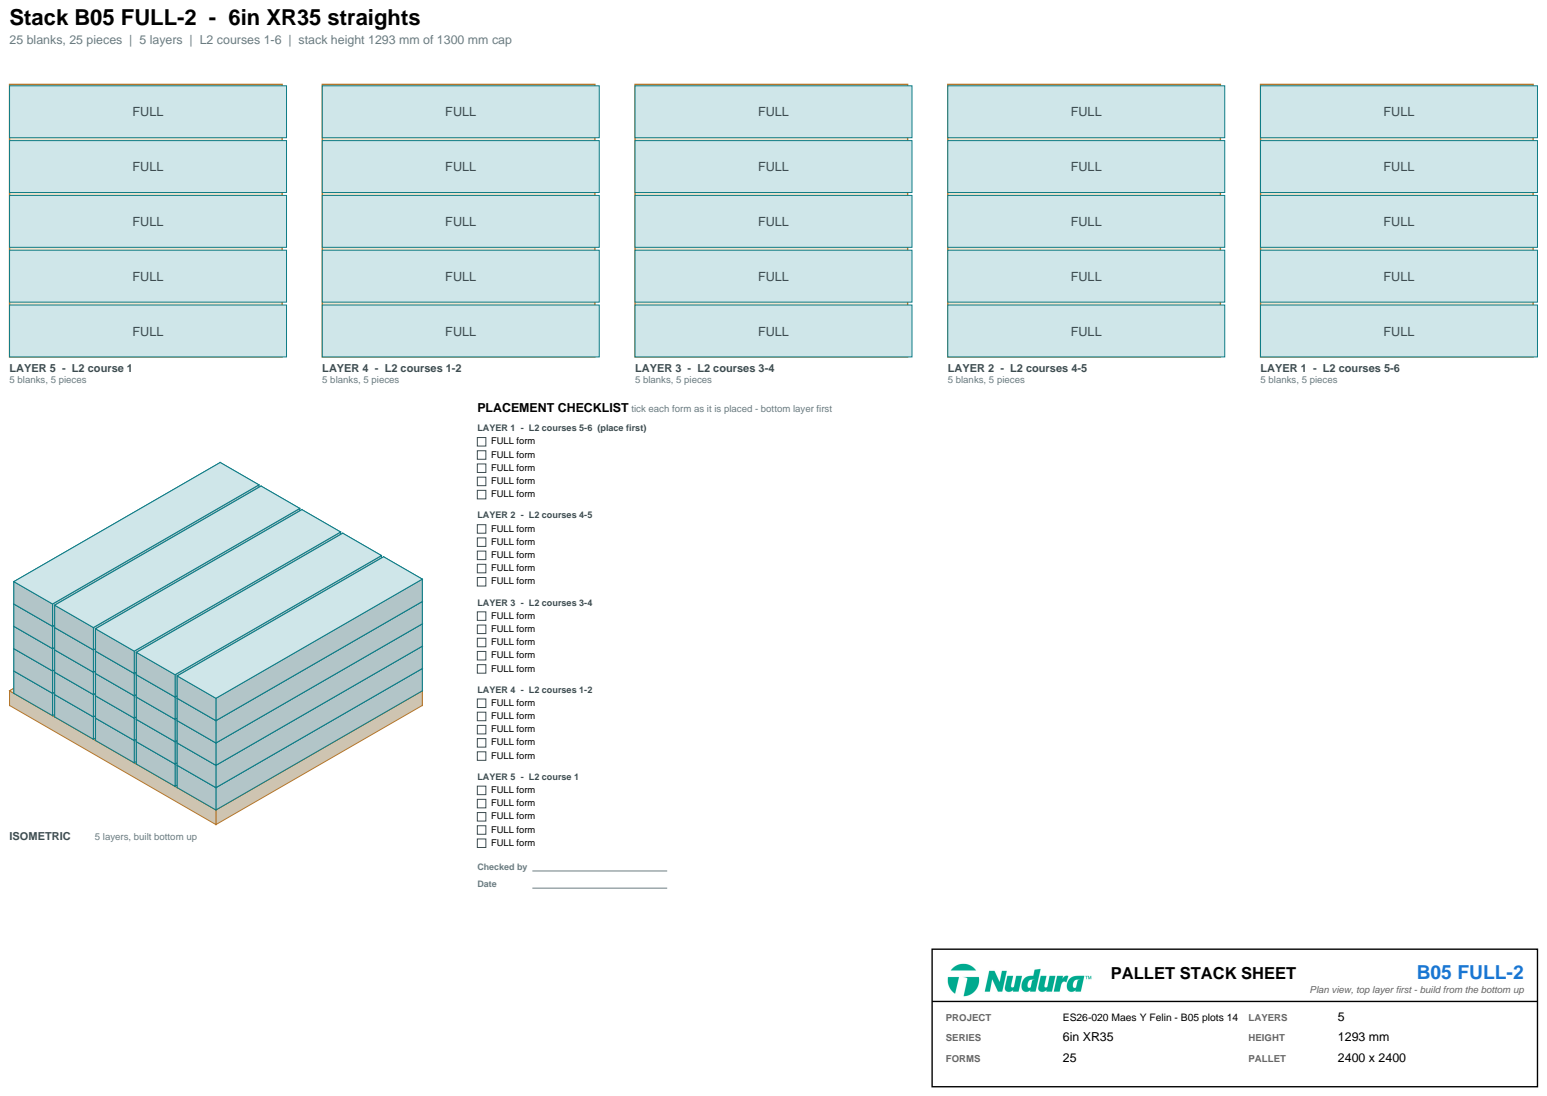
[picture p93: page 8]
FULL; LAYER 5 - L2 course 1 5 blanks, 5 pieces; LAYER 4 - L2 courses 1-2 5 blanks, 5 pieces; LAYER 3 - L2 courses 3-4 5 blanks, 5 pieces; LAYER 2 - L2 courses 4-5 5 blanks, 5 pieces; LAYER 1 - L2 courses 5-6 5 blanks, 5 pieces; ISOMETRIC; 5 layers, built bottom up; LAYER 2 - L2 courses 4-5 FULL form FULL form FULL form FULL form FULL form; LAYER 3 - L2 courses 3-4 FULL form FULL form FULL form FULL form FULL form; LAYER 4 - L2 courses 1-2 FULL form FULL form FULL form FULL form FULL form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

PLACEMENT CHECKLIST tick each form as it is placed - bottom layer first

LAYER 1 - L2 courses 5-6 (place first)
FULL form

Plan view, top layer first - build from the bottom up

# Stack B05 CUT-4 - 6in XR35 straights

23 blanks, 43 pieces | 5 layers | L2 courses 1, 2, 3, 4, 6, 7, 8, 11, 12 | stack height 1293 mm of 1300 mm cap

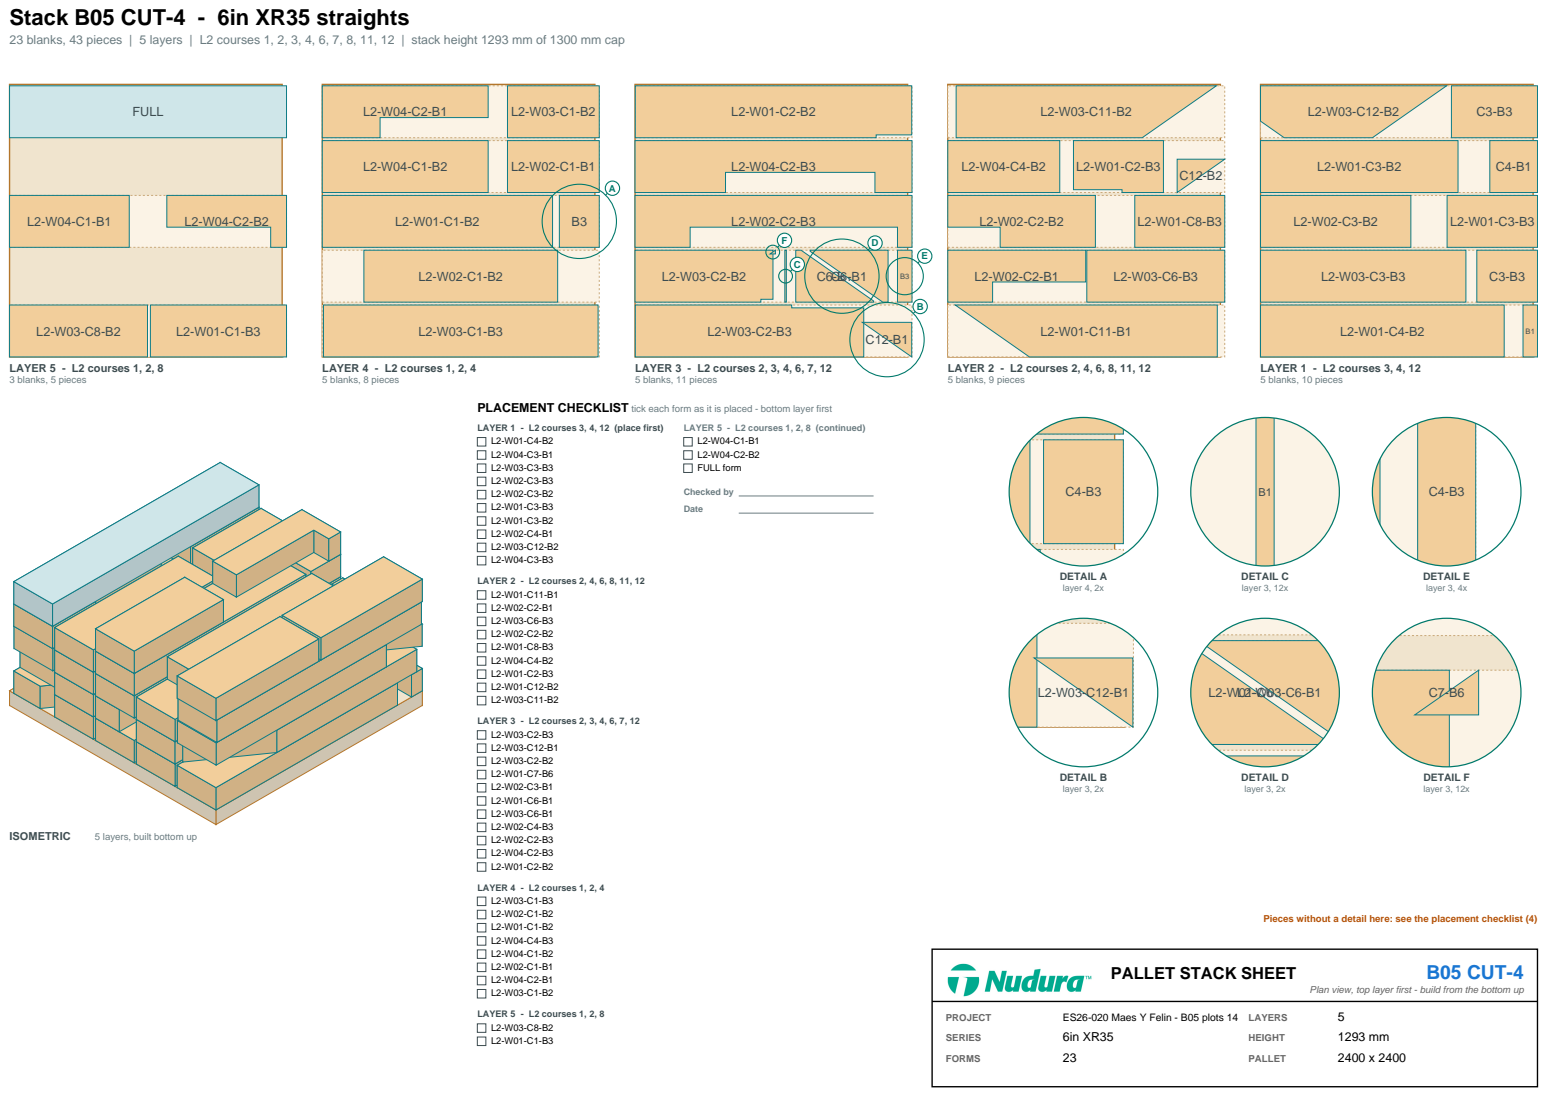
[picture p94: page 9]
FULL; LAYER 5 - L2 courses 1, 2, 8 3 blanks, 5 pieces; LAYER 4 - L2 courses 1, 2, 4 5 blanks, 8 pieces; LAYER 3 - L2 courses 2, 3, 4, 6, 7, 12 5 blanks, 11 pieces; LAYER 2 - L2 courses 2, 4, 6, 8, 11, 12 5 blanks, 9 pieces; LAYER 1 - L2 courses 3, 4, 12 5 blanks, 10 pieces; ISOMETRIC; 5 layers, built bottom up; DETAIL A layer 4, 2x; DETAIL B layer 3, 2x; DETAIL C layer 3, 12x; DETAIL D layer 3, 2x; DETAIL E layer 3, 4x; DETAIL F layer 3, 12x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

PLACEMENT CHECKLIST tick each form as it is placed - bottom layer first

Pieces without a detail here: see the placement checklist (4)

Plan view, top layer first - build from the bottom up

# Stack B05 CUT-5 - 6in XR35 straights

19 blanks, 33 pieces | 5 layers | L2 courses 3, 4, 5, 6, 7, 9, 10 | stack height 1293 mm of 1300 mm cap

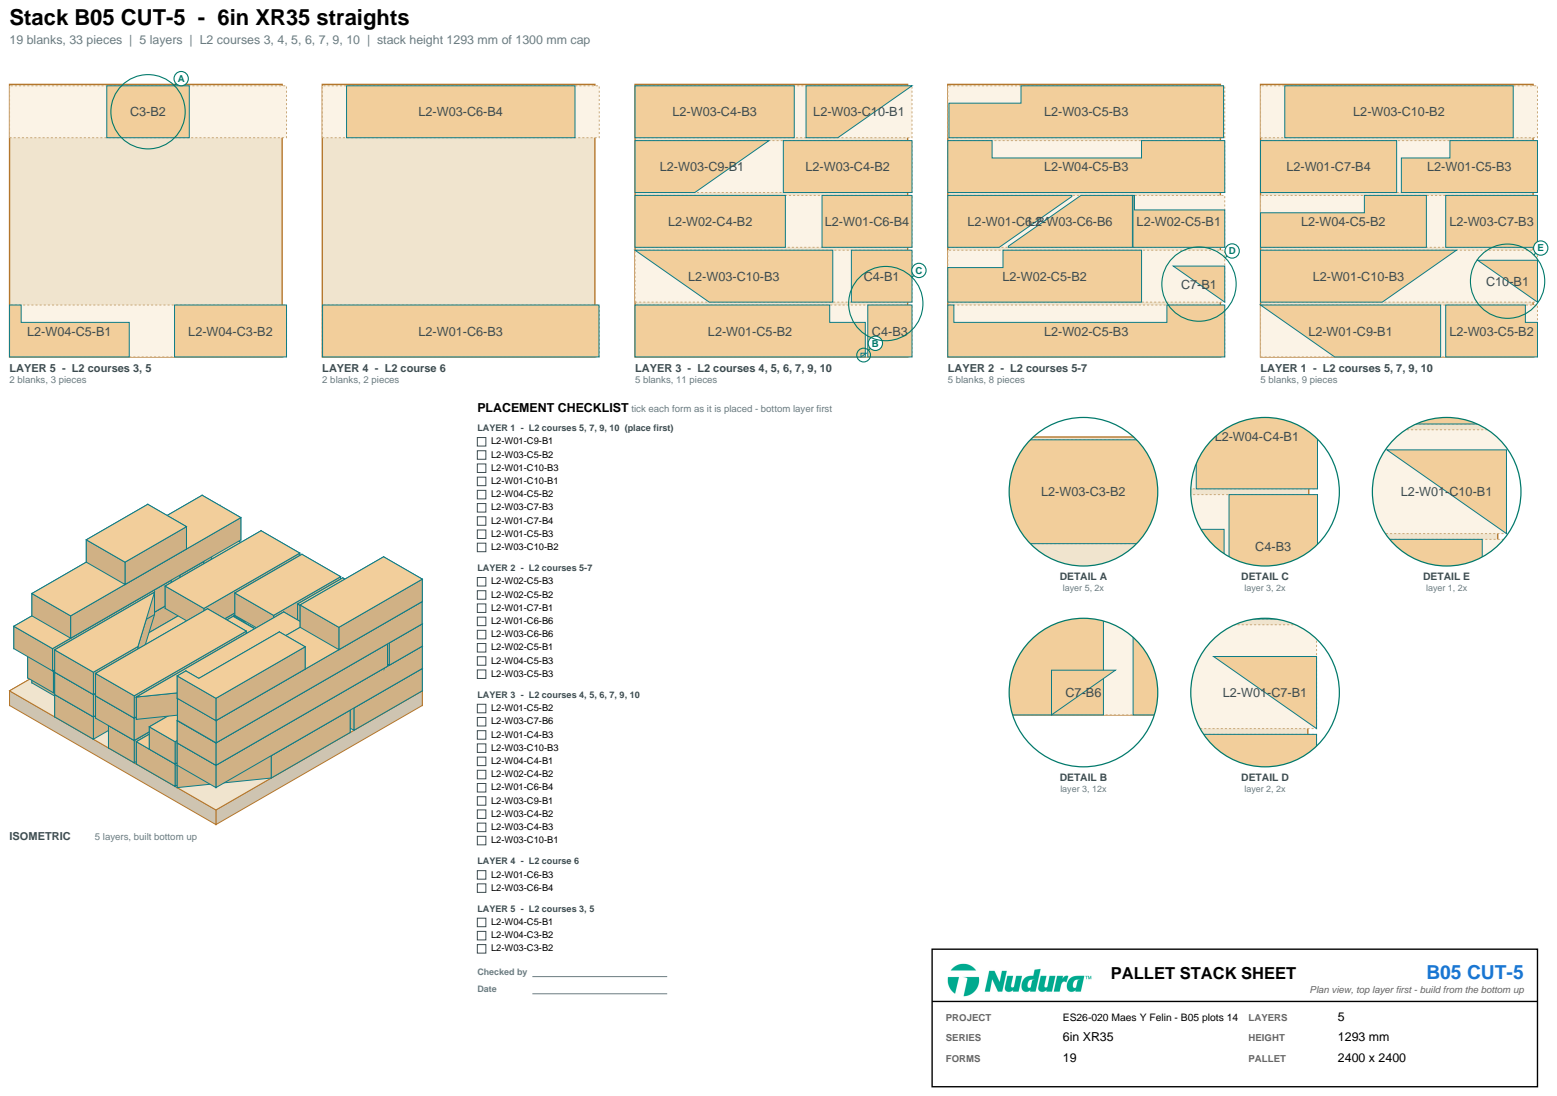
[picture p95: page 10]
LAYER 5 - L2 courses 3, 5 2 blanks, 3 pieces; LAYER 4 - L2 course 6 2 blanks, 2 pieces; LAYER 3 - L2 courses 4, 5, 6, 7, 9, 10 5 blanks, 11 pieces; LAYER 2 - L2 courses 5-7 5 blanks, 8 pieces; LAYER 1; - L2 courses 5, 7, 9, 10; 5 blanks, 9 pieces; ISOMETRIC; 5 layers, built bottom up; DETAIL A layer 5, 2x; DETAIL B layer 3, 12x; DETAIL C layer 3, 2x; DETAIL D layer 2, 2x; DETAIL E layer 1, 2x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

PLACEMENT CHECKLIST tick each form as it is placed - bottom layer first

Plan view, top layer first - build from the bottom up

# Stack B05 CUT-6 - 6in XR35 straights

## 19 blanks, 21 pieces | 5 layers | L2 courses 7-12 | stack height 1293 mm of 1300 mm cap

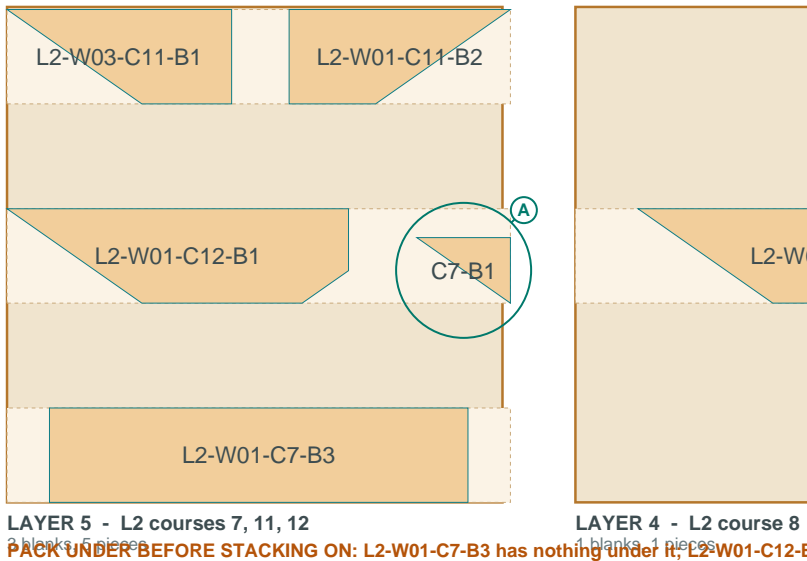
[picture p96: figure]
LAYER 5 - L2 courses 7, 11, 12 3 blanks, 5 pieces; LAYER 4 - L2 course 8 1 blanks, 1 pieces

## L2-W03-C8-B1

## L2-W01-C7-B2

## L2-W01-C7-B5

## L2-W03-C7-B2

## L2-W03-C7-B5

## L2-W03-C7-B4

### LAYER 3 - L2 course 7

5 blanks, 5 pieces

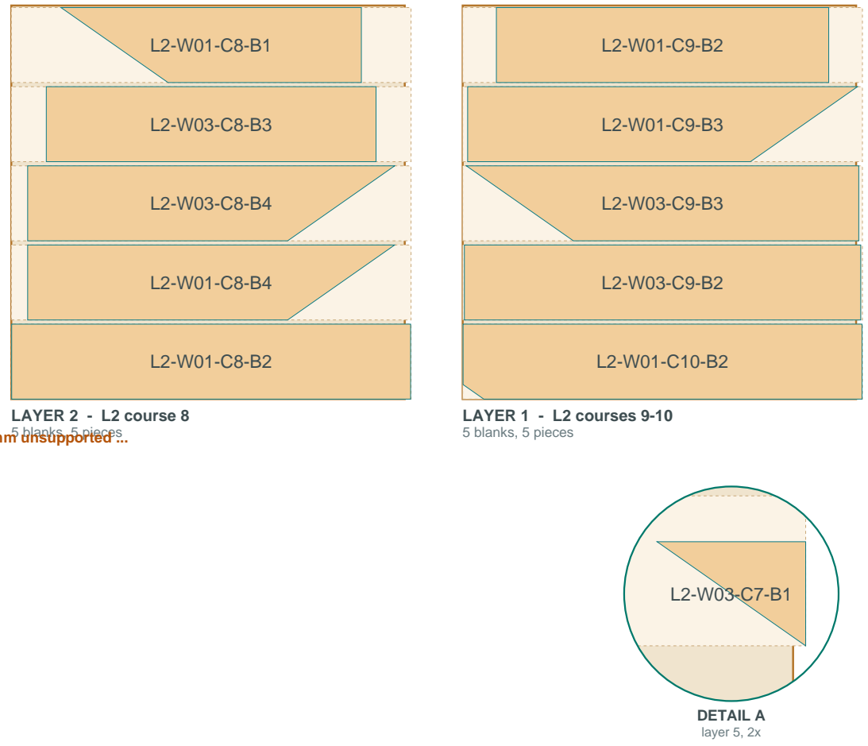
[picture p97: figure]
LAYER 2 - L2 course 8 5 blanks, 5 pieces; LAYER 1 - L2 courses 9-10 5 blanks, 5 pieces; DETAIL A layer 5, 2x

PACK UNDER BEFORE STACKING ON: L2-W01-C7-B3 has nothing under it; L2-W01-C12-B1, L2-W03-C7-B1 overhangs 303 mm unsupported; L2-W01-C12-B1, L2-W03-C7-B1 overhangs 303 mm unsupported ...

PLACEMENT CHECKLIST tick each form as it is placed - bottom layer first

LAYER 1 - L2 courses 9-10 (place first)
L2-W01-C10-B2
L2-W03-C9-B2
L2-W03-C9-B3
L2-W01-C9-B3
L2-W01-C9-B2

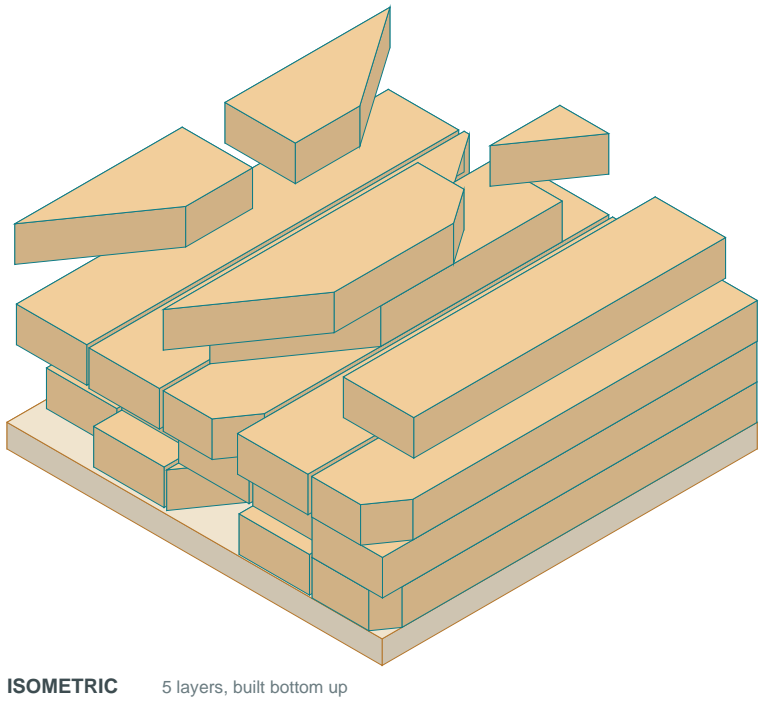
[picture p98: figure]
ISOMETRIC; 5 layers, built bottom up

LAYER 2 - L2 course 8
L2-W01-C8-B2
L2-W01-C8-B4
L2-W03-C8-B4
L2-W03-C8-B3
L2-W01-C8-B1

LAYER 3 - L2 course 7
L2-W01-C7-B2
L2-W01-C7-B5
L2-W03-C7-B2
L2-W03-C7-B5
L2-W03-C7-B4

LAYER 4 - L2 course 8
L2-W03-C8-B1

LAYER 5 - L2 courses 7, 11, 12 L2-W01-C7-B3
L2-W01-C12-B1
L2-W03-C7-B1
L2-W03-C11-B1
L2-W01-C11-B2

Checked by
Date
PALLET STACK SHEET | B05 CUT-6

Plan view, top layer first - build from the bottom up

PROJECT | ES26-020 Maes Y Felin - B05 plots 14
FORMS | 19
LAYERS | 5

# Stack B05 ACCESSORIES - accessory spot

B05 plots 14 | ONE floor spot reserved on the wagon for the whole block's accessories | 2 rigid

# ACCESSORIES

## B05 - plots 14

### 2400 x 2400 floor spot

### Load at the TAIL of vehicle 1 - first off

## Contents (from the take-off, all levels of the block)

Item | SKU | Qty | Bundles | Levels
Form-Lock (6in XR35) | NUS-ABLOK-06 | 45 | 7 | FB, L1, L2
Spray Foam Cans | NUS-SF-BOX | 15 | 3 | FB, L1, L2
Vertical Joint Clips | NUS-A0VJC-00 | 638 | 4 | L1, L2

Accessories cannot be sized accurately yet, so the block's accessories take one floor spot.
Openings close with 47 x 150 timber closers (Beech) - supply TBC, not in this spot (RFI-23).
PALLET STACK SHEET | B05 ACC

Accessory spot - one per block

PROJECT | ES26-020 Maes Y Felin - B05 plots 14
BLOCK | B05 plots 14
ITEMS | 3
SPOT | 1 floor spot
VEHICLE | 2 rigid
