BuildEase2026/mf-icf-approval-1f4119fc49/3B4P/docs/details/ES26-020-3B4P-DT-01 Opening Details - Jamb, Head and Cill.pdf

## FOR APPROVAL - NOT FOR CONSTRUCTION

## GA PLAN DETAIL - WINDOW JAMB (W03, both jambs handed)

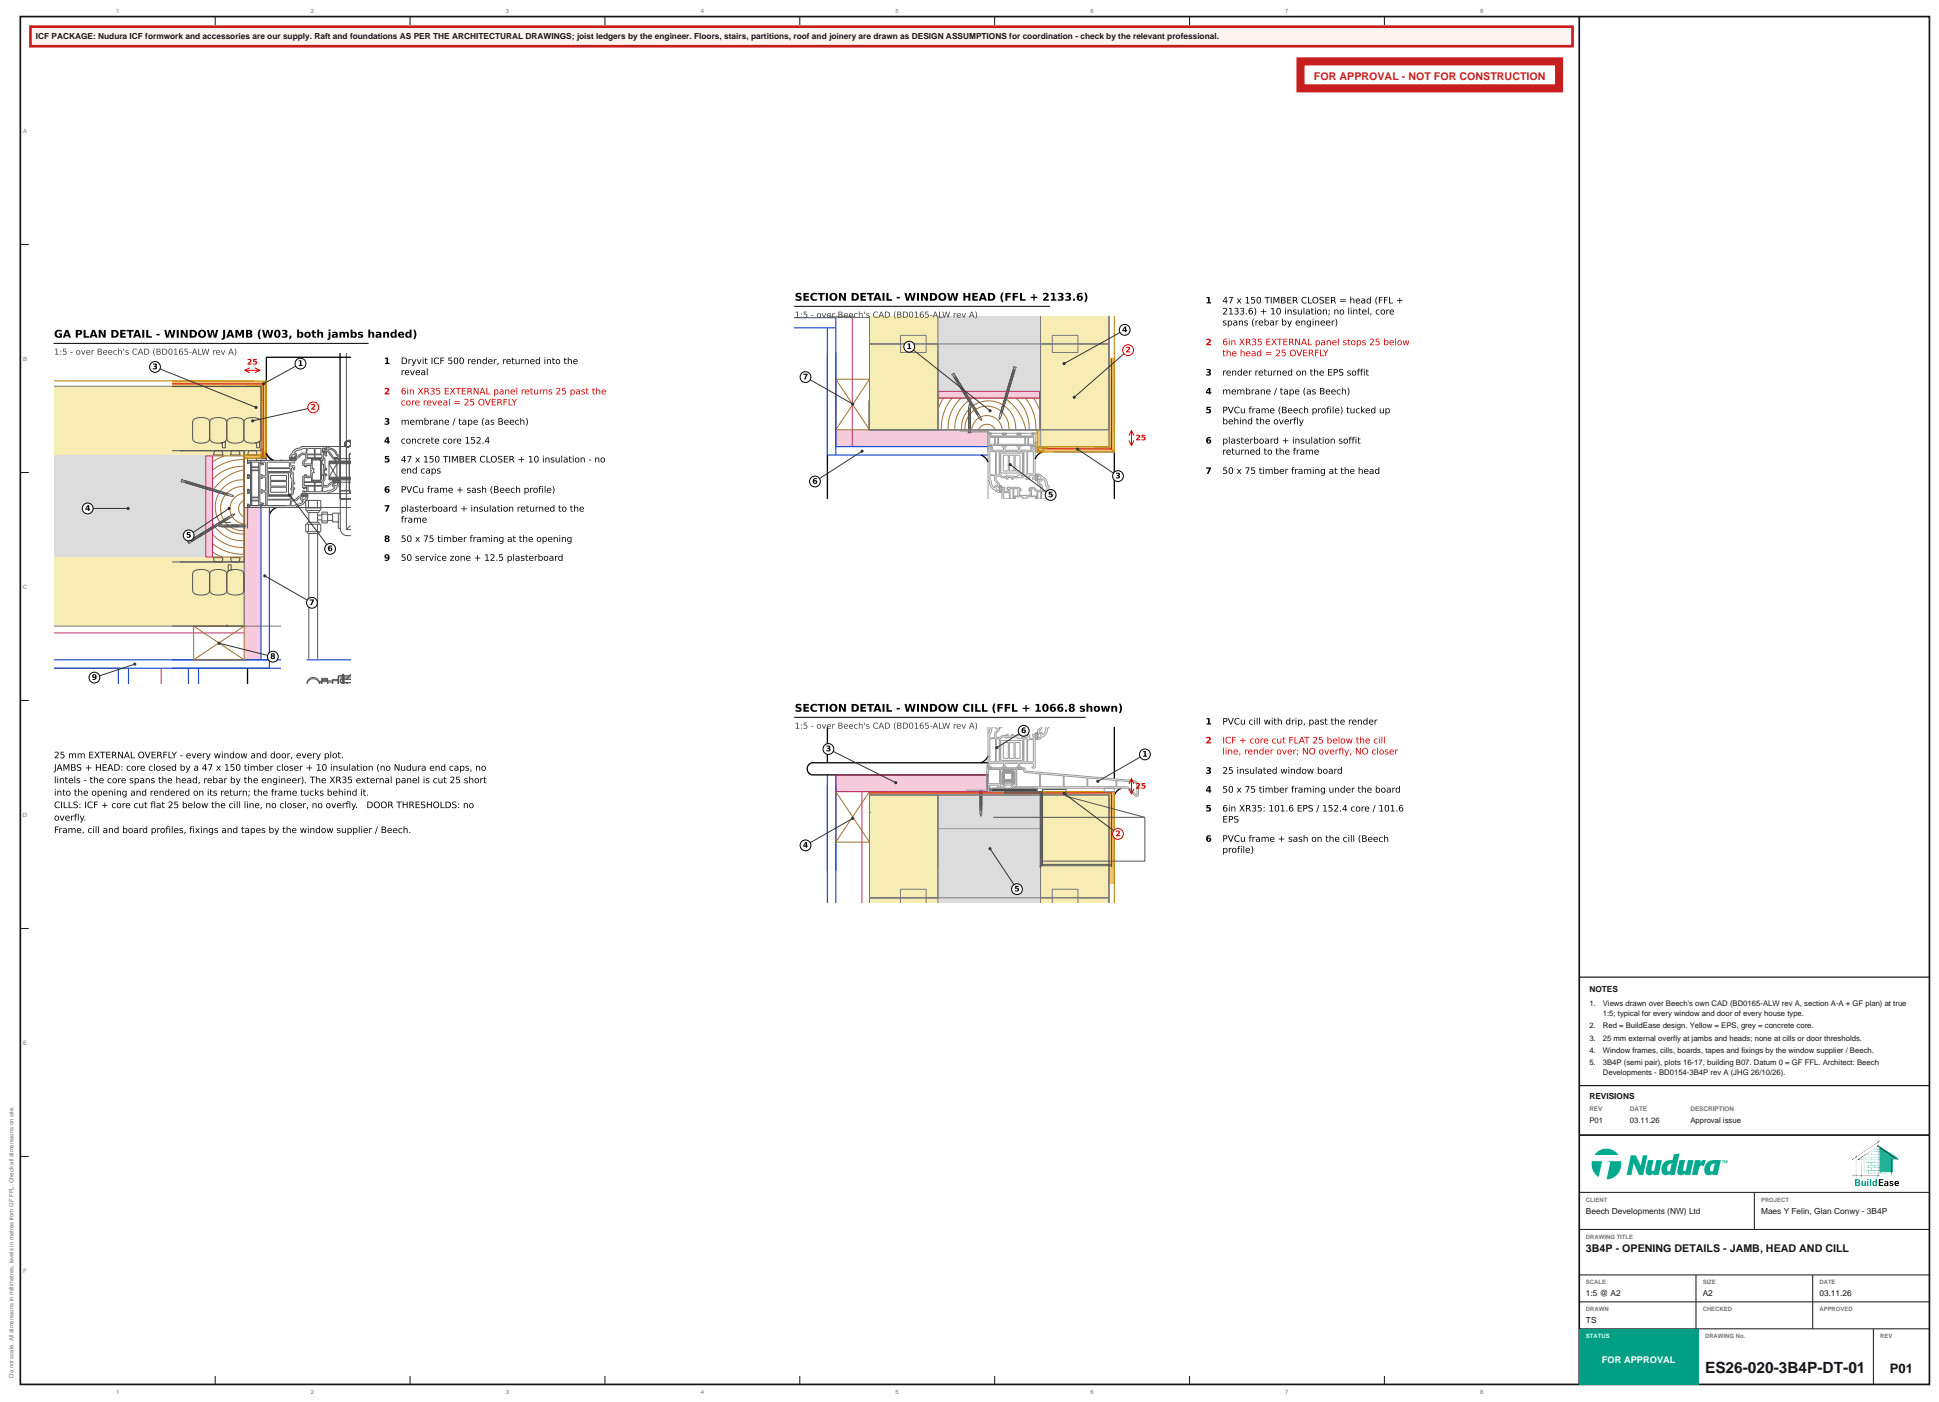
[picture p99: page 1]
REVISIONS; REV; DATE; DESCRIPTION; Approval issue; SCALE 1:5 @ A2; SIZE A2; DATE 03.11.26; DRAWN TS; CHECKED; APPROVED; STATUS; FOR APPROVAL; DRAWING No. ES26-020-3B4P-DT-01; 4 concrete core 152.4; SECTION DETAIL - WINDOW HEAD (FFL +; 1:5 - over Beech's; CAD (BD0165-ALW rev A); SECTION DETAIL - WINDOW CILL; (FFL + 1066.8 shown); 5 6in XR35: 101.6 EPS / 152.4 core / 101.6 EPS; JAMBS + HEAD: core closed by a; 47 x 150 timber closer + 10 insulation (no Nudura end caps, no; lintels - the core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

1 47 x 150 TIMBER CLOSER = head (FFL +
2133.6) + 10 insulation; no lintel, core
spans (rebar by engineer)

2 6in XR35 EXTERNAL panel stops 25 below
the head = 25 OVERFLY

1:5 - over Beech's CAD (BD0165-ALW rev A)

1 Dryvit ICF 500 render, returned into the
reveal

3 render returned on the EPS soffit

2 6in XR35 EXTERNAL panel returns 25 past the
core reveal = 25 OVERFLY

4 membrane / tape (as Beech)

5 PVCu frame (Beech profile) tucked up
behind the overfly

3 membrane / tape (as Beech)

6 plasterboard + insulation soffit
returned to the frame

5 47 x 150 TIMBER CLOSER + 10 insulation - no
end caps

7 50 x 75 timber framing at the head

6 PVCu frame + sash (Beech profile)

7 plasterboard + insulation returned to the
frame

8 50 x 75 timber framing at the opening

9 50 service zone + 12.5 plasterboard

1 PVCu cill with drip, past the render

2 ICF + core cut FLAT 25 below the cill
line, render over; NO overfly, NO closer

25 mm EXTERNAL OVERFLY - every window and door, every plot.
CILLS: ICF + core cut flat 25 below the cill line, no closer, no overfly. DOOR THRESHOLDS: no
overfly.

3 25 insulated window board

4 50 x 75 timber framing under the board

6 PVCu frame + sash on the cill (Beech
profile)

NOTES
1. Views drawn over Beech's own CAD (BD0165-ALW rev A, section A-A + GF plan) at true
1:5; typical for every window and door of every house type.
2. Red = BuildEase design. Yellow = EPS, grey = concrete core.
3. 25 mm external overfly at jambs and heads; none at cills or door thresholds.
4. Window frames, cills, boards, tapes and fixings by the window supplier / Beech.
5. 3B4P (semi pair), plots 16-17, building B07. Datum 0 = GF FFL. Architect: Beech
Developments - BD0154-3B4P rev A (JHG 26/10/26).

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

CLIENT
Beech Developments (NW) Ltd

PROJECT
Maes Y Felin, Glan Conwy - 3B4P

DRAWING TITLE
3B4P - OPENING DETAILS - JAMB, HEAD AND CILL
