BuildEase2026/mf-icf-approval-1f4119fc49/3B4P/docs/details/ES26-020-3B4P-DT-03 Eaves Detail - Wall Plate on the ICF Core.pdf

## FOR APPROVAL - NOT FOR CONSTRUCTION

## SECTION DETAIL - EAVES AND WALL PLATE

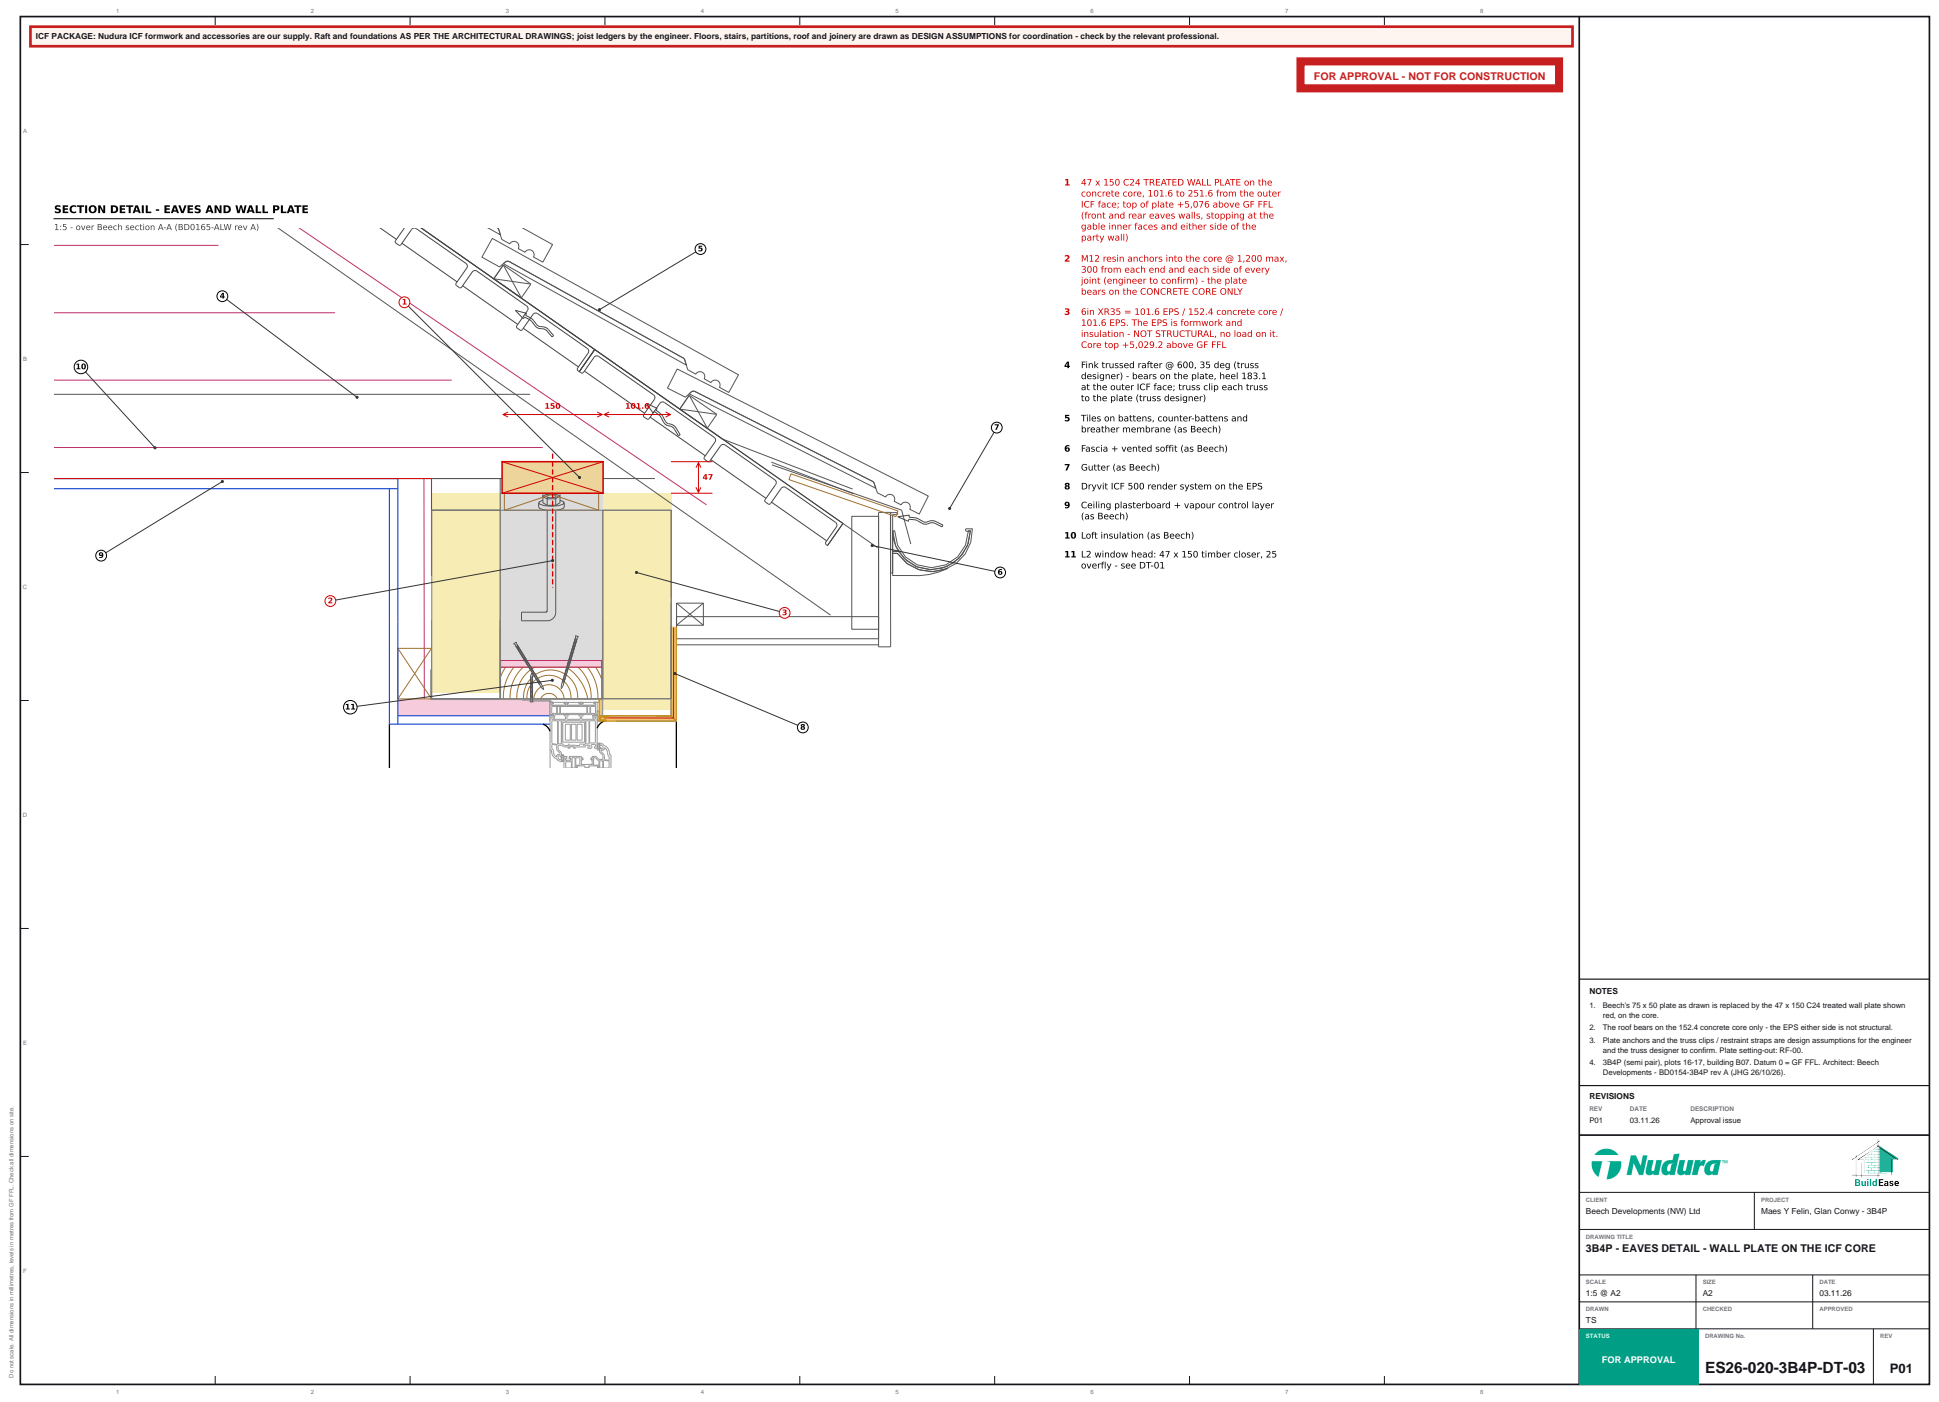
[picture p100: page 1]
REVISIONS; REV; DATE; DESCRIPTION; Approval issue; SCALE 1:5 @ A2; SIZE A2; DATE 03.11.26; DRAWN TS; CHECKED; APPROVED; STATUS; FOR APPROVAL; DRAWING No. ES26-020-3B4P-DT-03

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

1 47 x 150 C24 TREATED WALL PLATE on the
concrete core, 101.6 to 251.6 from the outer
ICF face; top of plate +5,076 above GF FFL
(front and rear eaves walls, stopping at the
gable inner faces and either side of the
party wall)

1:5 - over Beech section A-A (BD0165-ALW rev A)

2 M12 resin anchors into the core @ 1,200 max,
300 from each end and each side of every
joint (engineer to confirm) - the plate
bears on the CONCRETE CORE ONLY

3 6in XR35 = 101.6 EPS / 152.4 concrete core /
101.6 EPS. The EPS is formwork and
insulation - NOT STRUCTURAL, no load on it.
Core top +5,029.2 above GF FFL

4 Fink trussed rafter @ 600, 35 deg (truss
designer) - bears on the plate, heel 183.1
at the outer ICF face; truss clip each truss
to the plate (truss designer)

5 Tiles on battens, counter-battens and
breather membrane (as Beech)

6 Fascia + vented soffit (as Beech)

7 Gutter (as Beech)

8 Dryvit ICF 500 render system on the EPS

9 Ceiling plasterboard + vapour control layer
(as Beech)

10 Loft insulation (as Beech)

11 L2 window head: 47 x 150 timber closer, 25
overfly - see DT-01

NOTES
1. Beech's 75 x 50 plate as drawn is replaced by the 47 x 150 C24 treated wall plate shown
red, on the core.
2. The roof bears on the 152.4 concrete core only - the EPS either side is not structural.
3. Plate anchors and the truss clips / restraint straps are design assumptions for the engineer
and the truss designer to confirm. Plate setting-out: RF-00.
4. 3B4P (semi pair), plots 16-17, building B07. Datum 0 = GF FFL. Architect: Beech
Developments - BD0154-3B4P rev A (JHG 26/10/26).

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

CLIENT
Beech Developments (NW) Ltd

PROJECT
Maes Y Felin, Glan Conwy - 3B4P

DRAWING TITLE
3B4P - EAVES DETAIL - WALL PLATE ON THE ICF CORE
