BuildEase2026/mf-icf-approval-1f4119fc49/3B4P/docs/details/ES26-020-3B4P-DT-04 First Floor Detail - Top-Hung Joists at the ICF.pdf

## FOR APPROVAL - NOT FOR CONSTRUCTION

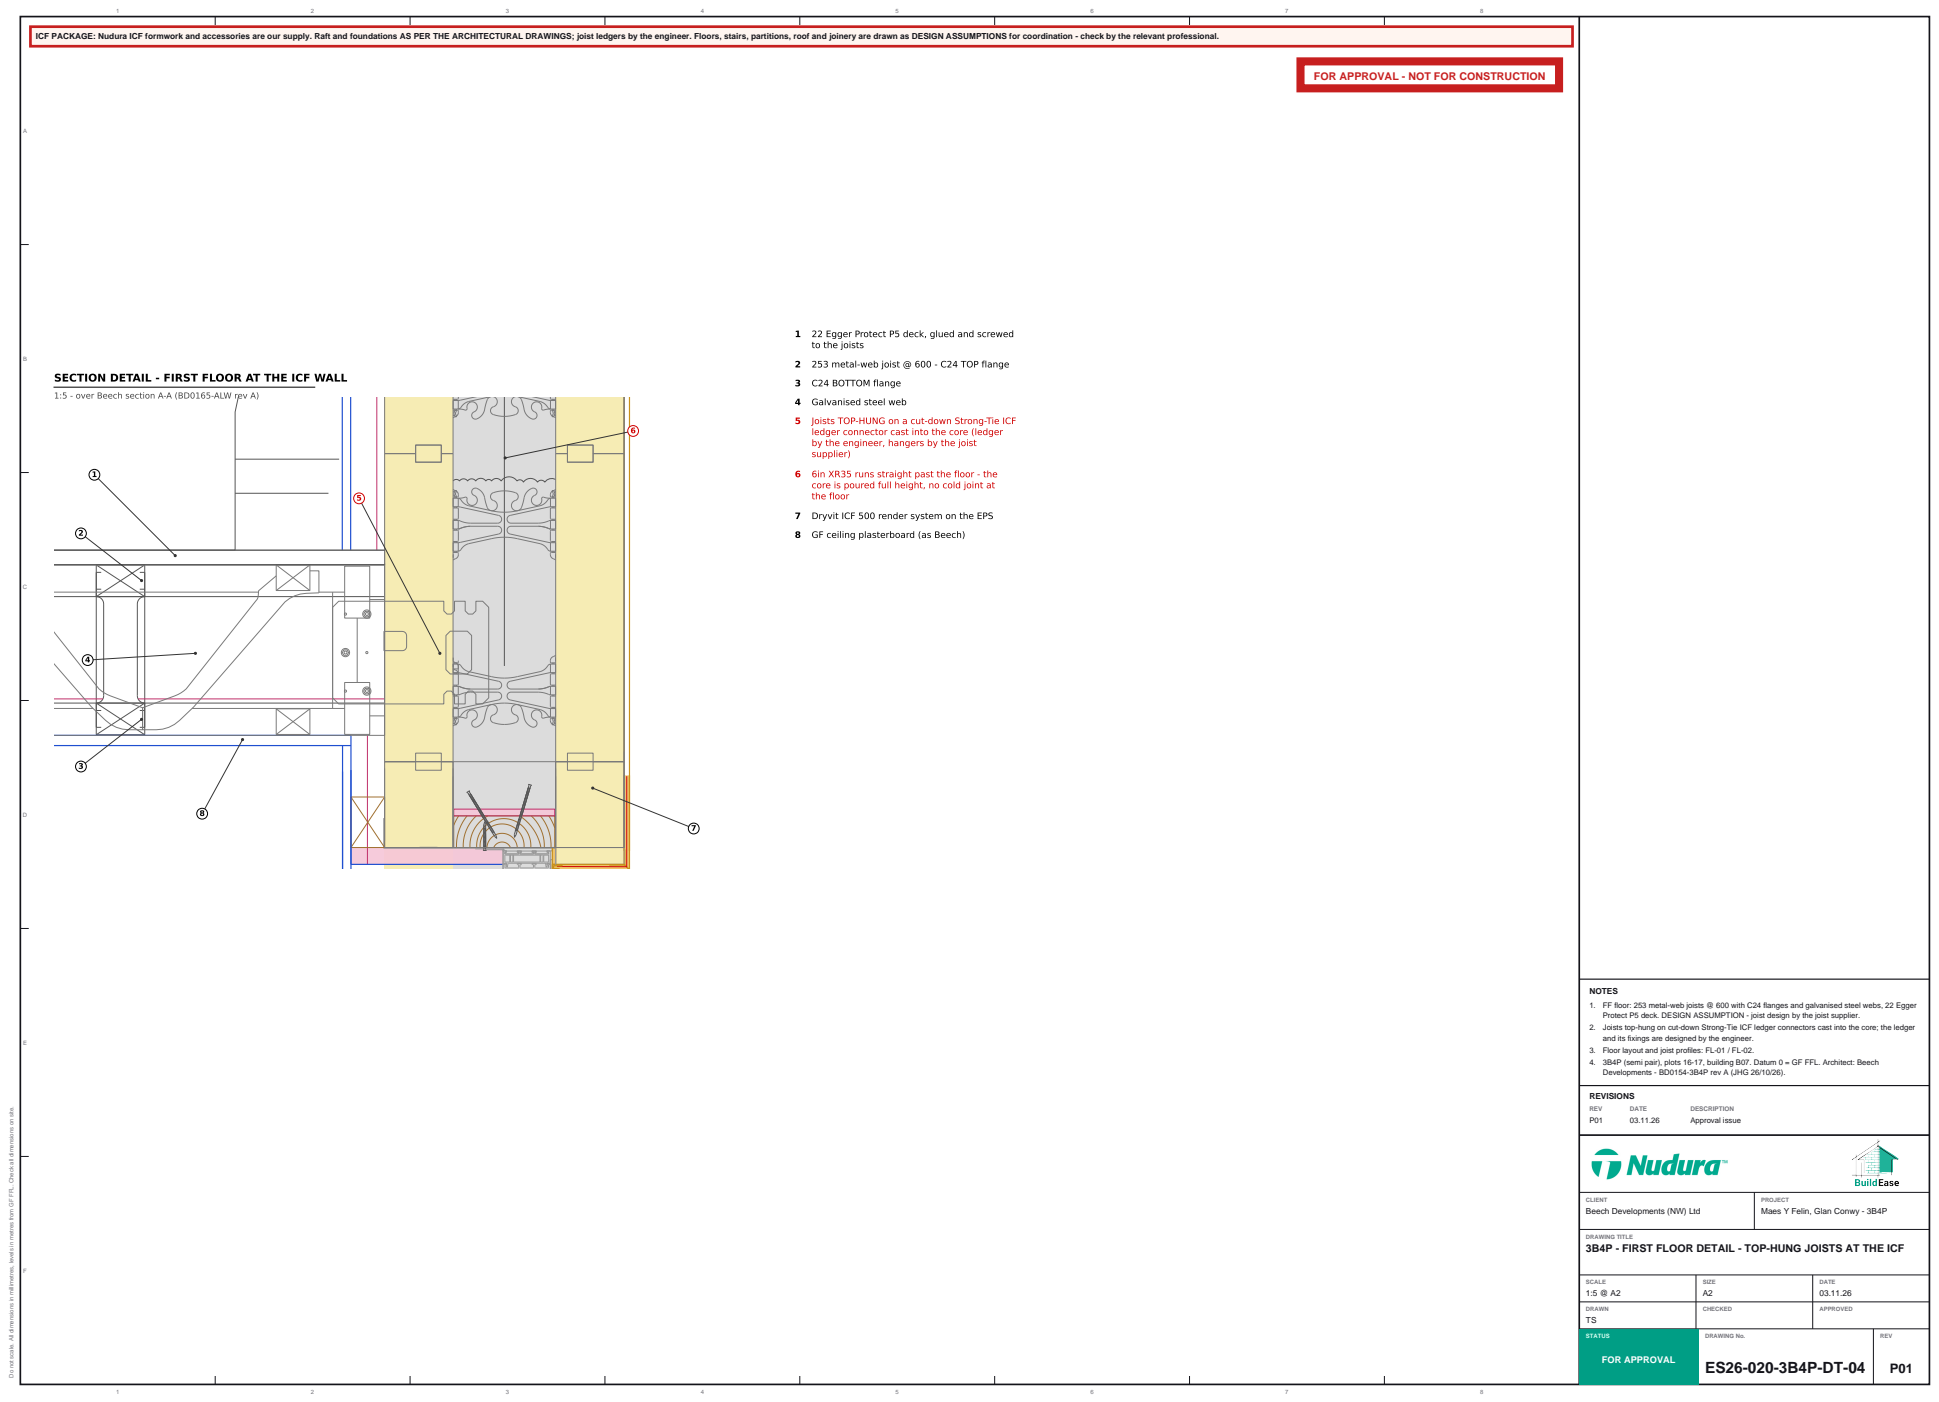
[picture p101: page 1]
REVISIONS; REV; DATE; DESCRIPTION; Approval issue; SCALE 1:5 @ A2; SIZE A2; DATE 03.11.26; DRAWN TS; CHECKED; APPROVED; STATUS; FOR APPROVAL; DRAWING No. ES26-020-3B4P-DT-04; 3 C24 BOTTOM flange

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

1 22 Egger Protect P5 deck, glued and screwed
to the joists

SECTION DETAIL - FIRST FLOOR AT THE ICF WALL

2 253 metal-web joist @ 600 - C24 TOP flange

1:5 - over Beech section A-A (BD0165-ALW rev A)

4 Galvanised steel web

5 Joists TOP-HUNG on a cut-down Strong-Tie ICF
ledger connector cast into the core (ledger
by the engineer, hangers by the joist
supplier)

6 6in XR35 runs straight past the floor - the
core is poured full height, no cold joint at
the floor

7 Dryvit ICF 500 render system on the EPS

8 GF ceiling plasterboard (as Beech)

NOTES
1. FF floor: 253 metal-web joists @ 600 with C24 flanges and galvanised steel webs, 22 Egger
Protect P5 deck. DESIGN ASSUMPTION - joist design by the joist supplier.
2. Joists top-hung on cut-down Strong-Tie ICF ledger connectors cast into the core; the ledger
and its fixings are designed by the engineer.
3. Floor layout and joist profiles: FL-01 / FL-02.
4. 3B4P (semi pair), plots 16-17, building B07. Datum 0 = GF FFL. Architect: Beech
Developments - BD0154-3B4P rev A (JHG 26/10/26).

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

CLIENT
Beech Developments (NW) Ltd

PROJECT
Maes Y Felin, Glan Conwy - 3B4P

DRAWING TITLE
3B4P - FIRST FLOOR DETAIL - TOP-HUNG JOISTS AT THE ICF
