BuildEase2026/mf-icf-approval-1f4119fc49/3B4P/docs/icf/ES26-020-3B4P-EL-02 East and West Elevations.pdf

## FOR APPROVAL - NOT FOR CONSTRUCTION

### ELEVATION SCHEDULES

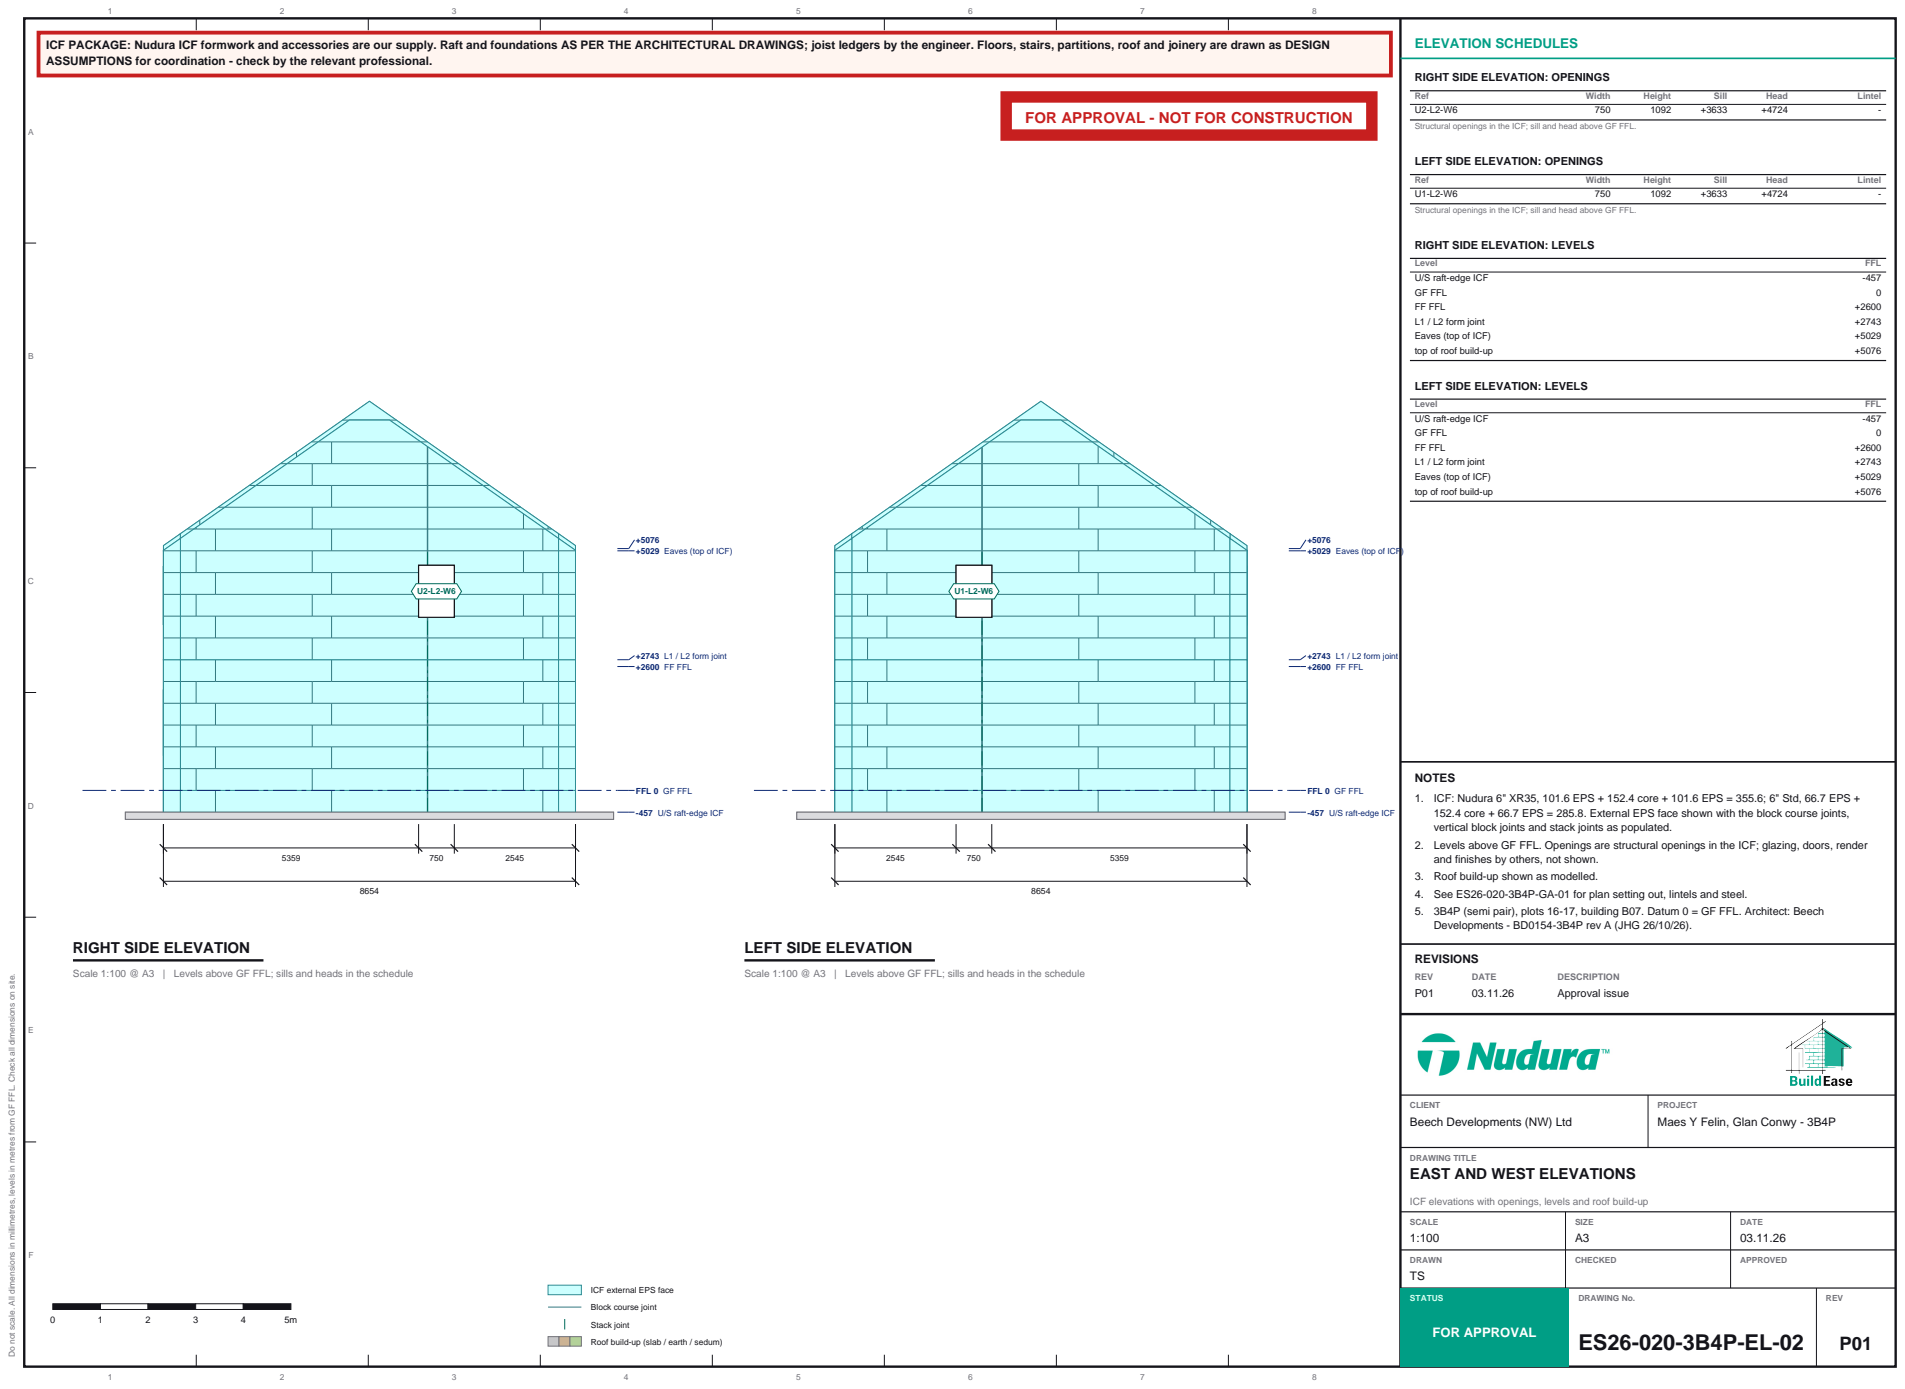
[picture p102: page 1]
+2600 FF FFL; +2743 L1 / L2 form joint; Ref; Width; Height; Sill; Head; Lintel; Level; FFL; U/S raft-edge ICF; GF FFL; FF FFL; L1 / L2 form joint; Eaves (top of ICF); top of roof build-up; REVISIONS; REV; DATE; DESCRIPTION; Approval issue; SCALE 1:100; SIZE A3; DATE 03.11.26; DRAWN TS; CHECKED; APPROVED; STATUS; FOR APPROVAL; DRAWING No. ES26-020-3B4P-EL-02

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

RIGHT SIDE ELEVATION: OPENINGS
Structural openings in the ICF; sill and head above GF FFL.

LEFT SIDE ELEVATION: OPENINGS

RIGHT SIDE ELEVATION: LEVELS

LEFT SIDE ELEVATION: LEVELS

+5029 Eaves (top of ICF)

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

FFL 0 GF FFL

-457 U/S raft-edge ICF

RIGHT SIDE ELEVATION

LEFT SIDE ELEVATION

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

Scale 1:100 @ A3 | Levels above GF FFL; sills and heads in the schedule

CLIENT
Beech Developments (NW) Ltd

PROJECT
Maes Y Felin, Glan Conwy - 3B4P

DRAWING TITLE
EAST AND WEST ELEVATIONS

ICF elevations with openings, levels and roof build-up

ICF external EPS face
Block course joint
Stack joint
Roof build-up (slab / earth / sedum)
