BuildEase2026/mf-icf-approval-1f4119fc49/3B4P/docs/icf/ES26-020-3B4P-GA-02 3B4P - Ground Floor ICF and Partitions.pdf

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

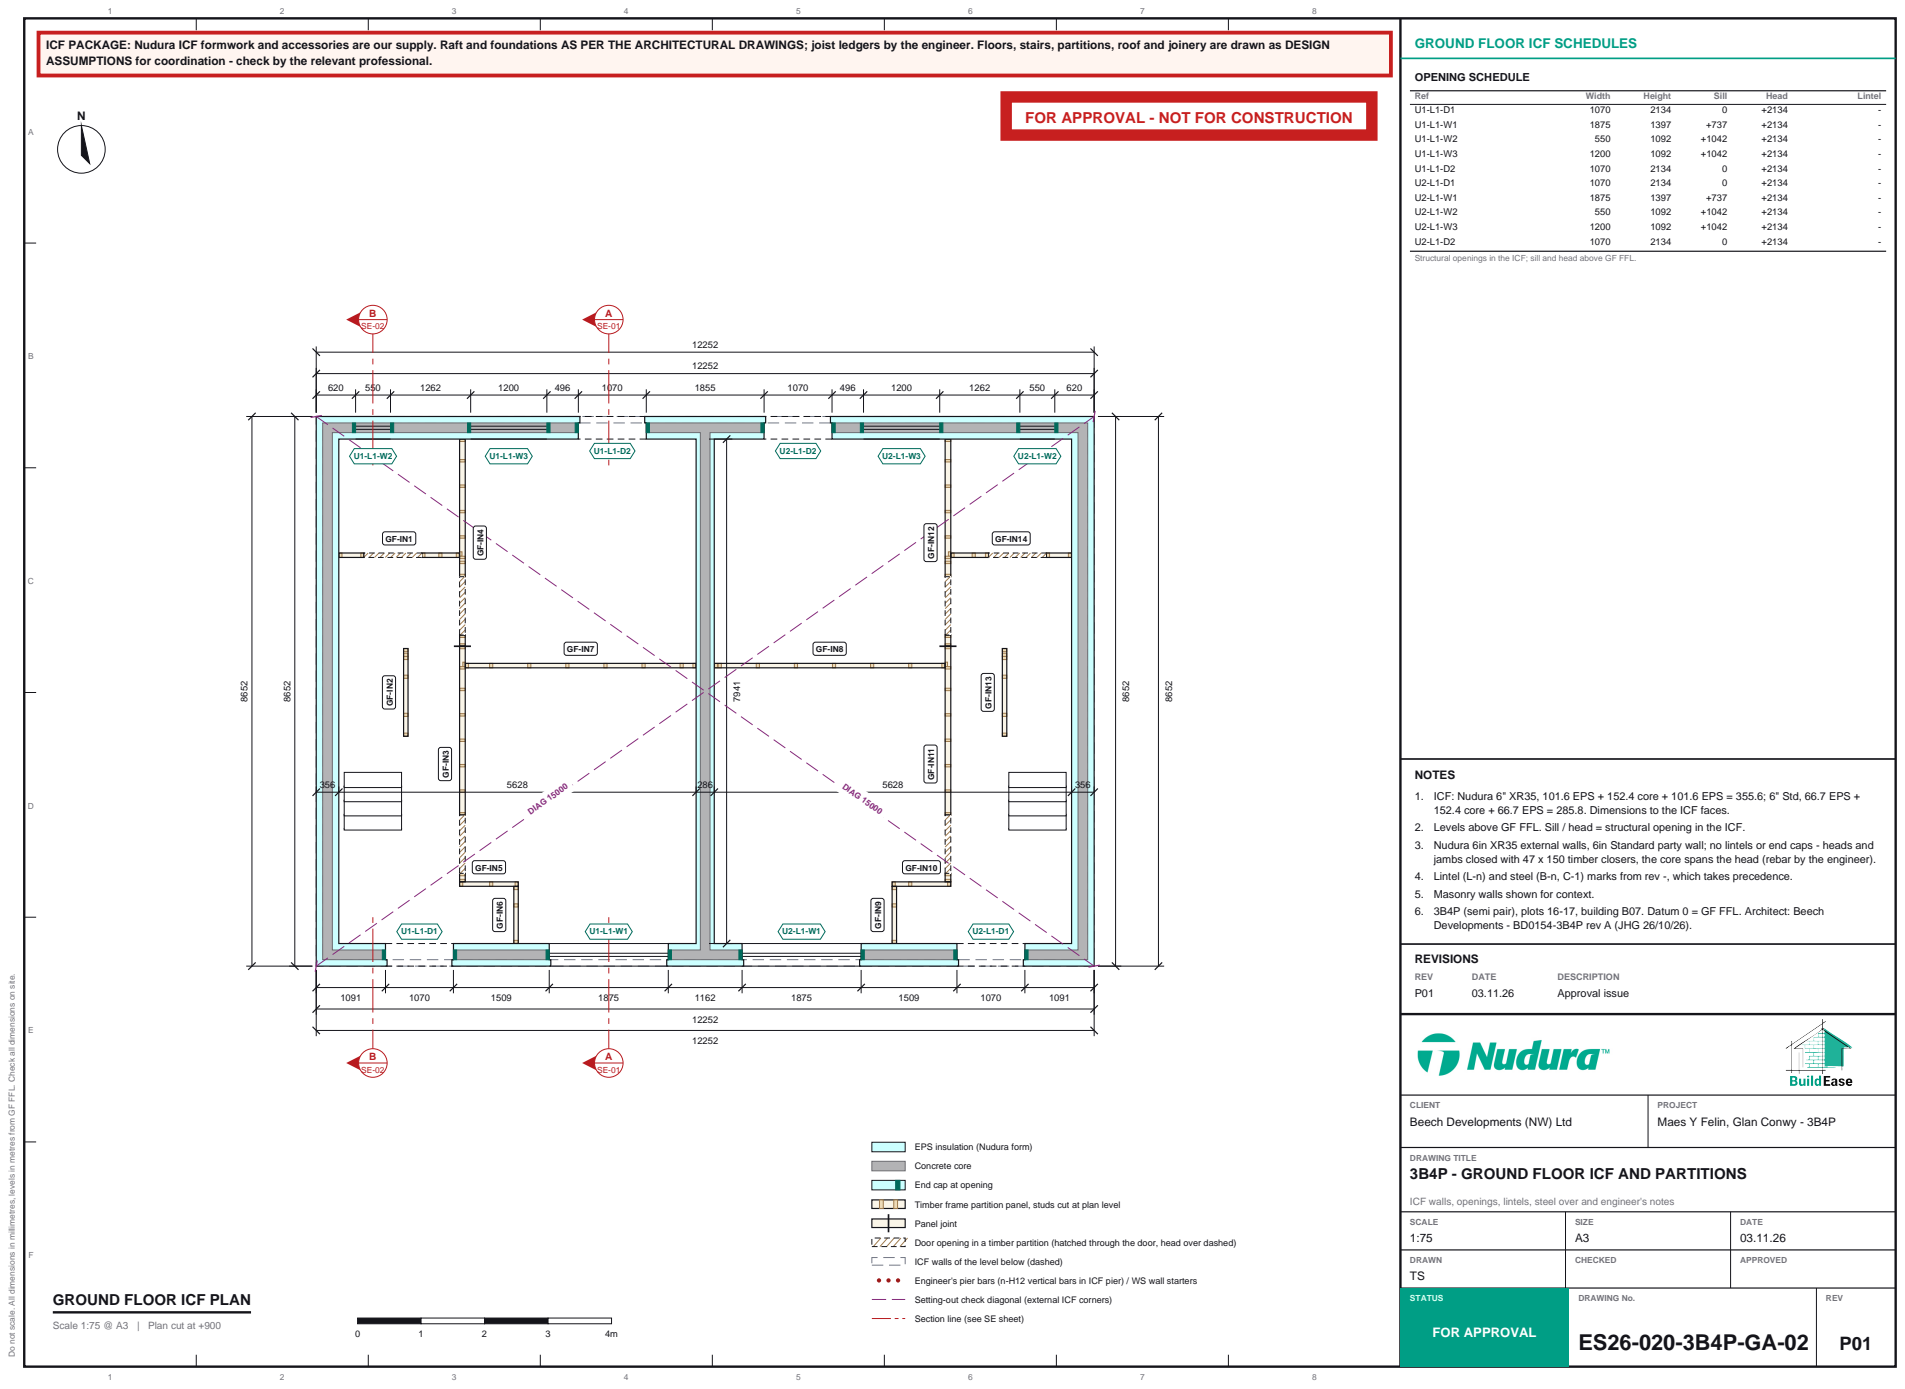
[picture p103: page 1]
Ref; Width; Height; Sill; Head; Lintel; DIAG 15000; GF-IN10GF⁻IN¹¹ GF⁻IN¹²; REVISIONS; REV; DATE; DESCRIPTION; Approval issue; SCALE 1:75; SIZE A3; DATE 03.11.26; DRAWN TS; CHECKED; APPROVED; STATUS; FOR APPROVAL; DRAWING No. ES26-020-3B4P-GA-02

GROUND FLOOR ICF SCHEDULES

OPENING SCHEDULE
Structural openings in the ICF; sill and head above GF FFL.

FOR APPROVAL - NOT FOR CONSTRUCTION

NOTES
1. ICF: Nudura 6" XR35, 101.6 EPS + 152.4 core + 101.6 EPS = 355.6; 6" Std, 66.7 EPS +
152.4 core + 66.7 EPS = 285.8. Dimensions to the ICF faces.
2. Levels above GF FFL. Sill / head = structural opening in the ICF.
3. Nudura 6in XR35 external walls, 6in Standard party wall; no lintels or end caps - heads and
jambs closed with 47 x 150 timber closers, the core spans the head (rebar by the engineer).
4. Lintel (L-n) and steel (B-n, C-1) marks from rev -, which takes precedence.
5. Masonry walls shown for context.
6. 3B4P (semi pair), plots 16-17, building B07. Datum 0 = GF FFL. Architect: Beech
Developments - BD0154-3B4P rev A (JHG 26/10/26).

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

CLIENT
Beech Developments (NW) Ltd

PROJECT
Maes Y Felin, Glan Conwy - 3B4P

EPS insulation (Nudura form)
Concrete core
End cap at opening
Timber frame partition panel, studs cut at plan level
Panel joint
Door opening in a timber partition (hatched through the door, head over dashed)
ICF walls of the level below (dashed)
Engineer's pier bars (n-H12 vertical bars in ICF pier) / WS wall starters
Setting-out check diagonal (external ICF corners)
Section line (see SE sheet)

DRAWING TITLE
3B4P - GROUND FLOOR ICF AND PARTITIONS

ICF walls, openings, lintels, steel over and engineer's notes

GROUND FLOOR ICF PLAN

Scale 1:75 @ A3 | Plan cut at +900
