BuildEase2026/mf-icf-approval-1f4119fc49/3B4P/docs/icf/ES26-020-3B4P-SE-01 Section A-A.pdf

## FOR APPROVAL - NOT FOR CONSTRUCTION

### SECTION A-A SCHEDULES

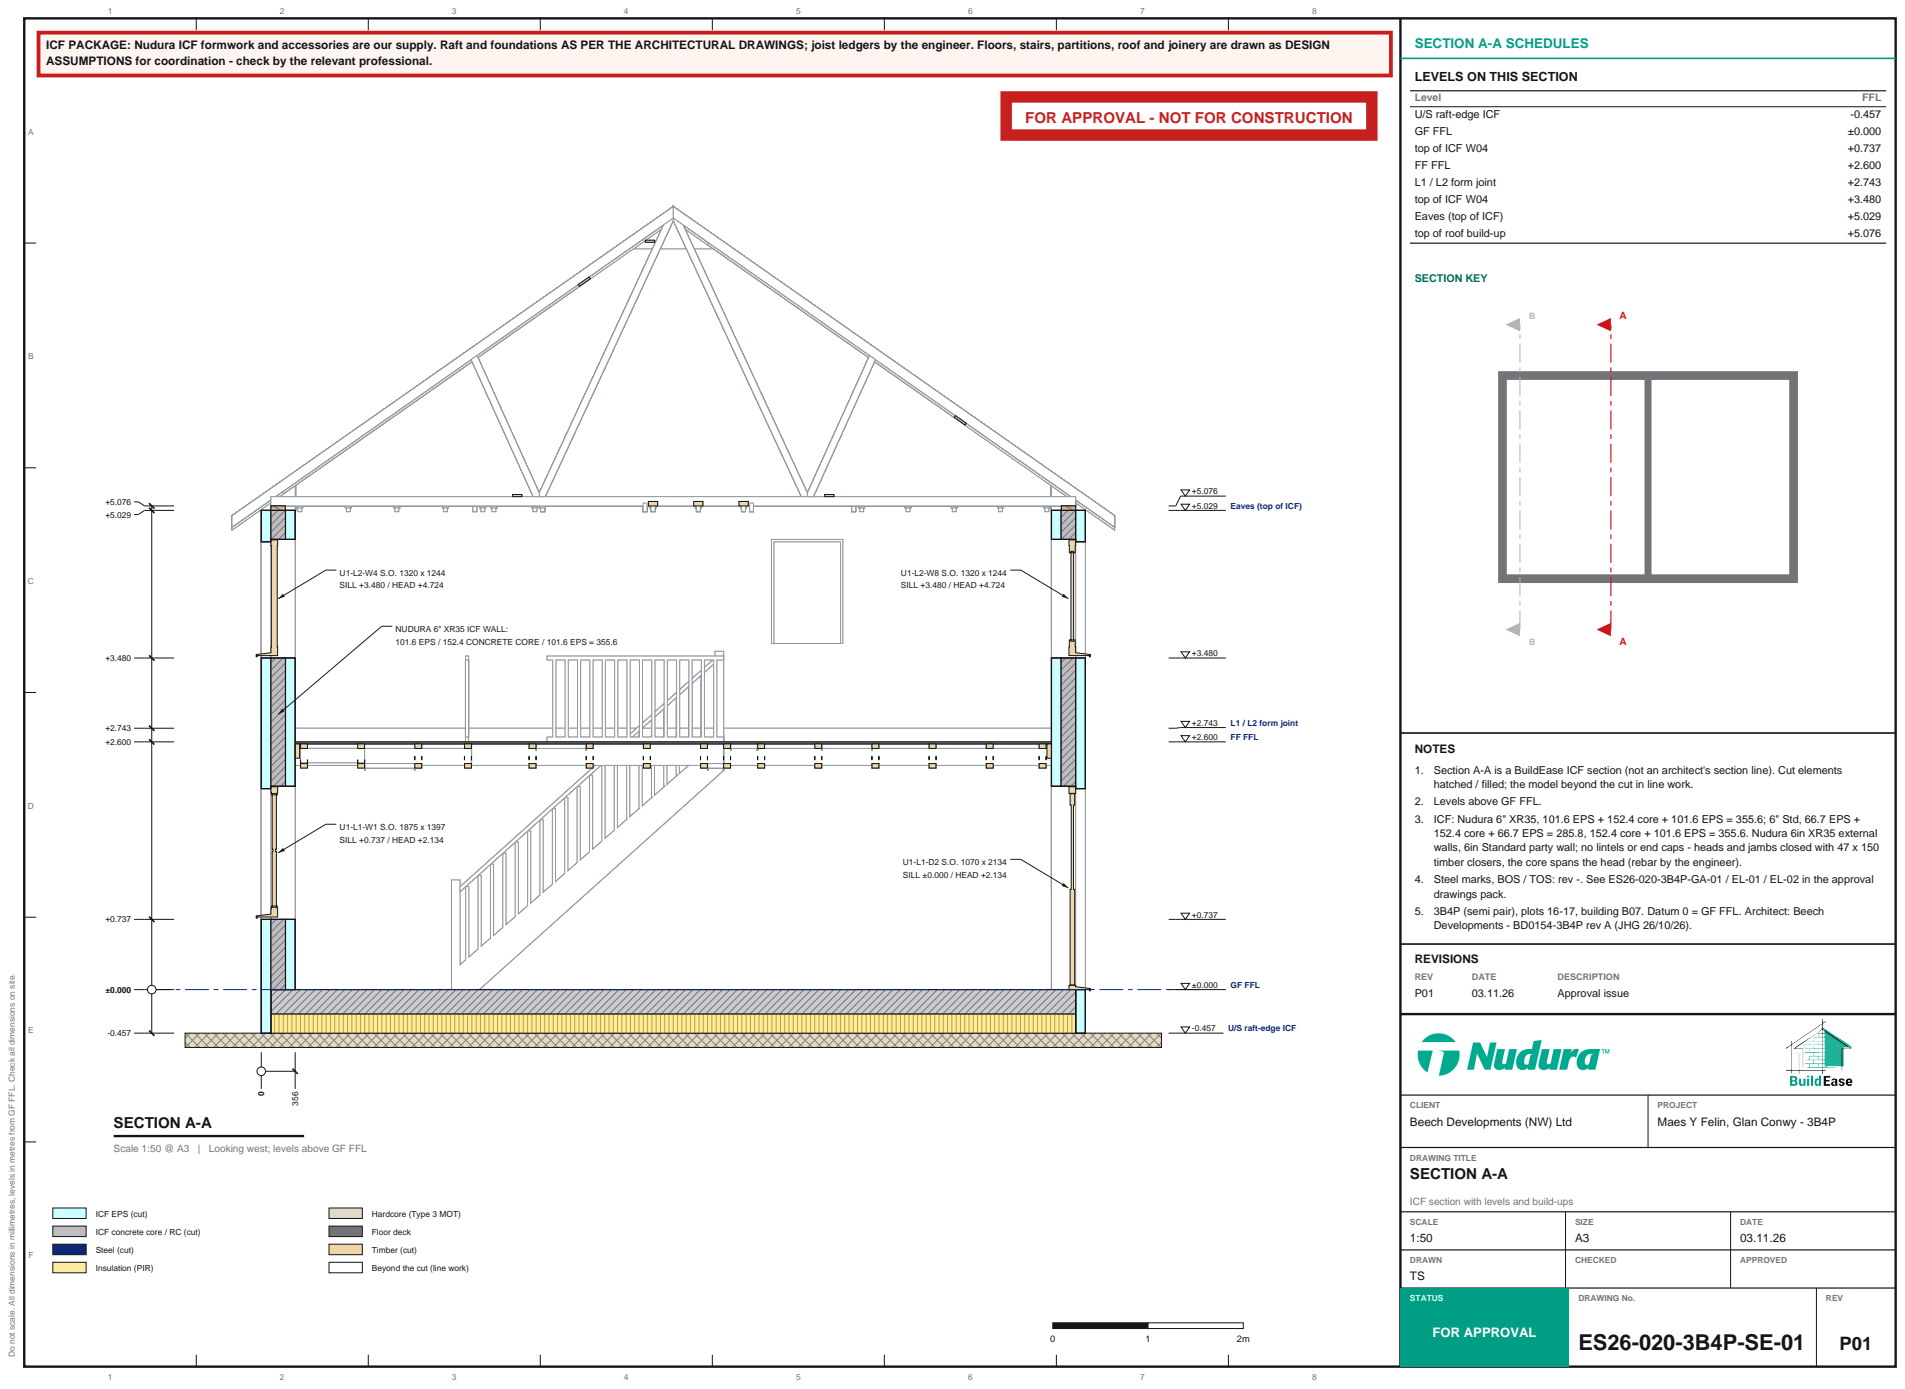
[picture p104: page 1]
U/S raft-edge ICF; GF FFL; FF FFL; L1 / L2 form joint; Eaves (top of ICF); U1-L1-W1 S.O. 1875 x 1397 SILL +0.737 / HEAD +2.134; U1-L1-D2 S.O. 1070 x 2134 SILL ±0.000 / HEAD +2.134; U1-L2-W4 S.O. 1320 x 1244 SILL +3.480 / HEAD +4.724; U1-L2-W8 S.O. 1320 x 1244 SILL +3.480 / HEAD +4.724; SECTION A-A; Level; FFL; top of ICF W04; top of roof build-up; SECTION KEY; REVISIONS; REV; DATE; DESCRIPTION; Approval issue; DRAWING TITLE SECTION A-A; SCALE 1:50; SIZE A3; DATE 03.11.26; DRAWN TS; CHECKED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

LEVELS ON THIS SECTION

NUDURA 6" XR35 ICF WALL:
101.6 EPS / 152.4 CONCRETE CORE / 101.6 EPS = 355.6

NOTES
1. Section A-A is a BuildEase ICF section (not an architect's section line). Cut elements
hatched / filled; the model beyond the cut in line work.
2. Levels above GF FFL.
3. ICF: Nudura 6" XR35, 101.6 EPS + 152.4 core + 101.6 EPS = 355.6; 6" Std, 66.7 EPS +
152.4 core + 66.7 EPS = 285.8, 152.4 core + 101.6 EPS = 355.6. Nudura 6in XR35 external
walls, 6in Standard party wall; no lintels or end caps - heads and jambs closed with 47 x 150
timber closers, the core spans the head (rebar by the engineer).
4. Steel marks, BOS / TOS: rev -. See ES26-020-3B4P-GA-01 / EL-01 / EL-02 in the approval
drawings pack.
5. 3B4P (semi pair), plots 16-17, building B07. Datum 0 = GF FFL. Architect: Beech
Developments - BD0154-3B4P rev A (JHG 26/10/26).

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

CLIENT
Beech Developments (NW) Ltd

PROJECT
Maes Y Felin, Glan Conwy - 3B4P

Scale 1:50 @ A3 | Looking west; levels above GF FFL

ICF section with levels and build-ups

ICF EPS (cut)
ICF concrete core / RC (cut)
Steel (cut)
Insulation (PIR)

Hardcore (Type 3 MOT)
Floor deck
Timber (cut)
Beyond the cut (line work)
