BuildEase2026/mf-icf-approval-1f4119fc49/3B4P/docs/struct/ES26-020-3B4P-FL-02 3B4P - Floor Joist Profiles.pdf

## FOR APPROVAL - NOT FOR CONSTRUCTION

### JOIST TYPES

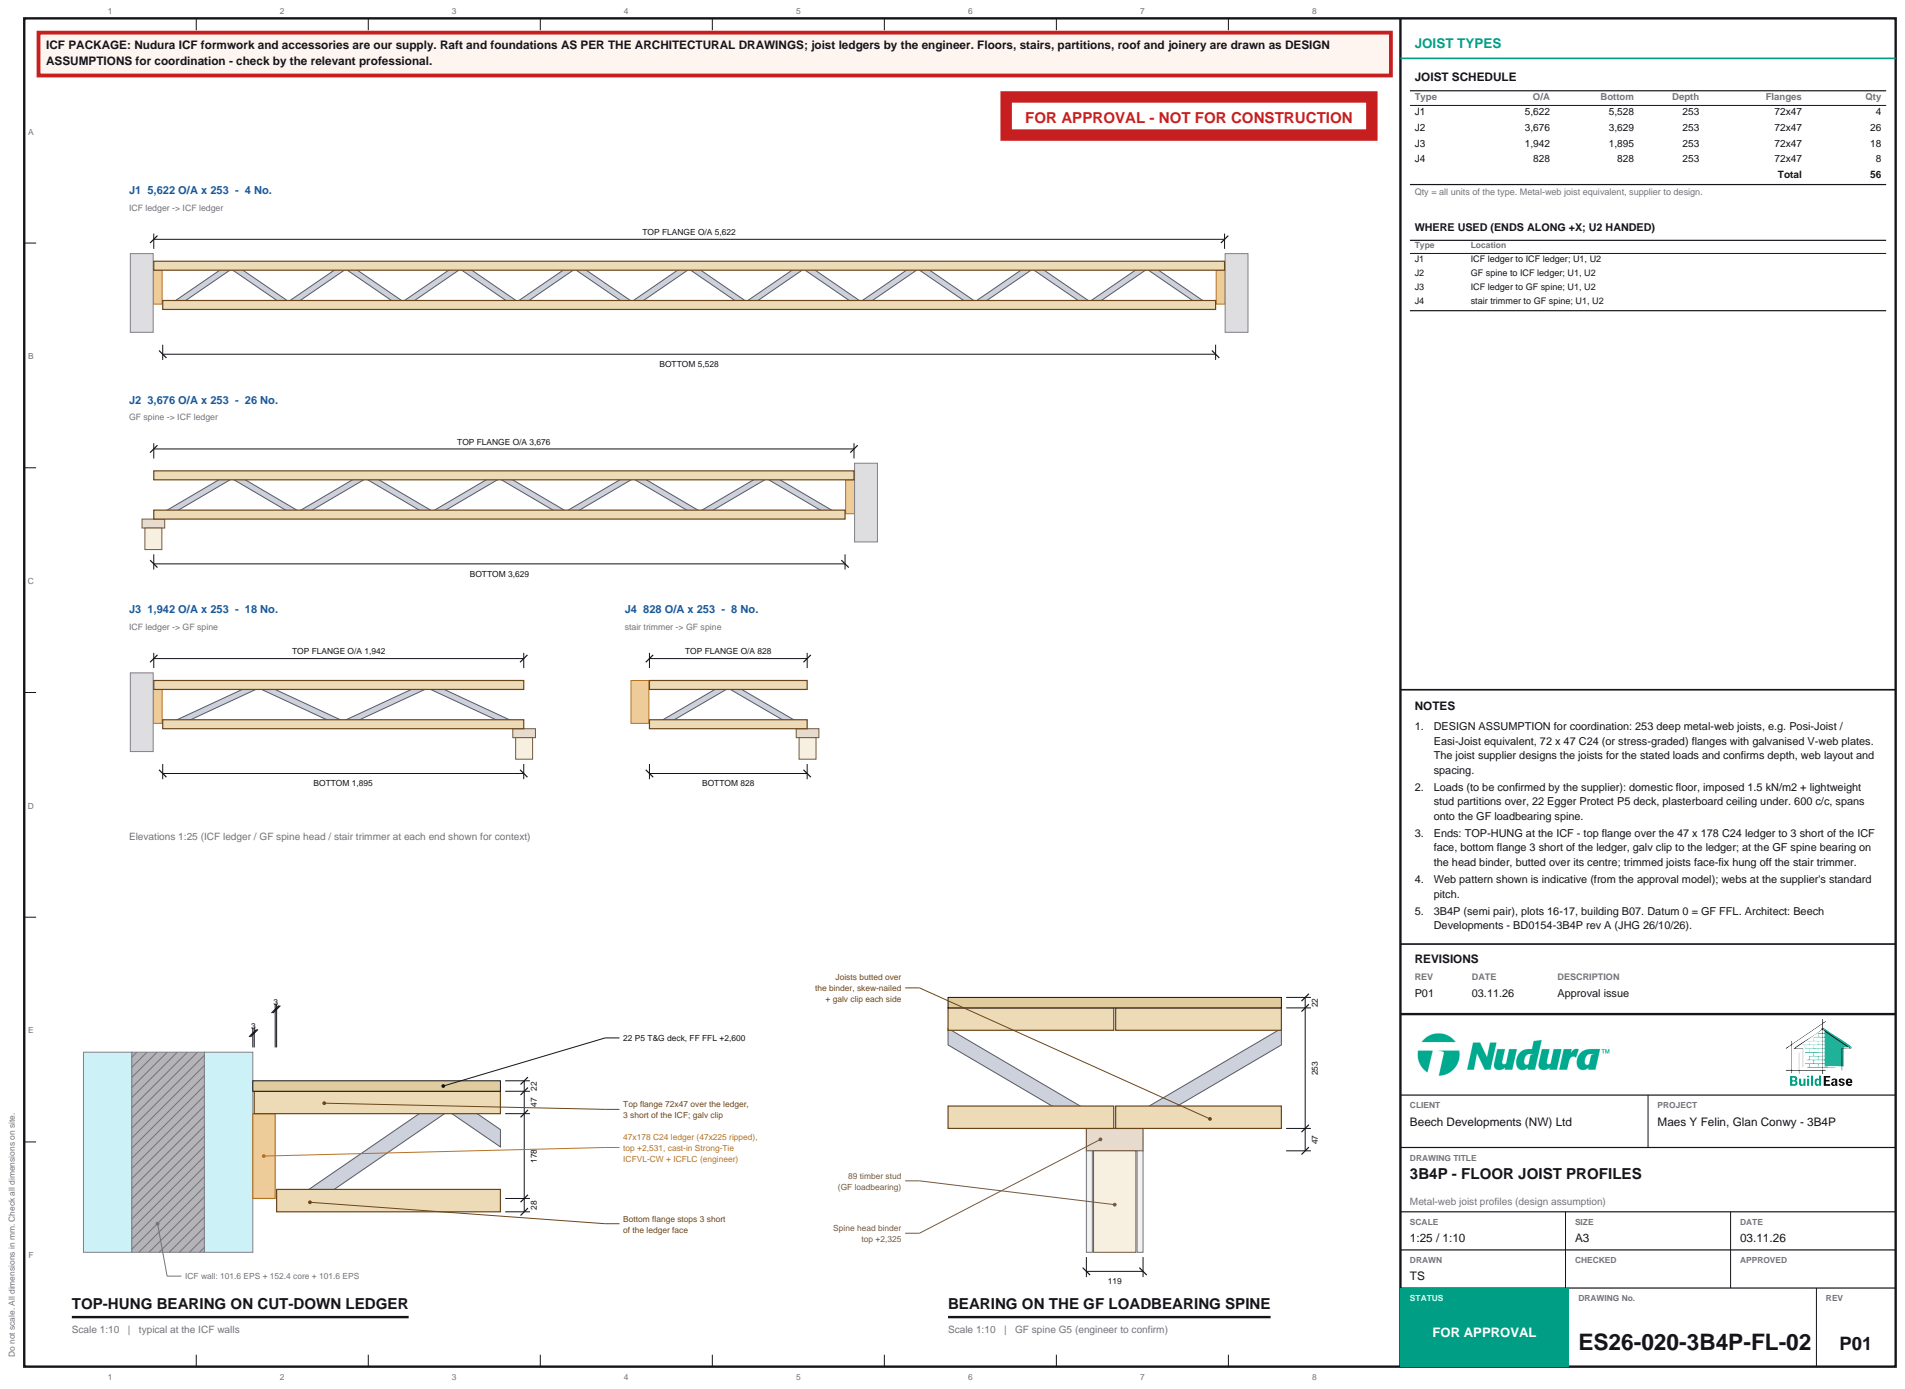
[picture p105: page 1]
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

ICF ledger -> ICF ledger

Qty = all units of the type. Metal-web joist equivalent, supplier to design.

WHERE USED (ENDS ALONG +X; U2 HANDED)

GF spine -> ICF ledger

ICF ledger -> GF spine

stair trimmer -> GF spine

NOTES
1. DESIGN ASSUMPTION for coordination: 253 deep metal-web joists, e.g. Posi-Joist /
Easi-Joist equivalent, 72 x 47 C24 (or stress-graded) flanges with galvanised V-web plates.
The joist supplier designs the joists for the stated loads and confirms depth, web layout and
spacing.
2. Loads (to be confirmed by the supplier): domestic floor, imposed 1.5 kN/m2 + lightweight
stud partitions over, 22 Egger Protect P5 deck, plasterboard ceiling under. 600 c/c, spans
onto the GF loadbearing spine.
3. Ends: TOP-HUNG at the ICF - top flange over the 47 x 178 C24 ledger to 3 short of the ICF
face, bottom flange 3 short of the ledger, galv clip to the ledger; at the GF spine bearing on
the head binder, butted over its centre; trimmed joists face-fix hung off the stair trimmer.
4. Web pattern shown is indicative (from the approval model); webs at the supplier's standard
pitch.
5. 3B4P (semi pair), plots 16-17, building B07. Datum 0 = GF FFL. Architect: Beech
Developments - BD0154-3B4P rev A (JHG 26/10/26).

Elevations 1:25 (ICF ledger / GF spine head / stair trimmer at each end shown for context)

Joists butted over
the binder, skew-nailed
+ galv clip each side

Top flange 72x47 over the ledger,
3 short of the ICF; galv clip

CLIENT
Beech Developments (NW) Ltd

PROJECT
Maes Y Felin, Glan Conwy - 3B4P

Do not scale. All dimensions in mm. Check all dimensions on site.

47x178 C24 ledger (47x225 ripped),
top +2,531, cast-in Strong-Tie
ICFVL-CW + ICFLC (engineer)

Metal-web joist profiles (design assumption)

Bottom flange stops 3 short
of the ledger face

ICF wall: 101.6 EPS + 152.4 core + 101.6 EPS

TOP-HUNG BEARING ON CUT-DOWN LEDGER

BEARING ON THE GF LOADBEARING SPINE

Scale 1:10 | typical at the ICF walls

Scale 1:10 | GF spine G5 (engineer to confirm)
