BuildEase2026/mf-icf-approval-1f4119fc49/ALW/docs/icf/ES26-020-ALW-SE-02 Section B-B.pdf

## FOR APPROVAL - NOT FOR CONSTRUCTION

### SECTION B-B SCHEDULES

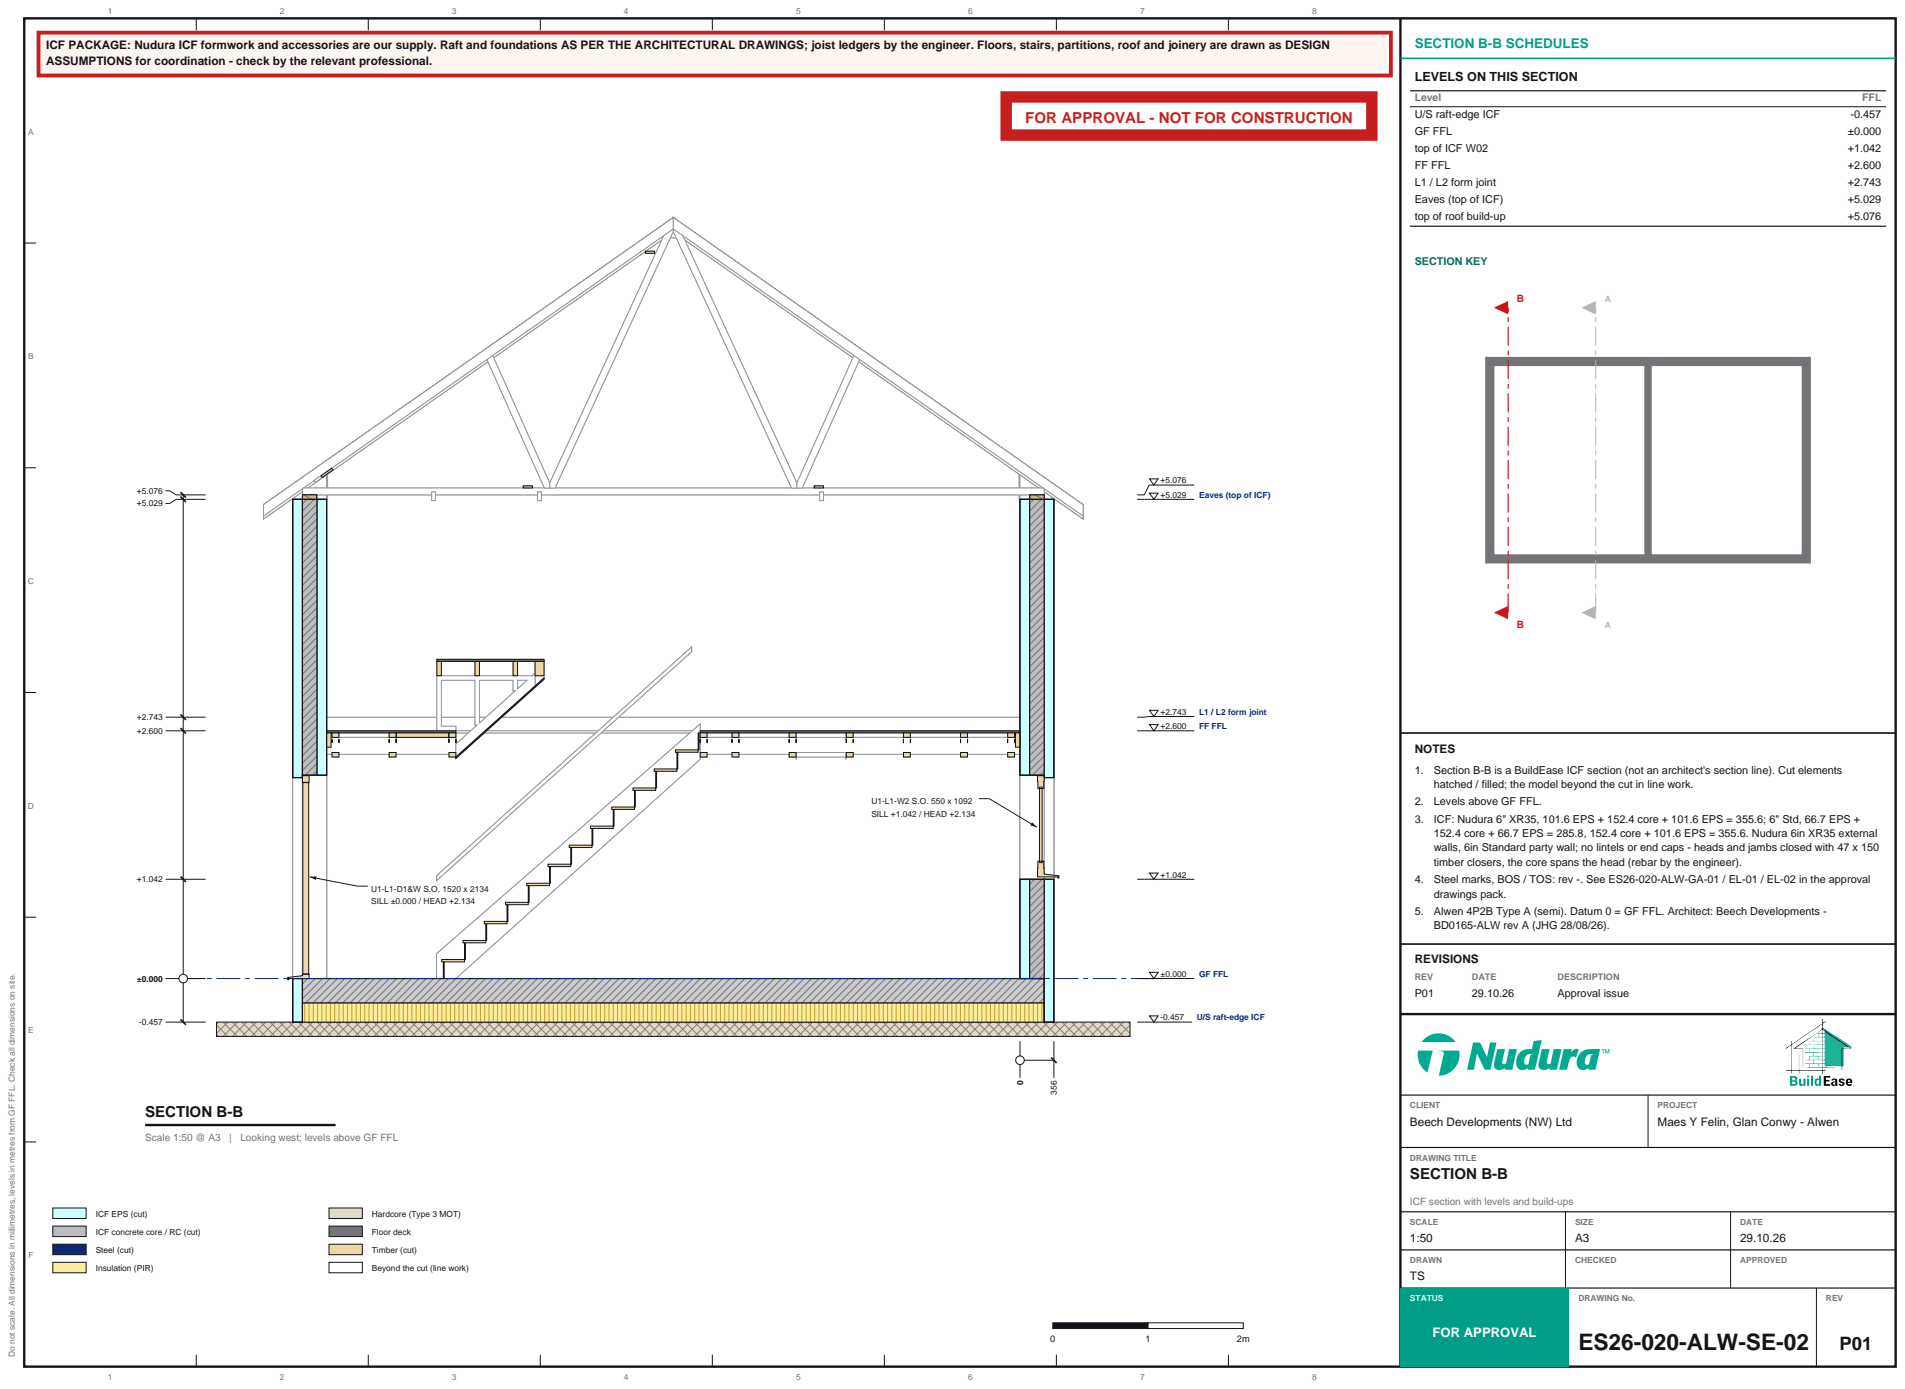
[picture p106: page 1]
U/S raft-edge ICF; GF FFL; FF FFL; L1 / L2 form joint; Eaves (top of ICF); U1-L1-D1&W S.O. 1520 x 2134 SILL ±0.000 / HEAD +2.134; U1-L1-W2 S.O. 550 x 1092 SILL +1.042 / HEAD +2.134; SECTION B-B; Level; FFL; top of ICF W02; top of roof build-up; SECTION KEY; REVISIONS; REV; DATE; DESCRIPTION; Approval issue; DRAWING TITLE SECTION B-B; SCALE 1:50; SIZE A3; DATE 29.10.26; DRAWN TS; CHECKED; APPROVED; STATUS; FOR APPROVAL; DRAWING No. ES26-020-ALW-SE-02

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

LEVELS ON THIS SECTION

NOTES
1. Section B-B is a BuildEase ICF section (not an architect's section line). Cut elements
hatched / filled; the model beyond the cut in line work.
2. Levels above GF FFL.
3. ICF: Nudura 6" XR35, 101.6 EPS + 152.4 core + 101.6 EPS = 355.6; 6" Std, 66.7 EPS +
152.4 core + 66.7 EPS = 285.8, 152.4 core + 101.6 EPS = 355.6. Nudura 6in XR35 external
walls, 6in Standard party wall; no lintels or end caps - heads and jambs closed with 47 x 150
timber closers, the core spans the head (rebar by the engineer).
4. Steel marks, BOS / TOS: rev -. See ES26-020-ALW-GA-01 / EL-01 / EL-02 in the approval
drawings pack.
5. Alwen 4P2B Type A (semi). Datum 0 = GF FFL. Architect: Beech Developments -
BD0165-ALW rev A (JHG 28/08/26).

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

CLIENT
Beech Developments (NW) Ltd

PROJECT
Maes Y Felin, Glan Conwy - Alwen

Scale 1:50 @ A3 | Looking west; levels above GF FFL

ICF section with levels and build-ups

ICF EPS (cut)
ICF concrete core / RC (cut)
Steel (cut)
Insulation (PIR)

Hardcore (Type 3 MOT)
Floor deck
Timber (cut)
Beyond the cut (line work)
