BuildEase2026/mf-icf-approval-1f4119fc49/OGW/docs/icf/ES26-020-OGW-EL-02 East and West Elevations.pdf

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

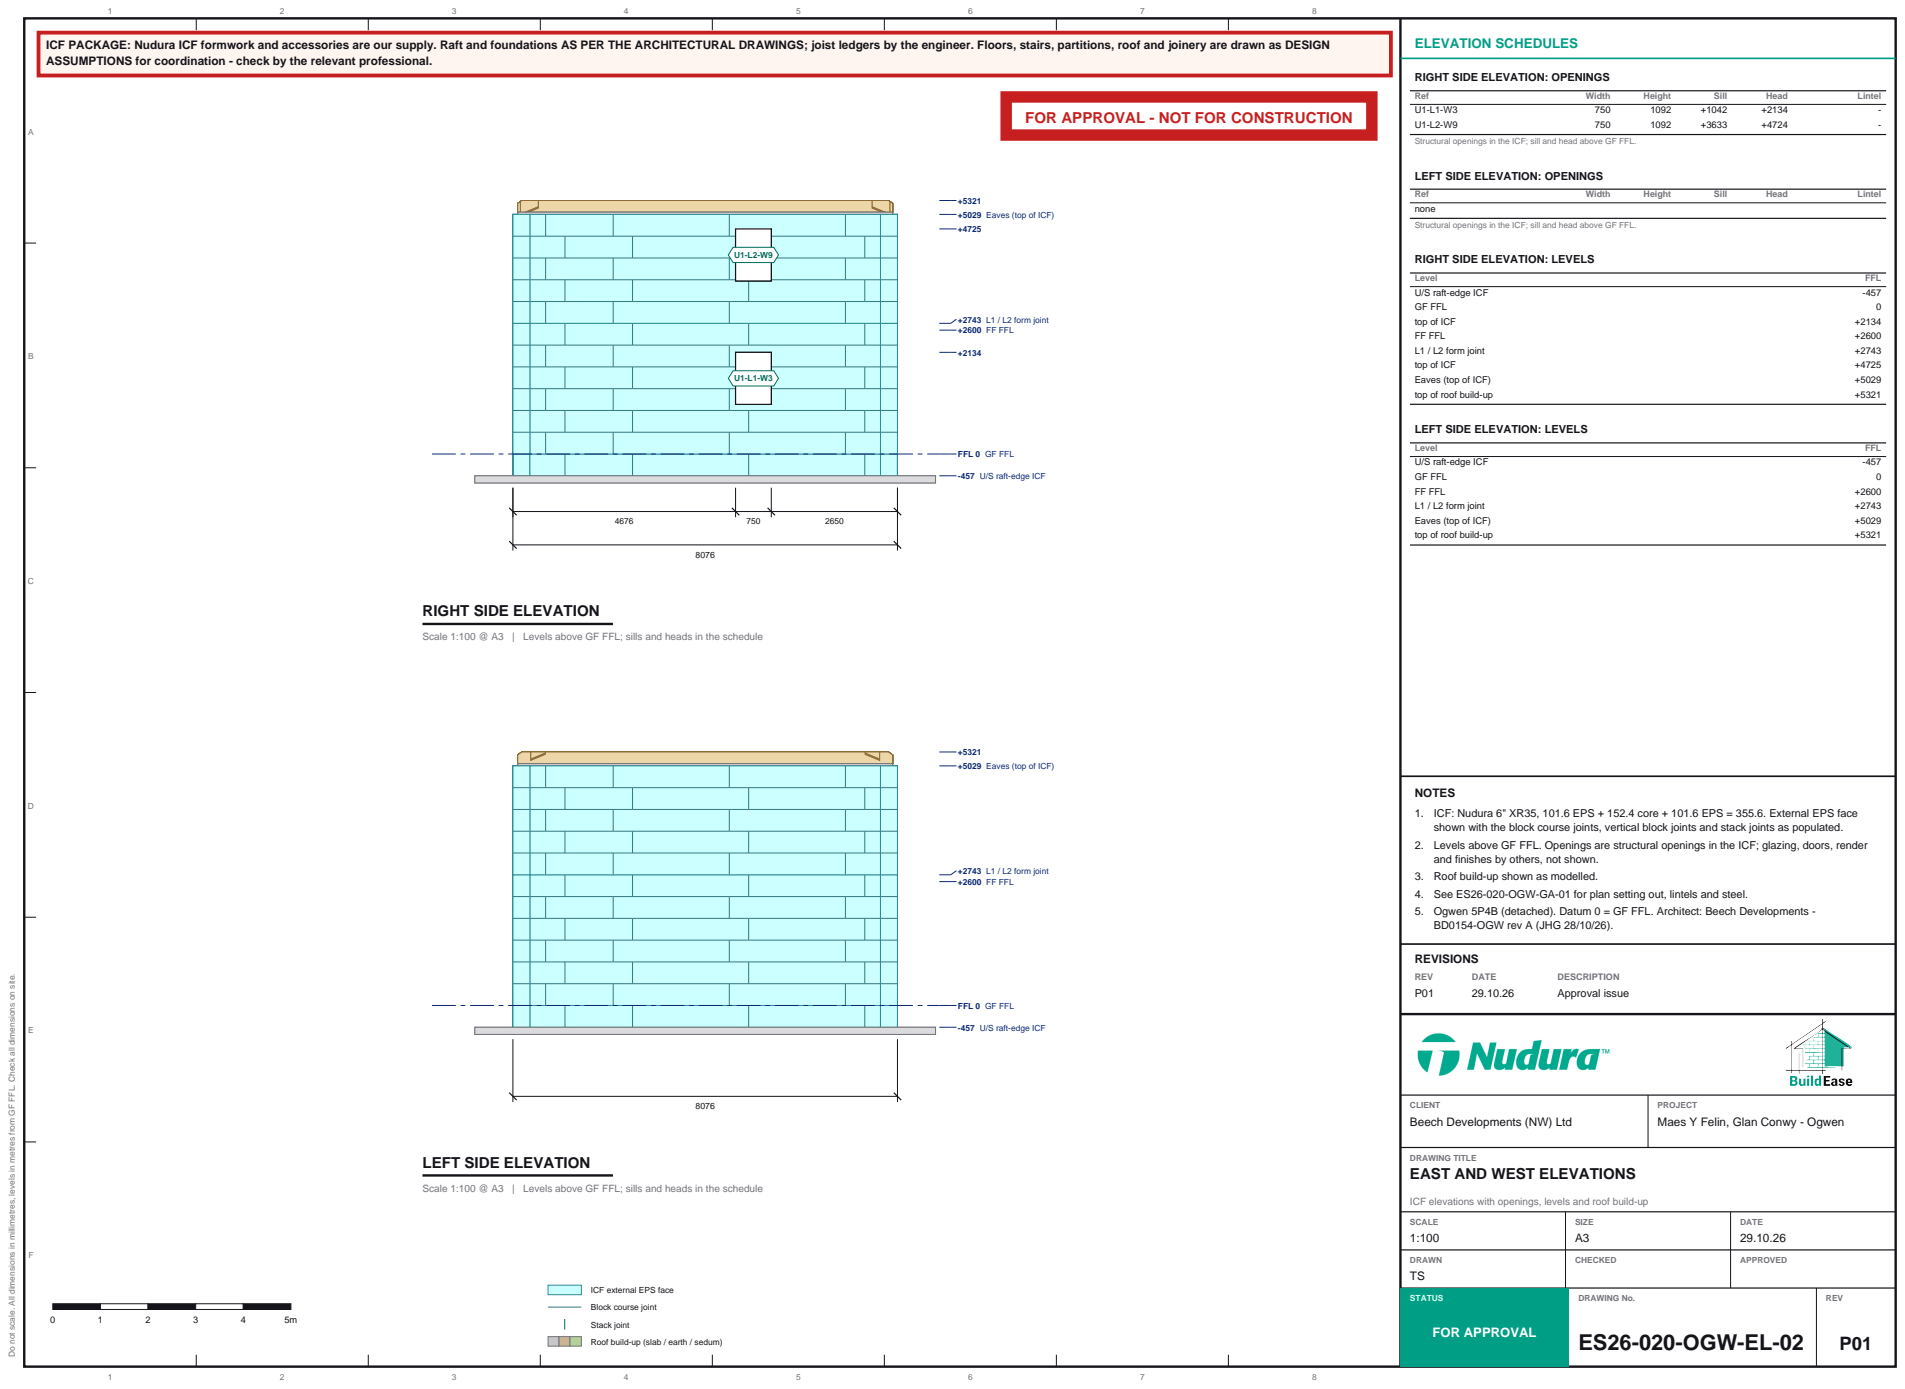
[picture p107: page 1]
+2600 FF FFL; +2743 L1 / L2 form joint; +5029 Eaves (top of ICF); ELEVATION SCHEDULES; Ref; Width; Height; Sill; Head; Lintel; Level; FFL; U/S raft-edge ICF; GF FFL; top of ICF; FF FFL; L1 / L2 form joint; Eaves (top of ICF); top of roof build-up; REVISIONS; REV; DATE; DESCRIPTION; Approval issue; SCALE 1:100; SIZE A3; DATE 29.10.26; DRAWN TS; CHECKED; APPROVED; STATUS; FOR APPROVAL; DRAWING No. ES26-020-OGW-EL-02

RIGHT SIDE ELEVATION: OPENINGS
Structural openings in the ICF; sill and head above GF FFL.

FOR APPROVAL - NOT FOR CONSTRUCTION

LEFT SIDE ELEVATION: OPENINGS
none

RIGHT SIDE ELEVATION: LEVELS

LEFT SIDE ELEVATION: LEVELS

FFL 0 GF FFL

-457 U/S raft-edge ICF

RIGHT SIDE ELEVATION

Scale 1:100 @ A3 | Levels above GF FFL; sills and heads in the schedule

+5029 Eaves (top of ICF)

NOTES
1. ICF: Nudura 6" XR35, 101.6 EPS + 152.4 core + 101.6 EPS = 355.6. External EPS face
shown with the block course joints, vertical block joints and stack joints as populated.
2. Levels above GF FFL. Openings are structural openings in the ICF; glazing, doors, render
and finishes by others, not shown.
3. Roof build-up shown as modelled.
4. See ES26-020-OGW-GA-01 for plan setting out, lintels and steel.
5. Ogwen 5P4B (detached). Datum 0 = GF FFL. Architect: Beech Developments -
BD0154-OGW rev A (JHG 28/10/26).

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

CLIENT
Beech Developments (NW) Ltd

PROJECT
Maes Y Felin, Glan Conwy - Ogwen

LEFT SIDE ELEVATION

DRAWING TITLE
EAST AND WEST ELEVATIONS

ICF elevations with openings, levels and roof build-up

ICF external EPS face
Block course joint
Stack joint
Roof build-up (slab / earth / sedum)
