BuildEase2026/mf-icf-approval-1f4119fc49/OGW/docs/struct/ES26-020-OGW-RF-01 Ogwen - Roof Truss Layout.pdf

## FOR APPROVAL - NOT FOR CONSTRUCTION

### ROOF STRUCTURE SCHEDULES

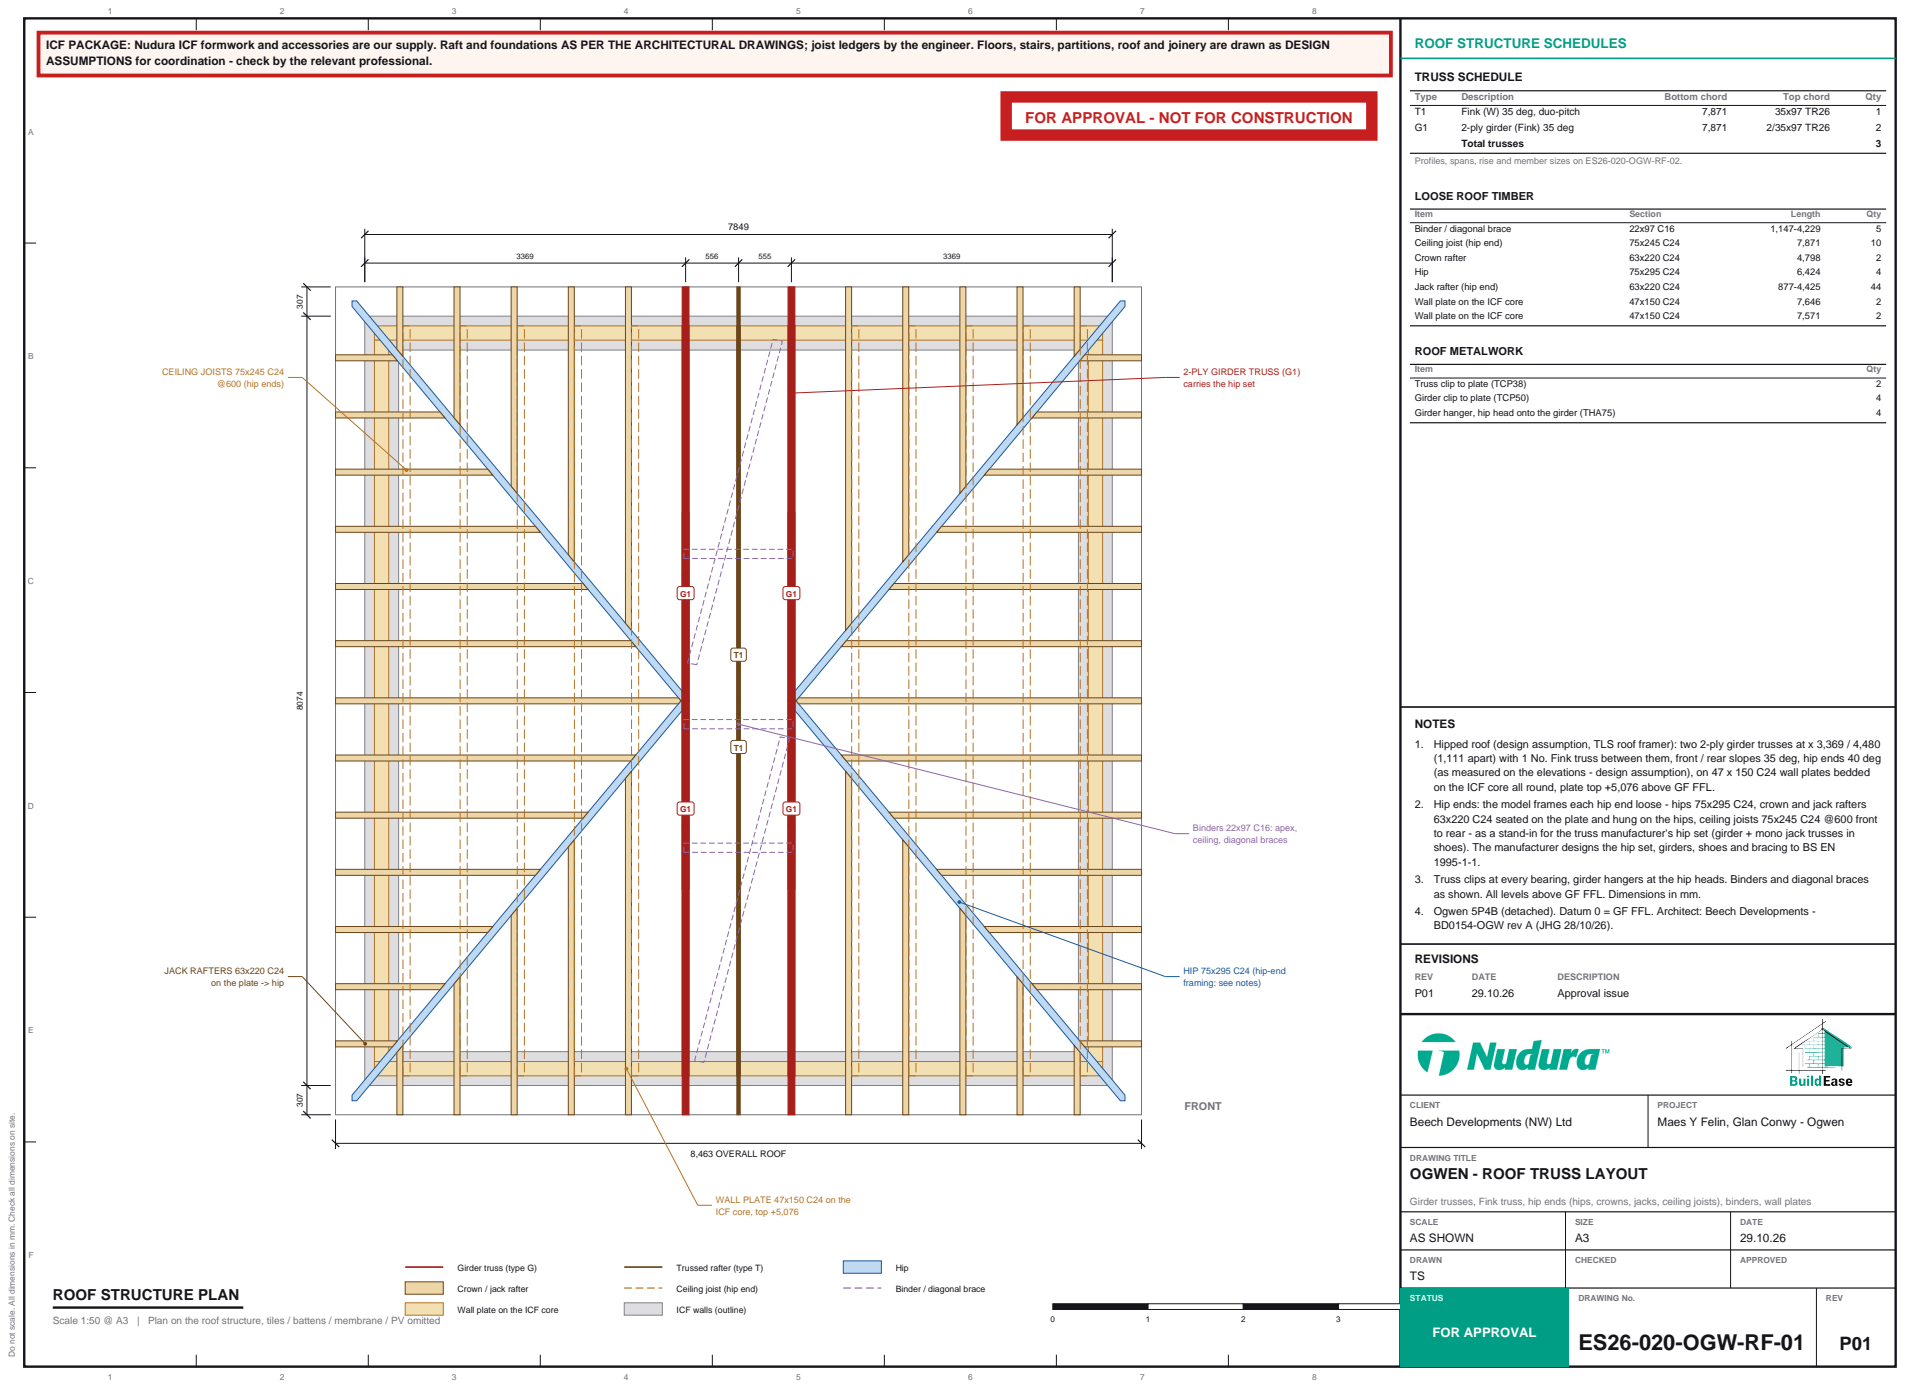
[picture p108: page 1]
TRUSS SCHEDULE; Type; Description; Bottom chord; Top chord; Qty; Fink (W) 35 deg, duo-pitch; 2-ply girder (Fink) 35 deg; Total trusses; Item; Section; Length; Binder / diagonal brace; Ceiling joist (hip end); Crown rafter; Hip; Jack rafter (hip end); Wall plate on the ICF core; ROOF METALWORK; Truss clip to plate (TCP38); Girder clip to plate (TCP50); Girder hanger, hip head onto the girder (THA75); 8,463 OVERALL ROOF; JACK RAFTERS 63x220 C24; CEILING JOISTS 75x245 C24 @600 (hip ends); FRONT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

Profiles, spans, rise and member sizes on ES26-020-OGW-RF-02.

LOOSE ROOF TIMBER

2-PLY GIRDER TRUSS (G1)
carries the hip set

NOTES
1. Hipped roof (design assumption, TLS roof framer): two 2-ply girder trusses at x 3,369 / 4,480
(1,111 apart) with 1 No. Fink truss between them, front / rear slopes 35 deg, hip ends 40 deg
(as measured on the elevations - design assumption), on 47 x 150 C24 wall plates bedded
on the ICF core all round, plate top +5,076 above GF FFL.
2. Hip ends: the model frames each hip end loose - hips 75x295 C24, crown and jack rafters
63x220 C24 seated on the plate and hung on the hips, ceiling joists 75x245 C24 @600 front
to rear - as a stand-in for the truss manufacturer's hip set (girder + mono jack trusses in
shoes). The manufacturer designs the hip set, girders, shoes and bracing to BS EN
3. Truss clips at every bearing, girder hangers at the hip heads. Binders and diagonal braces
as shown. All levels above GF FFL. Dimensions in mm.
4. Ogwen 5P4B (detached). Datum 0 = GF FFL. Architect: Beech Developments -
BD0154-OGW rev A (JHG 28/10/26).

Binders 22x97 C16: apex,
ceiling, diagonal braces

HIP 75x295 C24 (hip-end
framing: see notes)

on the plate -> hip

CLIENT
Beech Developments (NW) Ltd

PROJECT
Maes Y Felin, Glan Conwy - Ogwen

Do not scale. All dimensions in mm. Check all dimensions on site.

DRAWING TITLE
OGWEN - ROOF TRUSS LAYOUT

WALL PLATE 47x150 C24 on the
ICF core, top +5,076

Girder trusses, Fink truss, hip ends (hips, crowns, jacks, ceiling joists), binders, wall plates

ROOF STRUCTURE PLAN
