BuildEase2026/mf-icf-approval-1f4119fc49/POW/docs/struct/ES26-020-POW-RF-01 Powys - Roof Truss Layout.pdf

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

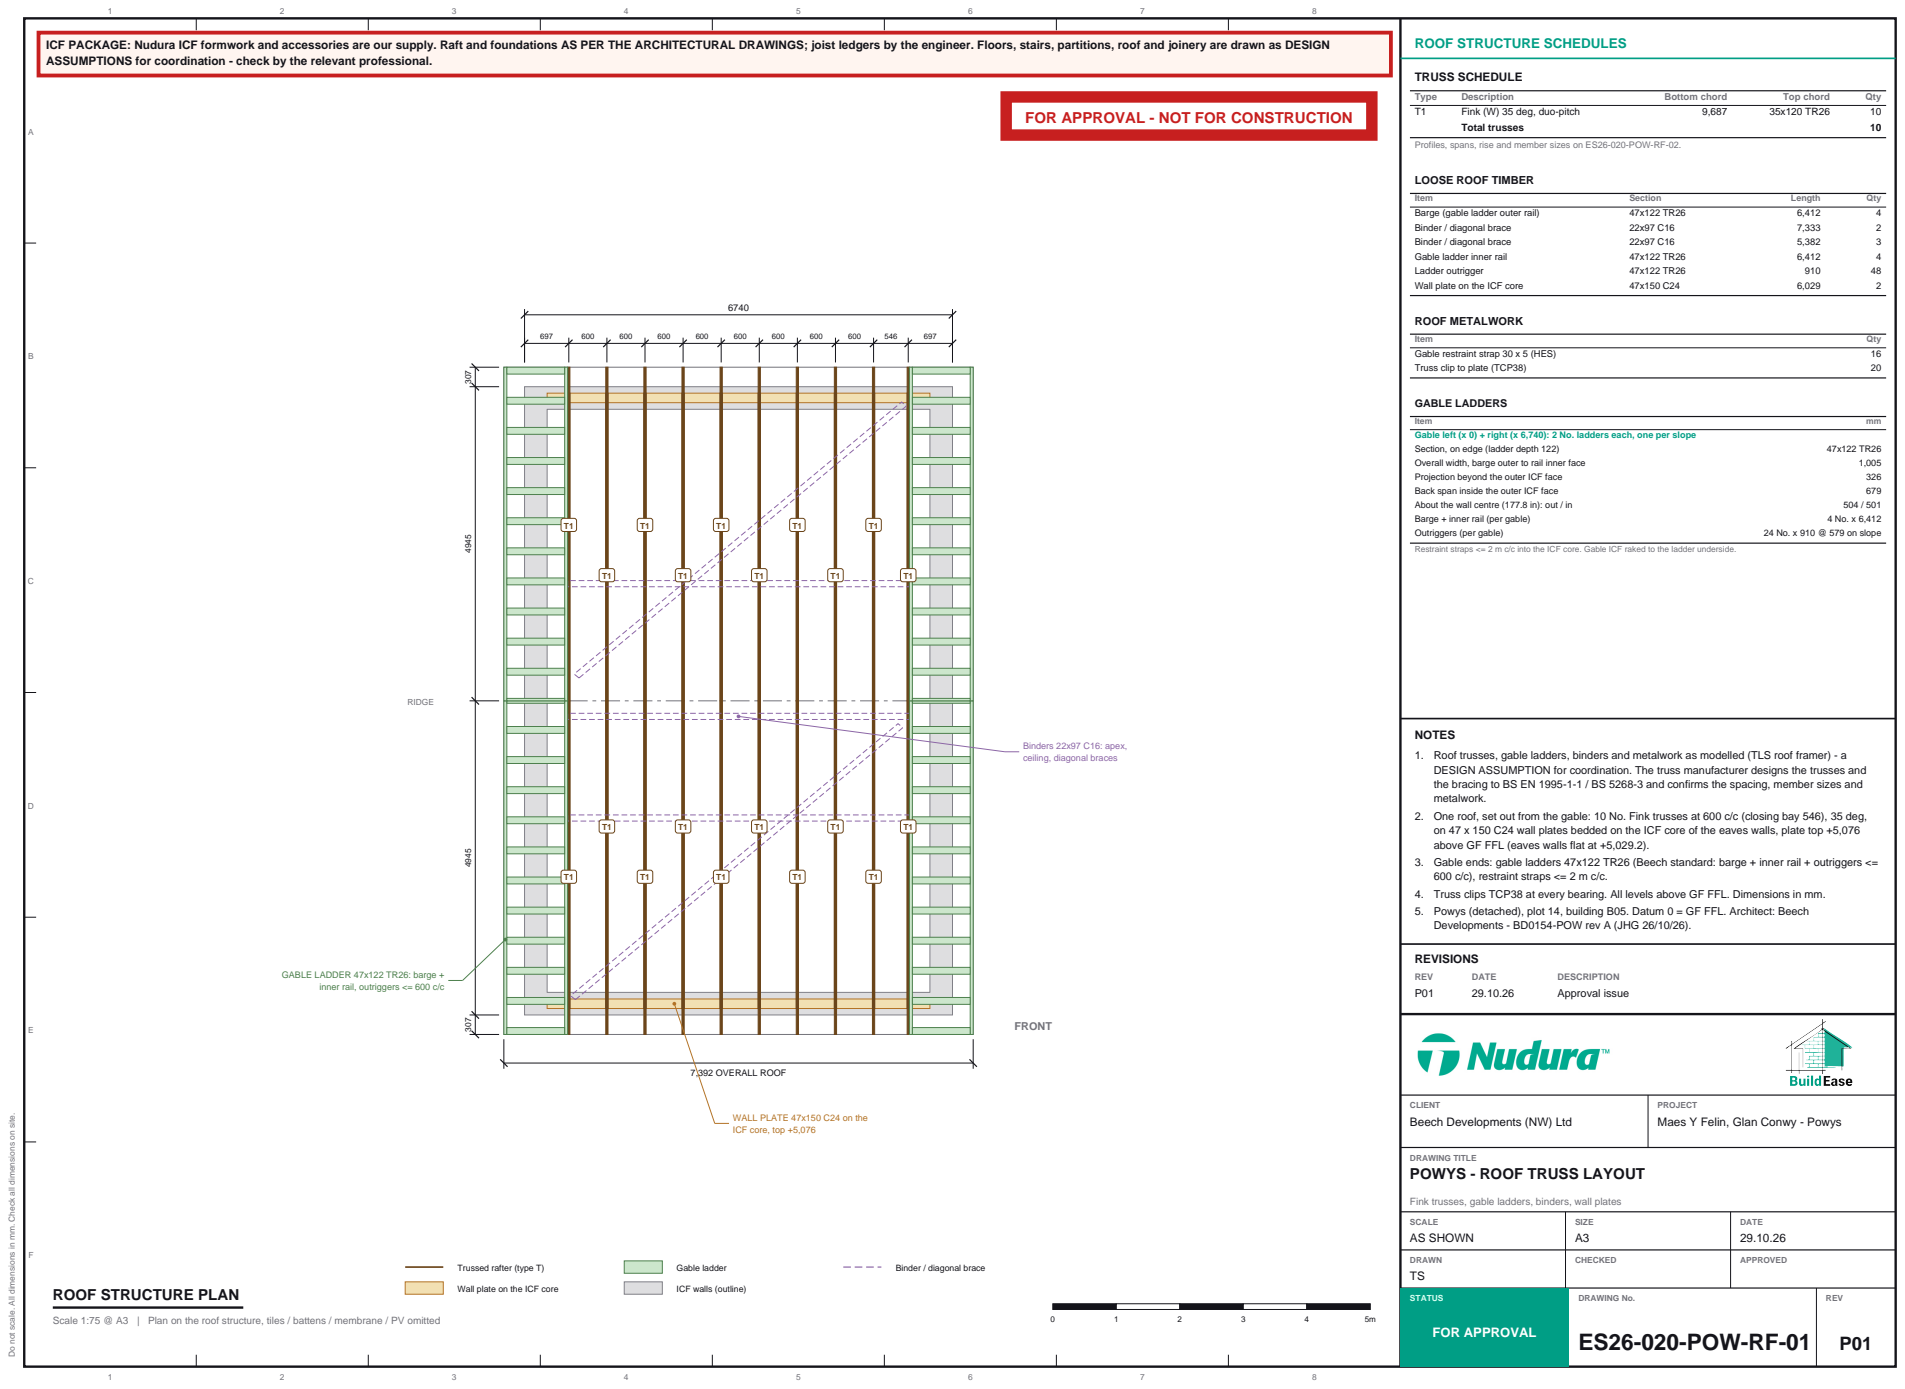
[picture p109: page 1]
TRUSS SCHEDULE; Type; Description; Bottom chord; Top chord; Qty; Fink (W) 35 deg, duo-pitch; Total trusses; Item; Section; Length; Barge (gable ladder outer rail); Binder / diagonal brace; Gable ladder inner rail; Ladder outrigger; Wall plate on the ICF core; ROOF METALWORK; Gable restraint strap 30 x 5 (HES); Truss clip to plate (TCP38); Section, on edge (ladder depth 122); Overall width, barge outer to rail inner face; Projection beyond the outer ICF face; Back span inside the outer ICF face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

ROOF STRUCTURE SCHEDULES

FOR APPROVAL - NOT FOR CONSTRUCTION

Profiles, spans, rise and member sizes on ES26-020-POW-RF-02.

LOOSE ROOF TIMBER

GABLE LADDERS
Gable left (x 0) + right (x 6,740): 2 No. ladders each, one per slope
Restraint straps <= 2 m c/c into the ICF core. Gable ICF raked to the ladder underside.

NOTES
1. Roof trusses, gable ladders, binders and metalwork as modelled (TLS roof framer) - a
DESIGN ASSUMPTION for coordination. The truss manufacturer designs the trusses and
the bracing to BS EN 1995-1-1 / BS 5268-3 and confirms the spacing, member sizes and
metalwork.
2. One roof, set out from the gable: 10 No. Fink trusses at 600 c/c (closing bay 546), 35 deg,
on 47 x 150 C24 wall plates bedded on the ICF core of the eaves walls, plate top +5,076
above GF FFL (eaves walls flat at +5,029.2).
3. Gable ends: gable ladders 47x122 TR26 (Beech standard: barge + inner rail + outriggers <=
600 c/c), restraint straps <= 2 m c/c.
4. Truss clips TCP38 at every bearing. All levels above GF FFL. Dimensions in mm.
5. Powys (detached), plot 14, building B05. Datum 0 = GF FFL. Architect: Beech
Developments - BD0154-POW rev A (JHG 26/10/26).

Binders 22x97 C16: apex,
ceiling, diagonal braces

GABLE LADDER 47x122 TR26: barge +

inner rail, outriggers <= 600 c/c

CLIENT
Beech Developments (NW) Ltd

PROJECT
Maes Y Felin, Glan Conwy - Powys

Do not scale. All dimensions in mm. Check all dimensions on site.

WALL PLATE 47x150 C24 on the
ICF core, top +5,076

DRAWING TITLE
POWYS - ROOF TRUSS LAYOUT

Fink trusses, gable ladders, binders, wall plates

ROOF STRUCTURE PLAN
