BuildEase2026/mf-icf-approval-1f4119fc49/(commit log)

2026-10-30 ES26-020 Maes Y Felin approval portal P01 (Alwen, Ogwen, Powys + build sequence and deliveries)
    [ES26-020-ALW Alwen - SketchUp model P01.skp, ES26-020-OGW Ogwen - SketchUp model P01.skp, ES26-020-POW Powys - SketchUp model P01.skp]
2026-11-03 ES26-020 Maes Y Felin approval portal: add 3B4P (B07, plots 16-17) P01 section
    New house type tab (sheets P01 03.11.26, CAD, model, 6 stages); tab bar on
    ALW/OGW/POW gains the 3B4P tab; build sequence + deliveries include B07.
    [ES26-020-3B4P 3B4P - SketchUp model P01.skp]
